nikolajevs/PCB_EU/softwareEU/README.md

# GI — контроллер PCB_EU

Автоматизированная система управления гроубоксом на базе ESP32: климат-контроль, освещение, вентиляция, автополив и обогрев с веб-интерфейсом управления и облачной телеметрией.

Целевая плата: [PCB_EU](../hardware/PCB_EU/README.md), модуль **ESP32-WROOM-32E-N4, 4 МБ flash, без PSRAM**. Распиновка и состояния выходов взяты из разделов «GPIO и обязательные изменения прошивки» и «nDIM, UVLO и состояния при сбросе» в [DESIGN.md](../hardware/PCB_EU/DESIGN.md). Общее описание — в [README репозитория](../README.md).

## Подключения и выходы PCB_EU

| Функция | Было, GPIO | PCB_EU, GPIO |
|---|---:|---:|
| LED, общий nDIM | 4 | 25 |
| PWM fan1 / fan2 | 13 / 33 | 26 / 27 |
| Тахо fan1 / fan2 | не использовались | 34 / 35 |
| Нагреватель PTC 100 Вт | 27 | 32 |
| Помпа | 25 | 33 |
| Поплавок | 32, INPUT_PULLUP | 14, INPUT, внешняя подтяжка 10k |
| SD CS | 5 | 13 |
| SD SCK / MOSI / MISO | 18 / 23 / 19, по умолчанию SPI | 18 / 23 / 19, явно заданы |
| I²C SDA / SCL | 21 / 22 | 21 / 22, явно заданы |
| RTC, адрес I²C | PCF8563 0x51 / DS3231 0x68 | MCP7940N 0x6F |

`Board.h` задаёт единственную распиновку PCB_EU. Первые действия `setup()` — `OUTPUT LOW` для GPIO25, GPIO32 и GPIO33: LED, PTC и помпа выключены до инициализации шин, NVS и сети. GPIO32 всегда остаётся выходом: он управляет нагревателем 100 Вт, вход и `INPUT_PULLUP` на нём запрещены. GPIO hold на силовых выходах не используется.

Fan PWM — **25 кГц**, с инверсией duty из-за AO3422: логические 0 → GPIO HIGH (минимум/останов вентилятора, если он поддерживает останов); логические 255 → GPIO LOW (полный ход). `fan1`/`fan2` в API и CSV сохраняют логическую шкалу 0–255. При старте GPIO26/27 устанавливаются в LOW; при сбросе/Hi-Z вентиляторы также идут на полном ходу при наличии 12 В. Ошибка настройки PWM оставляет LED/PTC/помпу выключенными, вентиляторы — на полном ходу.

LED nDIM — **1 кГц, 8 бит**. Ноль означает выключение; ненулевой duty ограничен снизу тремя отсчётами (**11,71875 мкс**, не менее 10 мкс). Так же ограничен и промежуток LOW: запрос 254 (промежуток 7,8 мкс) округляется до 255, то есть до постоянного HIGH; 253 оставляет промежуток 11,7 мкс. В состоянии/API/CSV отражается фактически выбранный duty LED.

LED использует канал LEDC 0, вентиляторы — каналы 2 и 3 (`ledcAttachChannel()`). В ядре 3.3.x таймер LEDC выбирается не по номеру канала, а по частоте и разрядности: каналы с одинаковыми частотой и разрядностью делят один таймер. LED (1 кГц) и вентиляторы (25 кГц) поэтому всегда на разных таймерах, и настройка 25 кГц не меняет частоту света. Сборка проверяет `LED_PWM_FREQ != FAN_PWM_FREQ`.

Поплавок замыкает GPIO14 на GND: LOW = вода есть, HIGH = воды нет; подтвердите это на установленном датчике. GPIO34/35 используются только как входы тахо с внешними подтяжками. Импульсы считает аппаратный счётчик PCNT (по спаду) с фильтром помех 10 мкс: наводки от ШИМ на кабеле вентилятора не превращаются в ложные обороты, и прерывание на каждый импульс не нужно. `/api/status` отдаёт `fan1_rpm` и `fan2_rpm`, обновляемые раз в секунду, исходя из двух импульсов на оборот. Ноль означает отсутствие импульсов; больше 15 000 об/мин считается помехой, и вместо числа отдаётся `null`. Обороты не влияют на климат, полив или защиту.

## Часы MCP7940N

Регистры читаются и записываются напрямую через `Wire` по адресу **0x6F**. RTClib используется только для `DateTime` и календарной арифметики. При инициализации включается `VBATEN`; корректно работающие часы сохраняют время. Остановленный календарь не запускается автоматически: сначала выставьте полную дату/время через веб-интерфейс.

Запись времени останавливает генератор, ожидает сброса `OSCRUN`, затем записывает отдельно месяц и год (регистры 0x05–0x06) и после них секунды–число (0x00–0x04) в формате **24 часа** с `VBATEN=1`. Так число никогда не загружается при старом месяце, например 31-е при 30-дневном месяце. Последним устанавливается `ST=1`, после чего прошивка ждёт `OSCRUN=1`. Каждый обмен проверяется; ожидания ограничены тремя секундами, потому что кварц на холоде может запускаться дольше секунды. Дедлайн работающей помпы проверяется и во время этих ожиданий. Запись подтверждается повторным чтением даты/времени. Каждый неудачный шаг пишется в консоль: что именно не получилось и что проверить на плате.

Если запись или проверка не удались, прошивка снова останавливает часы (`ST=0`). Раньше неподтверждённое время через минуту могло снова стать доверенным при автовосстановлении. Теперь до успешной повторной установки часы считаются невыставленными. Страница настроек после отправки формы ждёт итог от платы и показывает «записано и проверено» или «не приняли время».

Время считается достоверным только при `ST=1`, `OSCRUN=1`, `VBATEN=1`, корректных BCD, дне недели 1–7 и существующей дате в диапазоне 2024–2099. Один последовательный обмен читает все семь календарных регистров с аппаратной защитой от переноса секунды/даты. `PWRFAIL` после штатной работы от батарейки не делает время недостоверным.

Чтение часов повторяется до трёх раз: одиночный сбой I²C больше не выбивает часы из доверия. Если не помогли и повторы, `clock_trusted=false`: новый полив блокируется. Уже идущий полив доводится до конца по `millis()` — раньше любой сбой чтения выключал помпу, а день уже был отмечен как политый, и растения оставались без воды до завтра. Резервный отсчёт через `millis()` сохраняет время для интерфейса, климата и CSV, но не разрешает полив. Автовосстановление требует трёх успешных проверок с интервалом 30 секунд; ручная установка разрешает полив только после успешного чтения MCP7940N. CR2032 питает часы только при включённом `VBATEN`.

`/api/status` отдаёт `rtc_status`: `ok` (часы читаются), `not_set` (микросхема отвечает, но часы остановлены или дата неверна) или `no_response` (нет ответа по I²C), и `time_set`: итог последней установки часов (`none`, `pending`, `ok`, `failed`). Главная страница по ним показывает «Часы не выставлены», «Часы RTC не отвечают» или «Проверка часов» (часы снова читаются, доверие вернётся примерно через минуту).

## Измерение мощности INA226

INA226 на I²C **0x40** измеряет всё, что плата берёт от блока питания 24 В: свет, обогрев, вентиляторы, насос и саму электронику. Шунт 5 мОм (два 0R01 2512 параллельно) стоит в обратном проводе после Q102, напряжение берётся с +24V_FUSED через R113 1 кОм. Значения взяты из раздела «Измерение мощности (INA226)» в `hardware/PCB_EU/DESIGN.md` (изменение платы — PR #70). Пока INA226 нет на плате, главная просто показывает «нет данных».

- При старте и затем раз в 30 секунд, пока микросхема не найдена, прошивка проверяет ID производителя (0xFE = 0x5449) и записывает конфигурацию 0x4727 (усреднение 64, 1,1 мс) и калибровку 2048.
- Раз в секунду из `loop()` читаются напряжение шунта и шины: ток = код × 2,5 мкВ / 5 мОм, напряжение = код × 1,25 мВ × 1,0012 (поправка на R113), мощность = напряжение × ток.
- Раз в 30 секунд прошивка сверяет регистр конфигурации и при расхождении (микросхема сбросилась при просадке) записывает его заново. Три неудачных чтения подряд — показания пропадают, поиск снова раз в 30 секунд.
- Энергия за сегодня (кВт·ч) считается с полуночи или с последнего включения платы.
- Без калибровки показания точны примерно до ±3–5%. Поправка тока задаётся на вкладке «Общее» (`power_cal_pct`, от −20 до +20%).

Мощность только показывается и пишется в журнал: управление светом, обогревом и поливом от неё не зависит. Если INA226 не отвечает, главная показывает «нет данных», всё остальное работает как обычно. Ниже 21,6 В главная предупреждает о низком напряжении питания.

В `/api/status` добавлены `power_ok`, `bus_v`, `current_a`, `power_w`, `bus_low` (последние четыре — только при `power_ok=true`) и `energy_kwh`. В Ubidots уходит переменная `power` (Вт). В CSV последним столбцом добавлен `power_w`: средняя мощность за 10-минутный интервал, пустая, если в этот интервал данных не было.

## Возможности

На главной странице показатели расположены попарно: температура и влажность; вентиляторы 1 и 2; потребление и лампа; насос и обогреватель в блоке «Силовые цепи». Две колонки сохраняются на телефоне. В режиме сушки лампа и насос скрыты, потребление и обогреватель занимают свои ряды целиком.

- **Климат-контроль** — датчик SHT4x (температура/влажность), поддержание заданной температуры с гистерезисом
- **Освещение** — управление LED по расписанию день/ночь, яркость связана с температурным контролем
- **Вентиляция** — два независимых канала PWM-управления вентиляторами (fan1/fan2) с настраиваемыми мин/макс пределами
- **Автополив** — планировщик по дням недели (битовая маска), защита от повторного срабатывания
- **Обогрев** — PTC 100 Вт с гистерезисом, три режима расписания: день/ночь/всегда, жёсткий предел 60 °C
- **Мощность** — INA226: ватты, вольты, амперы и кВт·ч за сегодня на главной, в CSV и Ubidots
- **Безопасность** — аварийное отключение при потере связи с датчиком SHT4x, защита от деления на ноль в расчётах
- **Веб-интерфейс** — вкладки настроек, интерактивные SVG-графики с тултипами, статика лежит в SPIFFS
- **Хранение данных** — логирование в CSV на SD-карту, настройки — в NVS (Preferences)
- **Облако** — телеметрия в Ubidots по HTTPS через отдельную FreeRTOS-задачу на Core 0

## Структура проекта

```
softwareEU/
├── softwareEU.ino     # основная прошивка ESP32
├── Board.h          # GPIO PCB_EU, PWM, тахометры, константы INA226
├── Safety.h         # календарь, MCP7940N, полив, антидребезг, термостат обогрева
├── UbidotsCA.h      # корневой сертификат ISRG Root X1 для HTTPS Ubidots
├── SafetyTests.h    # проверки, выполняемые при каждой сборке
└── data/            # файлы веб-интерфейса (SPIFFS)
    ├── index.html
    ├── settings.html
    ├── script.js
    ├── settings.js
    └── style.css
```

## Технологический стек

- ESP32 (Arduino framework, ядро esp32 3.x — используются `ledcAttachChannel()`, `entry.path()` и драйвер PCNT `driver/pulse_cnt.h`)
- ESPAsyncWebServer + AsyncTCP
- SPIFFS (веб-интерфейс из `softwareEU/data/`, заливается через Tools → ESP32 Sketch Data Upload)
- MCP7940N (прямые I²C-регистры); RTClib только для `DateTime` и планирования день/ночь
- Adafruit SHT4x
- SD-карта (CSV-логирование)
- Ubidots (облачная телеметрия, HTTPS)

## Как устроены данные

Всё, что задаёт пользователь, лежит в `struct Settings`, всё, что происходит сейчас, — в `struct State`. Обе структуры — простые данные без `String`, и между задачами они передаются только целыми копиями под спинлоком:

- `Settings` меняет только обработчик `/save-settings`: разбирает форму в свою копию и публикует её целиком. `loop()` раз в секунду берёт свежую копию, задача Ubidots — перед каждой отправкой.
- `State` пишет только `loop()`, в свою рабочую копию `state`, и публикует её в конце каждой итерации. Веб и Ubidots читают `stateSnapshot()`.

Каждая настройка описана одной строкой в таблице `SETTING_DEFS`: имя в форме и JSON, ключ NVS, диапазон, значение по умолчанию. Из неё работают загрузка из NVS, разбор формы, сохранение и `/api/settings`. Чтобы добавить настройку, нужно поле в `Settings` и строка в таблице; если тип строки не совпадёт с типом поля, прошивка не соберётся.

Пространство NVS `grow-box`, ключи настроек, `last_water`, пароли и маркеры миграций сохранены. Обновление прошивки не требует очистки NVS; при загрузке выбирайте сохранение flash, без полного стирания. Ключи NVS в таблице менять нельзя: по ним читаются сохранённые значения.

## Веб-API

| Метод | Путь | Назначение |
|---|---|---|
| GET | `/api/status` | Текущее состояние (снимок `State`) и режим `operation_mode`: климат, выходы, обороты, часы (`rtc_status`, `time_set`), поплавок (`water_present`), день последнего полива (`last_water_day`), мощность |
| GET | `/api/settings` | Все настройки. Пароли и токен **не отдаются** — только флаги `wifi_pass_set` / `ap_pass_set` / `ubidots_token_set` |
| GET | `/api/console` | Кольцевой буфер сообщений Serial |
| GET | `/api/log?date=YYYY-MM-DD` | CSV-лог за день. Формат даты проверяется строго |
| GET | `/api/files` | Последние файлы в корне SD |
| POST | `/api/clearlogs` | Удаляет из корня SD файлы `*.csv`. Именно POST: GET-версию можно было вызвать со сторонней страницы |
| POST | `/save-settings` | Сохранение настроек. Пустое поле пароля/токена = «не менять»; стереть пароль — галочкой «сеть без пароля». Пустая дата начала сбрасывает цикл. Ответ — редирект на `/settings?saved=1` или `?error=…` |
| POST | `/set-time` | Установка часов, с секундами или без. Применяется в `loop()`, к I2C обращается только он. Ответ — редирект на `/settings?time=1`; итог страница берёт из `time_set` в `/api/status` |

## Примечание по безопасности

Учётные данные WiFi и Ubidots хранятся в NVS Preferences. В исходниках нет рабочих паролей и токенов. Все страницы и API требуют входа `admin` с индивидуальным паролем устройства (HTTP Digest). Изменяющие запросы дополнительно требуют CSRF-токен; очистка SD доступна только через POST.

Сохранённые пароли и токен не возвращаются через API. Пустое поле пароля/токена означает «оставить прежнее значение». Для открытой сети роутера и отключения облака есть отдельные флажки удаления секрета. Точка доступа самой платы всегда защищена паролем.

Ubidots использует HTTPS с проверкой сертификата через ISRG Root X1. Для проверки срока сертификата плата синхронизирует системное UTC-время через NTP; это не изменяет локальное расписание MCP7940N. При недоступности доверенного TLS-соединения данные не отправляются; небезопасного fallback нет. Корневой сертификат находится в `softwareEU/UbidotsCA.h` и может требовать обновления при смене цепочки сервера.

Локальный веб-интерфейс остаётся HTTP: Digest не шифрует содержимое страниц и форм. Используйте защищённую точку доступа/доверенную LAN, не публикуйте порт 80 в Интернет.

### Обновление существующего устройства

1. Прошейте `softwareEU/softwareEU.ino` и обязательно обновите файлы SPIFFS из `softwareEU/data/`: старый интерфейс не передаёт CSRF-токен.
2. Откройте USB Serial Monitor, 115200 бод, и перезагрузите плату. В USB-консоли появятся `AP password` и `Web login: admin / ...`. Эти строки не попадают в веб-журнал.
3. При первом запуске этой версии пароль точки доступа заменяется случайным. Переподключитесь с паролем из USB-консоли и войдите в браузере. Пароли сохраняются между перезагрузками.
4. Ранее опубликованные пароль роутера и токен Ubidots необходимо заменить у соответствующих провайдеров и в настройках платы. Удаление из текущего файла не отзывает секреты и не удаляет их из истории Git. Существующие значения в NVS сохраняются до явной замены пользователем.
5. Проверьте дату/время и `clock_trusted`. При недостоверном MCP7940N полив блокируется до подтверждённой установки времени или восстановления часов; резервное время само по себе не разрешает полив.

На чистом NVS обогрев выключен. Существующий выбранный пользователем режим сохраняется.

Генерируемые пароли администратора и точки доступа состоят из **8 символов** (цифры и заглавные латинские буквы без похожих `0`, `1`, `I`, `O`). При обновлении длинный пароль администратора заменяется; пароль AP старого формата — ровно 32 строчные шестнадцатеричные цифры — заменяется однократно. Это распознавание по формату: вручную заданный пароль того же формата также будет заменён. Остальные пользовательские пароли AP сохраняются. Новые значения видны в USB-консоли, повторного сброса при перезагрузке нет. CSRF-токен сохраняет прежнюю длину.

Настройки света находятся на отдельной вкладке «Освещение».

Полив измеряет длительность через `millis()`, включая его переполнение; изменение календарного времени или настроек длительности не меняет уже запущенный цикл. День запуска записывается в NVS **до** включения насоса. При ошибке записи насос не включается. После перезапуска прерванный полив не возобновляется и не повторяется в тот же день.

Если плата в назначенное время была без питания или перезагружалась, полив начинается с опозданием, но не позже чем через 4 часа (`WATERING_CATCHUP_SEC`). Догоняется только простой платы: после изменения расписания, режима или часов через веб-интерфейс время, прошедшее сегодня раньше, не догоняется — иначе сохранение настроек днём сразу запускало бы насос.

Если отметка последнего полива оказалась в будущем (часы когда-то стояли неверно, потом их исправили), она сдвигается на сегодня: сегодня повтора нет, с завтрашнего дня полив идёт как обычно. Раньше такая отметка блокировала полив до своей даты.

Датчик уровня воды читается с антидребезгом: «воды нет» засчитывается после 2 секунд непрерывно (`WATER_DEBOUNCE_MS`), чтобы колыхание воды при работающем насосе не обрывало полив.

### Климат: обогрев и вентиляторы

- **Growing.** Обогреватель включается при `цель − дельта` и выключается на цели. Пока он включён, вентиляторы держатся на минимуме, чтобы не выдувать тепло.
- **Жёсткий предел.** При 60 °C (`HEATER_HARD_LIMIT_C`) обогрев выключается при любых настройках. Нечисловое показание или порог тоже выключают обогрев. Раньше значение «nan» в поле температуры проходило проверку, и нагреватель мог остаться включённым до аварийного порога датчика 80 °C. Теперь «nan» и «inf» из формы игнорируются (остаётся прежнее значение), а из NVS заменяются значением по умолчанию.
- **Drying.** Обогреватель включается при `цель − гистерезис` и выключается при `цель + гистерезис`. Вентиляторы управляются влажностью; на максимум по температуре они переходят только при `цель + 2 × гистерезис`, выше порога выключения обогревателя.
- **«Никогда»** в режиме обогревателя запрещает обогрев в обоих режимах. Расписание день/ночь действует только в Growing.

Главная страница показывает режим (в сушке — значок «Сушка» вместо дня/ночи и дня цикла), состояние часов, если им нельзя доверять, и «Нет связи», если плата не отвечает дольше 10 секунд. В сушке блоки лампы и насоса с главной скрываются: свет и полив в этом режиме выключены всегда.

Под процентами вентиляторов показаны обороты. Если вентилятор на 30% и больше (округлённо), а сигнала оборотов нет дольше 30 секунд, появляется подсказка «нет сигнала оборотов»: вентилятор стоит или не подключён провод тахометра. В блоке насоса видны состояние поплавка и день последнего полива по расписанию. Если в этот день насос не включался (бак пуст, ошибка записи в NVS, отметка сдвинута из будущего), рядом стоит «пропущен» (`last_water_skipped` в `/api/status`; после перезагрузки эта пометка сбрасывается). Карточка «Питание платы» показывает ватты, вольты, амперы и кВт·ч за сегодня. Под графиком климата — отдельный график мощности из CSV, а подсказка на графике климата показывает и мощность.

Страница настроек открывается на вкладке «Климат». После сохранения она возвращается на вкладку, с которой отправили форму.

### Сборка и проверки

Целевая конфигурация: двухъядерный **ESP32 Dev Module**, Arduino-ESP32 **3.3.8**, Flash Size **4 MB**, PSRAM **Disabled**, стандартная таблица разделов **Default 4MB with SPIFFS**. FQBN `esp32:esp32:esp32` использует эти параметры по умолчанию. NVS и SPIFFS остаются отдельными разделами; веб-файлы загружаются из `softwareEU/data/`. Arduino core 2.x не поддерживается (используется LEDC API 3.x).

Библиотеки проверяемой сборки:

- ESP Async WebServer 3.11.0, Async TCP 3.4.10;
- RTClib 2.1.4;
- Adafruit SHT4x Library 1.0.5, Adafruit BusIO 1.17.4, Adafruit Unified Sensor 1.1.15.

Команды выполняются из корня репозитория:

```sh
arduino-cli compile --fqbn esp32:esp32:esp32 softwareEU
node --test tests/settings.test.cjs
```

Каждая сборка автоматически выполняет compile-time проверки календаря, MCP7940N (`ST`, `OSCRUN`, `VBATEN`, BCD, запись/чтение 24-часового календаря, нормальный `PWRFAIL`), длительности LED-импульсов и промежутков на всём диапазоне duty, инверсии вентиляторов, раздельных таймеров, резервного отсчёта, переполнения `millis()`, допуска и догона полива, сдвига отметки полива, антидребезга датчика уровня, отбрасывания NaN/inf в настройках, термостата обогрева (гистерезис, расписание, NaN, предел 60 °C), пересчёта регистров INA226 и оборотов из `SafetyTests.h`, без затрат памяти/времени на плате. Тесты интерфейса проверяют скрытие секретов, передачу CSRF во всех формах, POST при очистке, подтверждение смены режима и обновление консоли.

Прошивка занимает около 96% раздела приложения (1,25 МБ в схеме Default 4MB). Если новая функция перестанет помещаться, можно перейти на схему «Minimal SPIFFS (1.9MB APP with OTA)»; после смены схемы файлы SPIFFS нужно залить заново.

### Проверки на стенде

Эти проверки требуют собранной PCB_EU и не выполняются командой сборки:

- Холодный старт, EN/reset и провалы питания: осциллографом подтвердить LOW на GPIO25/32/33, отсутствие импульса PTC/помпы и полный ход вентиляторов до запуска управления. Проверить аппаратную блокировку LED при UVLO/PGOOD.
- LED: 0, минимальная ненулевая яркость, 50%, 100%; измерить 1 кГц, импульсы не короче 10 мкс и выключение в Drying. Подключение второго вентилятора не должно менять частоту LED.
- Оба вентилятора: 0/50/100%, 25 кГц и инверсия; отключение PWM → полный ход. Сверить `fan1_rpm`/`fan2_rpm` с тахометром, подтвердить два импульса на оборот и что фильтр 10 мкс не теряет импульсы на максимальных оборотах; отключение тахо не должно менять управление.
- PTC: режим «Никогда», день/ночь, Growing/Drying, гистерезис и отказ SHT4x. При отказе датчика нагрев выключен; проверить, что GPIO32 нигде не становится входом. Проверить жёсткий предел: цель сушки 50 °C и гистерезис 20 °C (порог выключения 70 °C), нагреть датчик до 60 °C — обогрев должен выключиться именно на 60 °C, в консоли появится «[Heater] Off: temperature reached the 60 C hard limit». При обычных настройках обогрев выключает сам термостат, и проверка предела ничего не показывает.
- INA226: ответ на 0x40 и строка «Найден на 0x40» в консоли; сверить ток с мультиметром в разрыве 24 В при свете 0/50/100% и включённом PTC, подобрать `power_cal_pct`. Отключение INA226 (например, снятие с шины) → «нет данных» без влияния на управление. Ниже 21,6 В — предупреждение на главной.
- MCP7940N: установка времени (в том числе 31-го числа и 29 февраля), регистры `ST=1`, `VBATEN=1`, `OSCRUN=1`, 24 часа; переход через полночь/месяц; отключение основного питания с исправной CR2032 сохраняет время. Остановка/снятие батарейки, неверные BCD/дата, отсутствие RTC и сбой записи блокируют полив; после неудачной установки часы остаются остановленными, страница настроек сообщает об ошибке. Подтвердить восстановление после трёх проверок.
- Полив: поплавок и обрыв его провода, антидребезг 2 с, длительность по `millis()`, отказ RTC при работающей помпе (полив доходит до конца), смена времени во время полива, перезагрузка в минуту полива, догон до 4 часов и отсутствие повторного запуска по `last_water`.
- Веб: вход Digest, отказ без входа и с неверным/отсутствующим CSRF, все вкладки и расписания, SSID с кавычкой, секреты не возвращаются в API. Перезагрузка сохраняет настройки, пароли и `last_water` в прежних ключах NVS.
- SD на CS13: создание/чтение/очистка только CSV, сохранение формата и логического duty; отсутствие карты не мешает вебу/климату. Загрузить SPIFFS и проверить страницы на 4 МБ flash.
- Ubidots: отправка через доверенный HTTPS, отсутствие отправки при ошибке TLS, сохранение работы AP и локального расписания при недоступности WiFi/NTP/облака.
