nikolajevs/PCB_EU/hardware/PCB_EU_LITE/README.md

# EU-LITE — дешёвый аналог EU-0.1 из деталей со склада

**Состояние на 26.10.2026: документация согласована с текущими исходниками; стендовые испытания не выполнены.** Плата 100×100 мм, четыре слоя, 163 посадки. Исправлены силовая медь входа и LED-каскада, переходные в пасте и локальная земля ESP32. Подключение Q102/Q701/Q702/Q703, ST1S14 и ST1S10 сохранено: замечание о перепутанных выводах снято.

**Выпуск изготовления пока не закрыт.** Последний полный прогон KiCad 10.0.7 сохранён в [review/power-copper-2026-10-26/](review/power-copper-2026-10-26/), но предшествует исправлению подписи F103. Сейчас схема содержит `6.3 A fast`, плата — старое поле `6.3 A slow`: электрические соединения совпадают, строгий паритет и `fabricate.py` не проходят из-за этого поля. Gerber r1/r2 устарели относительно текущей меди. Перед изготовлением нужно согласовать поле F103, повторить полный профиль и выпустить новый комплект Gerber/Excellon. Эта редакция документации схему, плату, BOM и отчёты проверок не изменяет.

Проект по образцу [cheap-version](https://github.com/nikolajevs/ai/tree/7fa9410ddb7977c46e313506acb037693ad571e1/hardware/cheap-version) (дешёвая PCB_V1 из того же склада): всё, что есть на складе владельца ([stock/sklad-2026-10-24.csv](stock/sklad-2026-10-24.csv)), берётся оттуда; недостающее — из [снимка каталога цен Salvats / Electrobase от 23.10.2026](procurement_lite.json). Отличия от EU-0.1, расчёты и открытые вопросы — в [DESIGN.md](DESIGN.md).

**F103:** `3413.0224.11` — SCHURTER **USI 1206, 6,3 А, Quick-Acting F (fast)** ([даташит](https://us.schurter.com/pdf/english/typ_usi_1206.pdf)). MPN и BOM сохранены; пуск LED и согласование I²t требуют измерения. F101 `3413.0330.11` и F102 `3413.0327.11` — UST 1206 time-lag; название карточки магазина не заменяет характеристику изготовителя.

## Что сохранено и что убрано

Сохранено: вход 24 В с защитой от переполюсовки и предохранителями, ESP32-WROOM-32E-N4 (те же GPIO), 12 В и 3,3 В, **один** LED-канал LM3429 (около 75 Вт / 1,55 А при 48 В суммарно на J501/J502/J503), **RGB-светодиод статуса** (GPIO4/16/17), PTC 100 Вт, помпа 24 В, два вентилятора 12 В с PWM, измерение мощности (INA238 вместо INA226), RTC MCP7940N с CR2032, microSD, SHT4x и поплавок.

Добавлено по просьбе владельца 24.10.2026: RGB-светодиод для индикации статуса и процессов (лист «Status»).

Убрано по решению владельца 24.10.2026: второй LED-канал (линейки) и тахометры вентиляторов. Дополнительно, для цены: аппаратная блокировка LED по UVLO/PGOOD (LM2903 + BAT54), USBLC6 на входе поплавка, ESD-диоды вентиляторов и радиатор с изоляцией. Последствия — в [DESIGN.md](DESIGN.md#отличия-от-eu-01) и [DESIGN.md, «Открытые вопросы»](DESIGN.md#открытые-вопросы).

## Файлы

| Файл | Назначение |
|---|---|
| [DESIGN.md](DESIGN.md) | Решения, отличия от EU-0.1, расчёты, склад без запаса, открытые вопросы |
| [PCB_EU_LITE.kicad_pro](PCB_EU_LITE.kicad_pro), [PCB_EU_LITE.kicad_sch](PCB_EU_LITE.kicad_sch) и 8 листов | Схема (KiCad 10, генерируется `tools/generate.py`) |
| [PCB_EU_LITE.kicad_pcb](PCB_EU_LITE.kicad_pcb), [placement.json](placement.json) | 163 посадки, четырёхслойная плата; статус паритета и изготовления — в разделе «Проверки» |
| [BOM_allocated.csv](BOM_allocated.csv), [BOM_allocated.json](BOM_allocated.json) | Склад (`stock`, с остатком после сборки) и докупка (`buy`, с URL и датой цены) |
| [procurement_lite.json](procurement_lite.json) | Снимок каталога с резисторами уставки LED 4,7 кОм/620 Ом и карточкой OSTAPA57E2A владельца |
| [stock/sklad-2026-10-24.csv](stock/sklad-2026-10-24.csv) | Склад владельца (копия присланной выгрузки) |
| [design.json](design.json) | Полная спецификация выводов, цепей и компонентов |
| [review/connectivity.txt](review/connectivity.txt) | Сохранённый предыдущий полный прогон; актуальные 58 проверок для 75 Вт описаны в разделе «Проверки» |
| [review/Bench_checklist.md](review/Bench_checklist.md) | Что измерить при первом включении |
| [review/silkscreen.json](review/silkscreen.json) | Аудит воспроизводимой сборочной шелкографии: размещённые, нативные и намеренно пропущенные метки |
| [libraries/](libraries) | Символы проекта; собственные посадки PowerDI5, DTMSS-27, VSSOP-10 и SOIC-8; локальная копия BC-2001 с узким коридором GND только для EU-LITE и локальные копии складских посадок; стандартные 3D-модели используют установленную библиотеку KiCad |
| [tools/route_power.py](tools/route_power.py), [tools/route_complete.py](tools/route_complete.py), [tools/route_progress.py](tools/route_progress.py), [tools/route_bt_ground.py](tools/route_bt_ground.py), [tools/route_rtc.py](tools/route_rtc.py), [tools/route_switch_stage.py](tools/route_switch_stage.py), [tools/route_ground_stitch.py](tools/route_ground_stitch.py), [tools/route_prune_stubs.py](tools/route_prune_stubs.py), [tools/route_led_source.py](tools/route_led_source.py), [tools/route_led_terminals.py](tools/route_led_terminals.py), [tools/silkscreen.py](tools/silkscreen.py) | Полигонная медь, воспроизводимые шаги частичной разводки и финальная сборочная шелкография |

`EU_Mechanical` и `EU_Parts` по-прежнему общие с EU-0.1 (`../PCB_EU/libraries`, см. `fp-lib-table`); исключение — `LITE_Mechanical:Battery_COMF_BC-2001`, локальная копия с коридором GND для батарейного контакта. Исходные библиотеки EU-0.1 не менялись.

## Закупка

**Electrobase** — 20,06 € с НДС (0,85 € — цена из карточки, присланной владельцем 25.10.2026)

| Деталь (артикул) | Шт. к покупке | Цена, € | Сумма, € | Позиции на плате |
|---|---:|---:|---:|---|
| [ABS07-32.768KHZ-7-T](https://electrobase.lv/katalogs/kvarca-generatori-tht/resonator-ceramic-32768khz-20ppm-7pf-smd-32x15x09mm) | 1 | 0.79 | 0.79 | Y301 |
| [AO3422](https://electrobase.lv/katalogs/tranzistori-ar-n-veida-kanalu-smd/transistor-n-mosfet-unipolar-55v-17a-800mw-sot23) | 5 (пачка по 5, нужно 3) | 0.26 | 1.30 | Q411 Q421 Q704 |
| [C1206C100J5GACTU](https://electrobase.lv/katalogs/kondensatori-mlcc-smd-0201/capacitor-ceramic-mlcc-10pf-50vdc-c0g-5-smd-1206) | 2 | 0.25 | 0.50 | C301 C302 |
| [ESP32-WROOM-32E-N4](https://electrobase.lv/katalogs/moduli-iot-wifi-bluetooth-lora/module-iot-bluetooth-low-energywifi-smd-0) | 1 | 7.48 | 7.48 | U202 |
| [JNRH1207-220M-A](https://electrobase.lv/katalogs/induktori-tht/inductor-wire-smd-22uh-ioper-54a-r-525o-30-isat-56a) | 1 | 0.54 | 0.54 | L101 |
| [OSTAPA57E2A](https://electrobase.lv/katalogs/diodes-led-tht-18mm/led-rgb-5mm-140deg-front-convex-231vdc-noof-term-4-round) | 1 | 0.85 | 0.85 | D901 |
| [LM3429MH/NOPB](https://electrobase.lv/katalogs/led-draiveri/ic-driver-boostbuck-boost-led-driver-htssop14-5a-372v-ch-1) | 1 | 4.86 | 4.86 | U501 |
| [MCP7940N-I/SN](https://electrobase.lv/katalogs/rtc-shemas/ic-rtc-circuit-i2c-sram-64bsram-1855vdc-so8-4085degc-tube-0) | 1 | 1.50 | 1.50 | U301 |
| [MEM2061-01-188-00-A](https://electrobase.lv/katalogs/savienojumi-kartem/connector-cards-microsd-push-push-smt-gold-flash-pin-8-0) | 1 | 1.74 | 1.74 | J301 |
| [SMBJ26A-E3/52](https://electrobase.lv/katalogs/diodes-transil-smd-vienvirziena/diode-tvs-600w-289319v-143a-unidirectional-5-smbj) | 1 | 0.50 | 0.50 | D101 |

**Salvats** — 12,56 € с НДС

| Деталь (артикул) | Шт. к покупке | Цена, € | Сумма, € | Позиции на плате |
|---|---:|---:|---:|---|
| [3403.0166.11](https://www.salvats.lv/lv/drosinataji-smd-10x3x3mm-umt-leni/1a-umt-drosinataji-leni-250vac125vdc-101x3x3mm-smd) | 1 | 0.75 | 0.75 | F105 |
| [3403.0169.11](https://www.salvats.lv/lv/drosinataji-smd-10x3x3mm-umt-leni/2a-umt-drosinataji-leni-250vac125vdc-101x3x3mm-smd) | 2 | 0.78 | 1.56 | F104 F401 |
| [3413.0224.11](https://www.salvats.lv/lv/drosinataji-smd-1206-32x16x06mm/drosinatajs-smd-1206-63a-63v-fast) | 1 | 0.86 | 0.86 | F103 |
| [3413.0327.11](https://www.salvats.lv/lv/drosinataji-smd-1206-32x16x06mm/drosinatajs-smd-1206-8a-63v-fast) | 1 | 0.80 | 0.80 | F102 |
| [3413.0330.11](https://www.salvats.lv/lv/drosinataji-smd-1206-32x16x06mm/drosinatajs-smd-1206-15a-63v-fast) | 1 | 0.75 | 0.75 | F101 |
| [BAT-CR2032/P](https://www.salvats.lv/lv/litija-baterijas/cr2032-litija-baterija-30v-o20x32mm-panasonic-442g) | 1 | 0.75 | 0.75 | комплектующее (CR2032 для BT301) |
| [BC-2001](https://www.salvats.lv/lv/baterijas-turetaji-1/bateriju-turetajs-metaliska-cemme-cr2032-1-baterija) | 1 | 0.33 | 0.33 | BT301 |
| [BC847B-DIO](https://www.salvats.lv/lv/npn-tranzistori-smd/bc847b1f-smd-tranzistors-npn-50v-01a-300mhz-sot23) | 4 | 0.06 | 0.24 | Q701 Q901 Q902 Q903 |
| [BC857B](https://www.salvats.lv/lv/pnp-tranzistori-smd/bc857b3f-smd-tranzistors-pnp-50v-01a-hfe220475-035w-200mhz-sot23) | 1 | 0.08 | 0.08 | Q702 |
| [BZV55C12](https://www.salvats.lv/lv/stabilitroni-smd-bzv55/12v-stabilitrons-smd-bzv55-5-05w-minimelf) | 1 | 0.13 | 0.13 | D103 |
| [C1206C102JCGACTU](https://www.salvats.lv/lv/kondensatori-keramiskie-smd-1206-1/1nf-1206-c0g-500v-5-smd-kondensators-1206) | 1 | 0.25 | 0.25 | C506 |
| [CL31C101JBCNNNC](https://www.salvats.lv/lv/kondensatori-keramiskie-smd-1206-1/100pf-1206-npo-50j-smd-kondensators-1206) | 1 | 0.07 | 0.07 | C507 |
| [CRCW1206620RFKTABC](https://www.salvats.lv/lv/rezistori-smd-1206-025w/620r-1206-1-smd-rezistors-1206) | 1 | 0.03 | 0.03 | R506 |
| [CRCW120682K0FKTABC](https://www.salvats.lv/lv/rezistori-smd-1206-025w/82k-1206-1-smd-rezistors-1206) | 1 | 0.03 | 0.03 | R101 |
| [CS2512-0R15-1%-HP](https://www.salvats.lv/lv/rezistori-smd-2512-1w3w/0r15-2512635x32mm-2w-1-smd-55125c-rezistors-thick-film-2512) | 1 | 0.32 | 0.32 | R502 |
| [CSD19531KCS](https://www.salvats.lv/lv/100v-n-fet-tht/csd19531kcs-tranzistors-n-fet-100v-vgs2233v-20v-100a-214w-0r0073-to-220) | 1 | 2.95 | 2.95 | Q703 |
| [LRP2512-R040-1%](https://www.salvats.lv/lv/rezistori-smd-2512-1w3w/0r04-2512635x32mm-3w-1-smd-55170c-rezistors-thick-film-2512) | 1 | 0.38 | 0.38 | R501 |
| [SMD1206 4K7 1%](https://www.salvats.lv/lv/rezistori-smd-1206-025w/4k7-1206-1-smd-rezistors-1206) | 1 | 0.04 | 0.04 | R505 |
| [SMD1206 56K 1%](https://www.salvats.lv/lv/rezistori-smd-1206-025w/56k-1206-1-smd-rezistors-1206) | 1 | 0.03 | 0.03 | R507 |
| [SMD1206-10K-1%](https://www.salvats.lv/lv/rezistori-smd-1206-025w/10k-1206-1-smd-rezistors-1206) | 1 | 0.03 | 0.03 | R108 |
| [SMD1206-33K-1%](https://www.salvats.lv/lv/rezistori-smd-1206-025w/33k-1206-1-smd-rezistors-1206) | 1 | 0.03 | 0.03 | R509 |
| [SMD1206-6K2-1%](https://www.salvats.lv/lv/rezistori-smd-1206-025w/6k2-1206-1-smd-rezistors-1206) | 2 | 0.03 | 0.06 | R102 R508 |
| [UPW1H221MPD](https://www.salvats.lv/lv/kondensatori-elektrolitiskie-zemas-induktivitates-low-esr/22050v-105c-o10x16mm-20-kondensatori-zemas-induktivitates-011r-5000h-nichicon-ar-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) | 2 | 0.63 | 1.26 | C101 C102 |
| [USBLC6-2SC6](https://www.salvats.lv/lv/u/usblc6-2sc6-smd-mikroshema-esd-protection-sot23-6) | 1 | 0.67 | 0.67 | U401 |
| [ZL201-10G](https://www.salvats.lv/lv/listes-un-nuju-ligzdas/254mm-uz-pcb-10pin-stekers-1) | 1 | 0.16 | 0.16 | J201 |

Со склада идёт 115 шт. в 38 позициях. KF301 используются 7 из 31 шт., остаётся 24; два новых клеммника не требуют закупки. Новые резисторы уставки LED добавляют 0,01 € к прежней сумме. Для Q703 выбран каталожный CSD19531KCS в TO-220; один BSC146N10LS5 остаётся в запасе для Q501. Без запаса остаются INA238, IRL2505, дроссель DTMSS-27 и два электролита EEVFK1J471M/EEEFT1E821AP. Полный список с остатками — [BOM_allocated.csv](BOM_allocated.csv).

Для D901 выбран OPTOSUPPLY OSTAPA57E2A. Цена 0,85 € с НДС и остаток 99 шт. взяты из карточки Electrobase, присланной владельцем 25.10.2026; наличие через корзину отдельно не проверялось. CSD19531KCS для Q703 добавлен из `catalog.db`: Salvats, 2,95 € с НДС, остаток 7 шт. в снимке от 23.10.2026; корзина не проверялась. Остальные цены и остатки — снимок каталога от 23.10.2026; C1206C100J5GACTU — из BOM EU-0.1 от 23.10.2026. Доставка 2,99 € (Electrobase) + 2,88 € (Salvats) взята из README EU-0.1 и не перепроверялась. Это не оферта и не заказ. AO3422 продаётся пачками по 5: два лишних.

## Проверки

Результаты относятся к указанным состояниям проекта, а не к новому запуску при редактировании документации.

| Состояние | Результат и ограничение |
|---|---|
| Последний полный прогон меди, KiCad 10.0.7, 26.10.2026 | [Сводка](review/power-copper-2026-10-26/summary.json): ERC пройден; 0 электрических/геометрических ошибок DRC, 0 неподключённых цепей и 0 расхождений на момент прогона; 35 библиотечных предупреждений проверены как отличия только шелкографии; экспорт и независимый CAM-импорт пройдены |
| Размещение в том же прогоне | [18 791 проверка](review/power-copper-2026-10-26/placement.json), 163 посадки, 437 подключённых выводов; стороны: 125 сверху и 38 снизу |
| Силовые пути в том же прогоне | [Проверка геометрии](review/power-copper-2026-10-26/power_paths.json): 10 входных переходных связаны с J101/F101 на обеих сторонах, 0 пересечений пасты, 7 GND-переходных у ESP32, силовые LED_SW/LED_OUT/LED_POS отсутствуют на внутренних слоях |
| После исправления подписи F103 | Свежий экспорт подтвердил неизменность всех 437 подключённых узлов; ERC, 58 проверок `verify.py`, проверка схем и мутационные тесты пройдены. DRC: 0 электрических/геометрических ошибок, 0 неподключённых цепей, 35 прежних предупреждений и 1 текстовое расхождение Value F103 |
| Полный профиль после исправления F103 | **Не пройден:** `check_placement.py` останавливается на `F103: value differs`; новый производственный комплект не выпущен. Правила не ослаблялись |
| Архивы изготовления r1/r2 | Исторические комплекты для прежней меди; **не использовать для текущей платы** |
| Физические испытания | Не выполнены: сборка, корпус, пуск, динамика шин, нагрев и прошивка требуют [стендовой проверки](review/Bench_checklist.md) |

Сохранённые отчёты не перезаписываются частичной проверкой. Для нового выпуска нужен полный `tools/fabricate.py` на KiCad 10.0.7 с Python `pcbnew` той же версии, Shapely 2 и gerbonara; каталог результата должен быть новым:

```sh
python hardware/PCB_EU_LITE/tools/fabricate.py --kicad-cli /path/to/kicad-cli --output /path/to/new-release
```

Это проверка и экспорт существующих исходников; до согласования Value F103 ожидается остановка на проверке размещения.

**Размещение.** Все 163 посадочных места схемы находятся внутри платы 100×100 мм: 125 сверху, 37 SMD и BT301 с CR2032 снизу. Сохранены 4 отверстия и четырёхслойный стек. Сверху оставлены высокие и силовые компоненты; снизу размещены RGB, подтяжки microSD, RTC у батарейки, делитель вспомогательного БП и маломощное управление нагрузками. KiCad DRC и нативные проверки куртяр/коридоров прошли; физический корпус, высота деталей и ручная сборка не проверены.

**LED-выходы и мощность (25.10.2026).** Справа теперь три одинаковых KF301-2P: J501 (94;61), J502 (94;74), J503 (94;87) мм, все сверху под 90°. Вывод 1 — LED_POS после шунта R502, вывод 2 — GND; общий плюс соединён дорожкой 1 мм и локальной заливкой по F.Cu. Все три разъёма делят **один** токовый канал. R505/R506 = **4,7 кОм + 620 Ом, 1%, 1206**: примерно 1,55 А и 75 Вт суммарно при 48 В. Номинальная модель по таблице TI даёт 1,548 А / 74,3 Вт. Путь истоков Q501 к R501 теперь 0,8 мм по F.Cu с отдельной ветвью от каждого вывода; съём U501.12/TP04 сохранён у шунта.

Расчёт при 21,6 В, КПД 90%, L=43,5 мкГн, 400 кГц и допусках уставки: пик до **4,36 А**, минимальный IS-порог **5,32 А**, запас около **22%**. Нагрев не подтверждён. Общий бюджет с PTC/помпой/вентиляторами — до 8,7 А в модели, проектный предел 9 А; БП требуется 24 В / 10 А. Для 75 Вт в прошивке нужно поднять минимум nDIM до **5 отсчётов при 1 кГц/8 бит = 19,53 мкс**; сейчас `softwareEU/Board.h` даёт 3 отсчёта, эта правка и адаптация INA238 остаются открытыми. Подключаемые параллельно LED-ветви должны иметь согласованные Vf; деление тока между ними подтверждается измерением. [Расчёты и источники](DESIGN.md#led-канал).

**Симуляция LED-каскада (25.10.2026).** `tools/led_boost_simulation.py` рассчитывает установившийся режим при Vin 21,6/24/25 В и отдельно угол верхнего тока 1,627 А при 21,6 В. Для номинальной суммарной нагрузки 48 В / 1,548 А пики L501 — 3,895/3,536/3,405 А; в углу — 4,081 А. Duty подбирается к заданной рабочей точке: это условие расчёта, а не подтверждение регулирования реального LM3429. Сходимость проверена уменьшением шага примерно с 25 до 12,5 нс, балансом энергии и независимым тестом идеального boost. [Отчёт и график](review/LED_boost_simulation.md). Прежний расчёт с КПД 90% (пик 4,36 А) сохраняется как более консервативный; пуск, COMP, nDIM, OVP/КЗ, нагрев и деление тока между LED-ветвями требуют отдельной проверки.

**Разводка (26.10.2026).** После штатного `finalize_board.py` применяется `tools/repair_power.py`. Скрипт освобождает верхний путь F103–L501 от трёх малоточных пересечений, проводит питание дросселя и C501 дорожками 2 мм F.Cu, L501–Q501 — 2 мм F.Cu, L501–D501 и перемычку двух анодных площадок D501 — 1,2 мм F.Cu. Внутренний крючок LED_SW удалён. LED_OUT и LED_POS больше не используют In2.Cu: основная подача к J501 — 1,2 мм, остальные силовые ответвления — 0,8 мм по внешней меди; измерительные ответвления и развязка — 0,25 мм. Внутренний слой может использоваться только для малоточных ветвей питания контроллера, а не для подачи к дросселю. Массив у F101 содержит 10 переходных 0,8/0,4 мм; для него локально переложены соседние GPIO и ветвь +24V_FUSED. Проверка `check_power_paths.py` требует, чтобы каждое отверстие массива попадало в непрерывную F.Cu-медь до F101.1 и B.Cu-медь до J101.1, а не просто имело правильное имя цепи. Обратка PSU_RTN усилена внешним коридором шириной 5 мм на свободном участке; внутренняя полоса остаётся параллельной. Kelvin-keepout INA238 сохраняется.

RTC U301, Y301, C301/C302/C303 остаются на B.Cu у батарейки; кварцевые цепи без vias, VBAT/I²C/+3V3 подключены. Общие подтяжки R308/R309 остались у ответвления I²C. Держатель BT301 подключён к GND через коридор нижней стороны и via вне держателя.

**Разъёмы и слот (25.10.2026).** Справа сверху вниз: SHT4x J401, FAN1 J411, FAN2 J421 и три параллельных LED-клеммника J501/J502/J503. Снизу: FLOAT J403, PTC J701 и PUMP J702. Вход 24 В J101 перенесён налево. UART J201 оставлен на координатах (4; 9,75) мм с прежней ориентацией, microSD J301 — у левого края под UART, карта выходит влево. Между их куртярами около 3 мм. В `placement.json` записаны направления подключения и коридоры доступа длиной 20 мм, шириной по корпусу +0,5 мм с каждого края; они проверяются против компонентов и крепежа. Это проектный резерв, не проверка конкретного штекера, радиуса изгиба кабеля или стенки корпуса.

**J411/J421 — угловые 90°, шаг 2,54 мм.** Новая локальная посадка `LITE_Parts:KF2510_1x04_P2.54mm_RightAngle` воспроизводится `tools/generate_connectors.py`. Геометрический ориентир — [чертёж производителя LHE, A2543-WR04 / 2510-4AW, стр. 14](https://www.lhecn.com/wp-content/uploads/2019/01/a25432510.pdf): шаг 2,54 мм, ширина 10,16 мм, габариты 11,5×5,7 мм. Отверстия 1,0 мм вместо указанных в чертеже 0,9 мм, площадки 1,8 мм и запас куртяра 0,5 мм — проектные решения. 3D — условная габаритная модель. Распиновка не менялась: 1 GND, 2 +12V, 3 NC, 4 PWM. Производитель, угловое исполнение и ключ складского «KF2510 / KF2540 4P» не подтверждены физически: перед монтажом сверить с фактической деталью. Учёт склада и сумма BOM не изменены.

**D901.** Для OSTAPA57E2A сделана отдельная THT-посадка с отверстием 1,0 мм и площадкой 1,8 мм; по даташиту выводы имеют ширину 0,5 ±0,1 мм и шаг 1,25 мм. Перед установкой выводы нужно развести до шага 2,54 мм. Это проектная формовка, её нужно примерить на фактическом светодиоде до пайки. Даташит изготовителя указывает плоский торец, карточка Electrobase называет корпус выпуклым. KiCad DRC больше не находит ошибок кольца.

**Воспроизводимость.** `build_board.py` берёт из EU-0.1 только контур и монтажные отверстия; электрические посадки читает из локальных библиотек, все поля и цепи — из свежего netlist, координаты — из `placement.json`. Медь и старые подписи EU-0.1 не переносятся. Сохранение платы изолировано от настоящего `.kicad_pro`: KiCad 10.0.5 больше не затирает его чужими/пустыми настройками. Генератор схем сохраняет регистрацию всех локальных библиотек. Исправлены пути общих 3D-моделей; для U101/U201 стандартная STEP-модель с точным именем отсутствует в установленной KiCad 10.0.5, её визуализация ещё не закрыта.

`tools/silkscreen.py` выполняется после всех шагов разводки. Он управляет отдельной группой сборочной шелкографии, сначала размещает позиции обычных компонентов, затем полезные обозначения контактов разъёмов; крупные подписи разъёмов не занимают место. Размер позиций — 1,0 мм, в плотных местах — не менее 0,8 мм согласно правилу платы; штрих у всех добавленных надписей — 0,15 мм. 125 из 163 позиций разместились без наложения на площадки, переходы, корпуса и штатную шелкографию; не поместившиеся на стороне своей детали перечислены в `review/power-copper-2026-10-26/silkscreen.json`. Метки F-деталей на B.Silk не переносятся: на боте остаются только позиции реально нижних деталей. Генератор предпочитает вертикальную позицию на стороне компонента; получились 29 вертикальных ссылок, включая разъёмы, где это возможно вне их контура. По решению владельца удалены все новые `K` и восемь нативных штрихов `+` у C101/C102/C110/C508; оставлены только нужные `+` BT301 и D901. У 17 деталей с нечётным числом реальных выводов генератор не добавляет полярность/pin-1; прочие нативные метки посадок не удаляются. Дополнительный проход подбирает положения по границам соседних препятствий и надписей: восстановлены 11 позиций сверху без перемещения прежних меток; на нижней стороне по-прежнему 36 позиций своих деталей. Для однозначности подпись не должна быть ближе к чужой детали, чем к своей.

Следующие команды — пересборка исходников и платы, а не проверка сохранённого файла. Выполнять только в отдельной рабочей копии: генераторы перезаписывают результаты. Для обычного выпуска использовать `fabricate.py` выше. Для Python требуется интерпретатор KiCad с Shapely 2:

```text
python hardware/PCB_EU_LITE/tools/generate_connectors.py
python hardware/PCB_EU_LITE/tools/generate.py
python hardware/PCB_EU_LITE/tools/generate_led.py
kicad-cli sch export netlist --format kicadxml -o NETLIST.xml hardware/PCB_EU_LITE/PCB_EU_LITE.kicad_sch
python hardware/PCB_EU_LITE/tools/build_board.py NETLIST.xml
python hardware/PCB_EU_LITE/tools/check_placement.py NETLIST.xml
python hardware/PCB_EU_LITE/tools/test_placement.py NETLIST.xml
python hardware/PCB_EU_LITE/tools/finalize_board.py
python hardware/PCB_EU_LITE/tools/repair_power.py
python hardware/PCB_EU_LITE/tools/check_power_paths.py
python hardware/PCB_EU_LITE/tools/silkscreen.py
python hardware/PCB_EU_LITE/tools/led_boost_simulation.py --check
python -m unittest discover -s hardware/PCB_EU_LITE/tools -p test_led_boost_simulation.py
python hardware/PCB_EU_LITE/tools/silkscreen.py --check
kicad-cli sch erc --format json -o ERC.json hardware/PCB_EU_LITE/PCB_EU_LITE.kicad_sch
kicad-cli pcb drc --schematic-parity --format json -o DRC.json hardware/PCB_EU_LITE/PCB_EU_LITE.kicad_pcb
```

**Оставшиеся ограничения:** последний [полный прогон меди](review/power-copper-2026-10-26/) выполнен до исправления подписи F103; текущий статус паритета указан выше. 32 переходных с кольцом 0,10 мм оставлены в стеснённых местах; 23 увеличены до 0,6/0,3 мм без нарушения зазоров. Новые переходные трассировщик создаёт минимум 0,6/0,3 мм. Точка Q902 (25,984;80,95) в текущем исходнике уже находится вне пасты; её положение сохранено. У Q501 площадка LED_SW не соединяется с землёй; отдельная тепловая доработка Q501/D501 и измерения температуры остаются открытыми. Расчётный предел 9 А не считается подтверждённым по DRC: нужно проверить нагрев входа, предохранителя, шунтов и обратки, Kelvin-съёмы и работу LED-регулятора на эквиваленте нагрузки. Ранние отчёты `review/` и Gerber r2 не являются проверкой текущей меди.

Обновление данных каталога (нужна база `catalog.db` с тем же форматом): `python hardware/PCB_EU_LITE/tools/snapshot_prices.py CATALOG.db`, затем `generate.py` и `verify.py`. Генератор перезаписывает схемы: после ручной правки в KiCad сначала перенести её в `tools/generate.py`.
