nikolajevs/PCB_EU/hardware/enclosure/README.md

# Корпус для PCB_EU

Печатный корпус из двух деталей — **основание** и **крышка** — для платы 100×100 мм. Конструкция та же, что у корпуса PCB_V1: паз–шип, защёлки без винтов, уши для настенного крепежа, вентиляция, параметрическая модель CadQuery по STEP платы. Материал — **PETG**. **Не печатался и не проверялся на плате:** допуски защёлок, посадку на реальную плату и разъёмы нужно проверить на первом отпечатке.

## Что отличается от корпуса PCB_V1

- У PCB_EU четыре отверстия M3 (H1…H4). Плата прикручивается к четырём бобышкам основания (Ø6,4, пилот Ø2,8 под самонарезной M3×8); прижимных рёбер в крышке нет. Под краем лежат ещё 12 опорных блоков 8×2 мм там, где снизу ничего нет.
- Высота. Внутри от пола до потолка 42,2 мм, снаружи 46,8 мм. Размер определяют радиатор HS1 (30 мм над платой на прокладке 0,3 мм, верх на z = 31,9) с зазором 1,1 мм до потолка и выводы Q501/Q601 вместе с тыльными дросселями (до z = −8,2) с зазором 1,0 мм до пола. Радиатор — сборочный размер из `placement.json`, в STEP платы его нет.
- Окна: слева — клеммы J101, два XH J411/J421 (горизонтальные) и карта microSD J301; снизу — XH J401 и четыре клеммы J403, J701, J601, J602; справа — клеммы J501 и J702. UART J201 (штыревая 1×6, вертикальная) — окно в потолке; Dupont надевается сверху, глубина колодца около 26 мм — нужен пинцет или длинные провода. Кнопки RESET (SW201) и BOOT (SW202) — трубки в потолке, нажимать скрепкой или зубочисткой.
- Вентиляция: щели в потолке над радиатором и силовой частью, щели в стенках крышки и основания.

Размеры окон взяты с габаритов STEP платы плюс 0,5 мм на сторону. Ответные вилки и провода шире — проверьте на образцах.

## Файлы

| Файл | Что это |
|---|---|
| `PCB_EU_base.step`, `PCB_EU_lid.step` | Детали в системе координат STEP платы (X = x KiCad, Y = −y KiCad, низ платы Z = 0) |
| `PCB_EU_base_print.stl`, `PCB_EU_lid_print.stl` | Для печати в печатной ориентации: основание полом на стол, крышка потолком на стол. Поддержки не нужны |
| `PCB_EU_*_coupon_print.stl` | Фрагмент стенки 14 мм с защёлкой. Печатать **первым** и проверить посадку |
| `enclosure.py` | Генератор. Все размеры и места вырезов — константы в начале файла |
| `check_enclosure.py` | Проверка по `hardware/PCB_EU/review/PCB_EU_assembly.step` и блоку радиатора HS1 |

## Печать

- PETG, сопло 0,4, слой 0,2, 3 периметра, 4 верхних/нижних слоя, заполнение 20–25 %, без поддержек. Объём основания 39,8 см³, крышки 52,2 см³.
- Мосты: щели в стенках 10 мм и окна защёлок 6 мм. Нужен обдув; при провисании уменьшить `BASE_SLOT_L` и `LID_SLOT_L`.
- Ушки Ø4,5 под головку Ø8,6, межосевое 120×92 мм; винты и дюбели не входят в комплект.

## Проверка

`python check_enclosure.py` (нужен CadQuery 2.8.0): основание и крышка не пересекаются; ни одна из 391 деталей STEP платы и ни блок радиатора HS1 не пересекают корпус. Минимальный зазор 0,50 мм (SMD у бобышки H4), 1,04–1,10 мм у радиатора, ключей и тыльных дросселей. Это геометрия по 3D-моделям, а не проверка на реальной плате. Нагрев и допуск радиатора по высоте (±1 мм) требуют стендовых испытаний.

## Что проверить на первом отпечатке

1. Фрагменты-купоны: посадка шипа и гибкость пальца защёлки (`JOINT_GAP`, `RIDGE_P`, `SNAP_WIN`).
2. Фактическую высоту HS1 вместе с прокладкой и зазор до потолка (`Z_CEIL`), выводы Q501/Q601 над полом.
3. Совпадение окон с ответными клеммами, XH, microSD и проводами.
4. Резьбу M3 в бобышках: при необходимости заменить на латунные вставки (пилот Ø4,0).
5. Температуру стенок и потолка под нагрузкой: PETG держит около 70 °C, PLA не подходит.

## Пересборка

```sh
python -m pip install cadquery==2.8.0
python hardware/enclosure/enclosure.py
python hardware/enclosure/check_enclosure.py
```
