nikolajevs/PCB_EU/hardware/PCB_EU/DESIGN.md

# EU-0.1 — схема, размещение и состояние разработки

Состояние на 24.10.2026. `PCB_EU.kicad_pcb` **разведён полностью** (см. «Разводка 21.10.2026»): 100×100 мм, четыре слоя меди, 196 позиций схемы на двух сторонах. Геометрический DRC и сверка PCB со схемой выполнены целевым KiCad 10.0.7: 0 нарушений, 0 расхождений, 0 неразведённых соединений; Gerber и сверловка версии `b3f286d` выпущены 24.10.2026, Игорь подтвердил заказ PCB (архив и отчёт — в README, «Заказ платы 24.10.2026»). Прошивка PCB_EU подготовлена в [softwareEU/](../../softwareEU/README.md): ESP32-WROOM-32E-N4 (4 МБ), новые GPIO, MCP7940N и INA226; команды сборки, тесты и оставшиеся стендовые проверки описаны в её README. На реальной PCB_EU прошивка пока не проверена. Полные номиналы, выводы и Ref заданы схемой и `design.json`; состав закупки — `BOM_allocated.csv`.

## Требования

Одна плата, внешний БП 24,0 В, не выше 25 В, не менее 240 Вт / 10 А; расчётный вход 21,6–25 В. Расчётный ток от БП ~8,5 А при 24 В и ~9,3 А при 21,6 В (PTC 4,2 + LED1 ~2,4 + LED2 ~1,0 + 12 В ~0,6 + помпа 0,25 А). PTC 24 В/100 Вт включается/выключается; помпа 24 В/~6 Вт; два 12-вольтовых четырёхпроводных вентилятора вместе не больше 10 Вт. LED-панель и две линейки сохраняются: исходные ориентиры 1,111 А и 0,465 А суммарно, Vf 40–48 В. Реальные максимально допустимые токи и I–V нагрузок ещё не подтверждены.

Ручная сборка, пассивные SMD не меньше 0603, PCB не больше 100×100 мм. Старые корпус, разъёмы и число слоёв не являются обязательными. 81,25 € — датированная оценка покупки деталей, НДС и доставки, без PCB и внешнего оборудования. Ориентир около 80 €, потолок 100 €.

## Питание и силовые узлы

| Узел | Соединения и ключевые номиналы |
|---|---|
| Вход | J101(1) +24 В → F101 15 А → +24V_FUSED; J101(2) PSU_RTN → Q102 FDB5800 (D=PSU_RTN, S=RTN_SHUNT) → шунт R111‖R112 5 мОм → GND; D101 SMBJ26A после F101 |
| Измерение мощности | U102 INA226, I²C **0x40**: ток через шунт 5 мОм, напряжение +24V_FUSED через R113 1k (+ стабилитрон D103 33 В). См. «Измерение мощности (INA226)» |
| Переполюсовка | Q102 в минусе входа; затвор от +24V_FUSED через 5,6k+5,6k, 10k gate–GND: Vgs 10,2 В при 21,6 В, 19,8 В при 42 В (клэмп TVS). При обратной полярности Q102 закрыт, тело-диод заперт |
| Ветви | PTC 8 А, LED1 6,3 А, LED2 2 А, AUX 2 А, помпа 1 А; общая ветвь вентиляторов 2 А на 12 В |
| 12 В | L7987, 33 мкГн, 1000 мкФ/25 В с последовательными 0,1 Ом; 13,9k/1k → 11,92 В номинально |
| Управление L7987 | RFSW 68k; RILIM 27k; CSS 1 мкФ; Type II: 3,9k + 1 мкФ последовательно COMP–FB, 330 пФ параллельно всей этой цепи |
| 3,3 В | AP63203 только от 12 В, 6,8 мкГн, вход 2×10 мкФ/25 В, выход 2×22 мкФ/6,3 В |
| LED1 | LM3429, 2×10 мкГн последовательно, TK22E10N1, SS8PH10, IS 0,040 Ом, LED sense 0,15 Ом; RCSH 7,4k → ~1,117 А |
| LED2 | LM3429, 22 мкГн, CSD19534KCS, SS8PH10, IS 0,068 Ом, LED sense 0,47 Ом; RCSH 5,682k → ~0,464 А суммарно |
| Оба LED | VIN контроллера = реальный вход 24 В; RCT 56k+6,2k **от SW**, CT 1 нФ; COMP 22 мкФ; OVP 43k/1k → 54,56 В номинально |
| Gate drive | Без внешнего драйвера: GATE каждого LM3429 (VCC 7 В, 1 А) → 4,7 Ом → свой ключ (Q501 TK22E10N1, Q601 CSD19534KCS), 100k gate–GND. Заряд затвора от VCC при 400 кГц ~8 мА у Q501 и ~5 мА у Q601 (предел VCC 20 мА), потери LDO VCC до ~0,2 Вт на контроллер (у LED2 меньше). Выбор ключа — «Ключи LED» |
| Выход LED | SS8PH10 → выходные 100 мкФ/63 В (3/2 шт.) → верхний токовый шунт → LED+; **LED− = GND** |
| PTC | GPIO32 → 10k → NPN BC847B (4,7k база–GND) → PNP BC857B → 220 Ом → FDB5800; 2,2k gate–GND; только ON/OFF |
| Помпа | AO3422 с 1k gate и 100k gate–GND; SS510: катод к +24V_PUMP, анод к PUMP_DRAIN |

В отличие от старой платы, отрицательные выводы обеих LED-нагрузок соединены с GND. Выходной банк расположен до высокобокового шунта LED; HSP/HSN идут к его сторонам через одинаковые 1k. IS-шунт стоит между истоком силового MOSFET и GND. Kelvin-линии и импульсные возвратные токи должны быть разделены при разводке.

Boost имеет прямой путь VIN → дроссель → диод → нагрузка даже при nDIM=0. Отключение яркости не размыкает этот путь. Избирательность и I²t предохранителей с реальным БП не проверены. Все предохранители 3413/3403 — инерционные (T). При горячем подключении заряд входных 6×220 мкФ и выходных банков через L–D может дать выброс до ~2×Vвх на LED-выходе; пусковой ток и выброс измерить на прототипе. Программатор и USB-масса не должны становиться обратным проводом питания в обход Q102.

## GPIO и обязательные изменения прошивки

| Функция | GPIO EU-0.1 | Вывод модуля ESP32 |
|---|---:|---:|
| I²C SDA / SCL | 21 / 22 | 33 / 36 |
| SD SCK / MOSI / MISO / CS | 18 / 23 / 19 / 13 | 30 / 37 / 31 / 16 |
| Общая яркость LED | 25 | 10 |
| PWM fan1 / fan2 | 26 / 27 | 11 / 12 |
| Tach fan1 / fan2 | 34 / 35 | 6 / 7 |
| PTC / помпа | 32 / 33 | 8 / 9 |
| Поплавок | 14 | 13 |
| UART TX / RX | 1 / 3 | 35 / 34 |
| BOOT / RESET | 0 / EN | 25 / 3 |

**Прежний бинарник несовместим.** В нём LED=GPIO4, fan1=13, fan2=33, помпа=25, PTC=27, поплавок=32 и SD CS=5. Новая таблица должна применяться целиком, с ранней установкой GPIO25/32/33 в LOW и без сохранения RTC GPIO hold на силовых выходах. Старая прошивка включает на GPIO32 INPUT_PULLUP; при R702 4,7k база Q701 остаётся ниже 0,4 В даже при подтяжке 30 кОм и 3,6 В, поэтому PTC не включится, но остальные функции перепутаны (GPIO33 = помпа, GPIO25 = LED). Для LED PWM на nDIM выбрать 0,5–1 кГц: минимальный импульс LM3429 2·I·Vo·L/Vin² ≈ 3,7 мкс. Функции интерфейса, расписаний, климата, CSV, настроек и Ubidots требуется сохранить при переносе.

GPIO34/35 — только входы; нужны внешние подтяжки тахо, которые уже есть. GPIO2/5/12/15 внешне не нагружены. Выводы модуля 17–22 и 32 — NC; не подключать их как пользовательские линии flash. GND модуля: 1, 15, 38 и нижняя площадка 39.

Адреса на шине I²C платы: RTC MCP7940N **0x6F**, датчик мощности INA226 **0x40**; внешний SHT4x — 0x44/0x45. RTC заменён на MCP7940N (I²C **0x6F**): старое автоматическое определение PCF8563/DS3231 его не поддерживает. Нужны поддержка регистров нового RTC, установка ST и VBATEN, проверка достоверности времени до разрешения расписаний. MFP не используется. CR2032 подключена только к VBAT; зарядки нет. Проверить сборку/разделы flash под ESP32-WROOM-32E-N4 4 МБ.

Fan PWM инвертируется AO3422: HIGH GPIO замыкает PWM на GND. Подать 25 кГц с инверсией duty. При Hi-Z/сбросе PWM открыт, вентиляторы работают на полной скорости при наличии 12 В. Таховыходы должны быть открытыми коллекторами/стоками, без внешнего push-pull 5 В.

## nDIM, UVLO и состояния при сбросе

Общий nDIM двух LM3429 подключён к GPIO25 через 5,6k/1% и **одним** 10k/5% к GND. BAT54: анод nDIM, катод BLOCK_OC. BLOCK_OC объединяет открытые коллекторы LM2903 и PGOOD L7987 и имеет 10k к 3,3 В. У UVLO верх 56k+5,6k, низ 5,6k, положительная обратная связь 1M; опора 10k/10k от 3,3 В. Номинально отпускание ~19,90 В, срабатывание ~19,70 В. Неиспользуемые входы второго компаратора имеют определённые уровни, выход NC.

| Режим | Проектное поведение |
|---|---|
| ESP32 Hi-Z, питание исправно | LED выключены через 10k nDIM; помпа и PTC выключены; fan PWM открыт |
| GPIO25=HIGH, питание исправно | Разрешение обоих LED, если программные проверки пройдены |
| Падение входа / PGOOD=LOW | Аппаратная блокировка LED через BAT54 |
| GPIO32=LOW/Hi-Z/внутренняя подтяжка | NPN и PNP закрыты (база ≤0,4 В через 4,7k), PTC gate разряжается через 2,2k |
| GPIO33=LOW/Hi-Z | Gate помпы притянут к GND через 100k |
| Поплавок замкнут | GPIO14=LOW; трактовку «вода есть» задать по реальному монтажу |

Статический расчёт Hi-Z nDIM: 60 мкА × 10,5k = 0,63 В; с обратной утечкой BAT54 2 мкА при 25 °C — ~0,65 В. Минимальный HIGH до включения гистерезиса ~1,60 В. Это расчёт, а не измерение reset/температурных переходов. Холодный Vf и горячая утечка BAT54 и быстрый провал 12 В должны быть проверены на прототипе. Внешнего драйвера затворов больше нет, поэтому LED-каналы не зависят от 12 В, кроме PGOOD-блокировки. Конденсатора на nDIM нет.

## Разъёмы и точные распиновки

| Разъём | Назначение выводов |
|---|---|
| J101 | 1 +24 В вход, 2 GND |
| J701 / J702 | 1 плюс PTC / помпы после своего предохранителя; 2 коммутируемый отрицательный вывод нагрузки |
| J501 / J601 / J602 | 1 LED+, 2 GND; J601 и J602 параллельны на одном канале |
| J401 | Угловой хидер XH2.54-4P-90 для внешнего SHT4x: 1 +3V3, 2 GND, 3 SDA, 4 SCL. Порядок проводов датчика сверить с таблицей |
| J403 | 1 FLOAT, 2 GND |
| J411 / J421 | Хидер 2510-4P (KF2510-4A, шаг 2,54 мм): 1 GND, 2 +12V_FANS, 3 TACH, 4 PWM — стандартный порядок 4-проводного вентилятора ПК |
| J201 | 1 GND, 2 3V3_REF, 3 TX, 4 RX, 5 EN, 6 BOOT; уровни только 3,3 В |

У программатора питание оставить отключённым, когда плата питается от 24 В; J201(2) — опорный уровень, входом питания не является. Вентиляторы подключаются своим штатным разъёмом без переоконцовки; перед первым включением сверить порядок проводов купленного вентилятора с таблицей.

**J201: ZL201-10G с 23.10.2026.** По решению Игоря двусторонняя планка ZL2019-20 (20 контактов, 10,4 мм, Salvats, 0,63 €) заменена на обычную однорядную штыревую планку ZL201-10G (2,54 мм, 10 контактов, Salvats, 0,16 €, на складе 41 шт.): −0,47 €. Отрезается 6 контактов под UART, остаются 4. Посадка `PinHeader_1x06_P2.54mm_Vertical` и её 3D-модель не менялись. Длину выводов и покрытие (суффикс G) по карточке не сверяли: страница Salvats в тот момент отвечала 429, цена и остаток взяты из выгрузки цен от 23.10.2026; сверить при получении.

**AO3422: 1=G, 2=S, 3=D; TK22E10N1, CSD19534KCS и FDB5800: 1=G, 2=D, 3=S.** Для AO3422 выделен отдельный NMOS_GSD, а не символ GDS. USBLC6-2SC6: 1=6 IO1, 3=4 IO2, 2 GND, 5 +3V3. ESDA6V1L: 1/2 катоды защищаемых линий, 3 общий анод GND. BAT54: 1 анод, 2 NC, 3 катод.

GCT MEM2061: P1 DAT2, P2 DAT3/CS, P3 CMD/MOSI, P4 VDD, P5 CLK, P6 VSS, P7 DAT0/MISO, P8 DAT1. Все пять CMD/DAT имеют 10k к 3,3 В, SCK/MOSI — 220 Ом последовательно. Shell на GND. Отдельный контакт normally-closed card detect оставлен неподключённым. Две нижние металлические площадки имеют общий номер SH и GND; верхние площадки CD1/CD2 отдельно оставлены NC. В посадке сохранён запрет верхней меди под контактной зоной 10,37×2,08 мм и графическая зона доступа к карте.

## Посадочные места и проверка библиотек

Все **33 ранее пустых назначения** заполнены через `footprint_assignments.json` и `tools/generate.py`. Для 17 MPN используются 12 посадок в `EU_Mechanical.pretty`: две неизменённые из KiCad и десять построенных по чертежам. Библиотека зарегистрирована в проекте, схема и `design.json` воспроизведены. Во всех 196 позициях PCB (188 покупных элементов + 8 тестовых площадок) есть Footprint; всего 35 уникальных посадок. Из 33 новых назначений по чертежу сверены 27: после правки 22.10.2026 J402, J412 и J422 удалены из схемы, а J401, J411 и J421 переведены на стандартные посадки KiCad (JST XH, Molex KK-254) без собственного чертежа. Физическая примерка и сборка ещё не выполнены. Остальные 169 назначений пока сохраняют статус пакетных и требуют своей сверки с документацией.

| Ref | Геометрия, мм; вид со стороны компонента |
|---|---|
| F101 F102 F103 | SCHURTER UST до 25 А / USI 1206: площадки 1,1×2, внутренний зазор 1,5; не вариант UST свыше 25 А |
| F104 F105 F106 F401 | UMT250: площадки 2×3,75, шаг центров 8,5, внутренний зазор 6,5 |
| U101 | L7987: HTSSOP16, шаг 0,65, EP17 GND 3×3; четыре окна пасты ~65,1% площади EP |
| U501 U601 | LM3429, TI PWP0014A: шаг 0,65, ряды 5,8; EP15 GND — медь 3,4×5, окно маски 3,155×3,255. Паста соответствует примеру TI для трафарета 0,125; тепловые vias назначаются при разводке |
| L101 L501 L502 L601 | JNRH1207: две площадки 4,2×9, зазор 4; отдельно сверены чертежи всех трёх номиналов. Корпус до 12,5×12,5, высота до 8,05 |
| L201 | Bourns SRN6045: площадки 2×6, зазор 2,3; корпус до 6,2×6,2, высота 4,5. Это не SRN6045TA |
| SW201 SW202 | TACTB-64K-F: четыре площадки 1,8×1,1, центры x=±3,1, y=±1,85; верхняя пара — контакт 1, нижняя — контакт 2 |
| Y301 | ABS07: площадки 1,1×1,9, зазор 1,4, шаг центров 2,5 |
| BT301 | BC-2001: два положительных вывода 1 по 5,2×5,2 с центрами x=±12,95; отрицательный контакт 2 — 4×4 без пасты. Нужны стойкое покрытие контактной площадки, примерка держателя и доступ для замены батарейки |
| J301 | MEM2061 A1 без штырей: P8→P1 слева направо, шаг 1,1, площадки 0,8×2 со смещениями P2/P4/P6; два SH и два отдельных неиспользуемых CD. Габарит сокета и зоны доступа нанесены по чертежу |
| J101 | DG301R: шаг 5, отверстия 1,2, корпус относительно ряда −2,65…+7,35 по y. Чертёж DG301R-C02 T1: 15 А UL / 17,5 А IEC; артикул поставляемой детали должен соответствовать чертежу |
| J403 J501 J601 J602 J701 J702 | DG306: шаг 5, отверстия 1,4, корпус −4,5…+3,1 по y; отдельная посадка, учтено боковое соединение корпусов |
| J411 J421 | `Connector_Molex:Molex_KK-254_AE-6410-04A_1x04_P2.54mm_Vertical` из библиотеки KiCad без изменений: шаг 2,54, отверстия 1,19, площадки 1,74×2,19. KF2510 повторяет Molex KK-254; сверить с купленным хидером |
| J401 | `Connector_JST:JST_XH_S4B-XH-A_1x04_P2.50mm_Horizontal` из библиотеки KiCad без изменений: боковой вход, шаг **2,50**, отверстия 0,95, площадки 1,7×1,95, корпус от −2,3 до +9,2 мм по y от ряда выводов, ответная часть входит со стороны +y. «XH2.54» в каталогах — это обычно клон JST XH с настоящим шагом 2,50 мм (LCSC для XUNPU WAFER-XH2.54-4PJK указывает 2,5 мм). Если купленная деталь окажется с шагом 2,54, крайние выводы разойдутся на 0,12 мм: шаг и чертёж сверить до заказа |

У BC-2001 дополнительно запрещена посторонняя верхняя медь под батарейкой, кроме области отрицательного контакта; это проектное ограничение, а не размер из даташита. У MEM2061 запрет касается F.Cu, как в чертеже. При компоновке отдельно нужны доступ к карте, винтам клемм и батарейке, радиаторы, высоты и зона антенны ESP32. Fab-контуры упрощённые; они не заменяют проверку сборки и поставленного корпуса. 21.10 добавлены локальные модели всех 191 устанавливаемой детали; ограничения приведены ниже.

### 3D-представление и обнаруженное расхождение

Все 188 Ref имеют по одной доступной STEP-модели без внешних путей: 35 используемых файлов, 34 типа посадок; C112 использует собственный вариант 10×20 вместо 10×16 мм. Контрольные площадки и NPTH исключены. Дополнительно к board-only HS1 подключён STEP радиатора поставщика. Из 36 файлов 15 созданы скриптом `tools/make_models3d.py`, 19 взяты без изменения CAD-геометрии из KiCad, один — адаптация из предыдущей платы и один — CAD радиатора из архива пользователя; происхождение, ссылки и хеши — `models3d.json`, `libraries/EU.3dshapes` и `libraries/SOURCES.md`. Модели корпусов не заменяют физическую квалификацию.

22.10.2026 проверено переиспользование моделей прежних плат. Для J401 взята локальная модель XH2.54-4P-90 без задних боковых подпорок из `cheap-version` J301: выводы и основной корпус сохранены, внешний вид соответствует использованной там фотографии пользователя. Это визуальная адаптация, не размерная квалификация поставленного разъёма. В PCB и библиотечной посадке изменён только путь STEP; медь, площадки, размещение и шелкография сохранены. Остальные общие корпуса уже имеют модели; собственные модели старых MPN не подменяют отличающиеся детали PCB_EU. Картинки и сборочный STEP в этой правке не обновляются по указанию пользователя.

Собственные модели включают все десять прежде отсутствовавших корпусов: JNRH1207, SRN6045, предохранитель 1206, клеммы DG301R/DG306, MEM2061, ABS07, TACTB, LM3429 и BC-2001 с установленной CR2032. Дополнительно созданы UMT250, L7987 и три электролита разных размеров. Металлические выводы/площадки, ориентация pin 1 и высоты проверены относительно посадок; недокументированные окна, фаски и контактные секции упрощены. Модели электролитов номинальные: сборочный зазор 0,15 мм условный, допуски диаметра/длины и высота монтажа не квалифицированы.

**C508/C509/C510/C608/C609 (`EEUFR1J101LB`), исправлено 21.10.2026.** [Таблица exact-MPN Panasonic](https://industrial.panasonic.com/ww/products/pt/aluminum-cap-lead/models/EEUFR1J101LB) задаёт корпус 8×15 и шаг выводов 5 мм (ленточный вариант B, [FR-A, 01-Sep-25](https://industrial.panasonic.com/cdbs/www-data/pdf/RDF0000/ABA0000C1259.pdf)). Прежняя посадка имела шаг 3,5 мм. Теперь пять позиций используют стандартную `Capacitor_THT:CP_Radial_D8.0mm_P5.00mm` из KiCad (копия в `libraries/Capacitor_THT.pretty`), C508, C608 и C609 переставлены под новый шаг, медь LED1/LED2 проложена заново. Проверка 3D-модели проходит без исключений (`known_fit_issues` пуст).

22.10.2026 к существующей посадке HS1 добавлен неизменённый `RAD-DY-GF_3.stp` из архива пользователя `LIB_RAD-DY-GF_3.zip`. Поворот XYZ (0; 180; 0)°, смещение (0; −37,55; 30) мм относительно начала HS1 (83; 0) совмещают ножки с уже имеющимися отверстиями: расхождение осей по Y около 0,00005 мм из-за округления координат посадки. Корпус занимает x=68…98, y=24,05…39,05 и z=0…30 мм от верхней поверхности платы; ножки выступают на 10 мм снизу. Номинальный зазор до фланца Q501 — 0,3 мм; типовая TO-220 модель даёт 0,29 мм из-за отличия её плоскости фланца от принятого размера на 0,01 мм. Старый сплошной габарит удалён. В CAD поставщика резьба отсутствует. Сохранённые картинки и сборочный STEP по указанию пользователя не обновляются. Проверки ERC/DRC не доказывают механическую готовность, электрическую изоляцию, тепловой режим или отсутствие столкновений во всех сборочных допусках.

Проверка **KiCad 10.0.7**: все 35 используемых посадок загружены и экспортированы в SVG; номера площадок всех 196 компонентов совпадают с символами, включая NC. Скрипт проверяет ключевые размеры, полярность, медь/маску/пасту и отсутствие сближения разных площадок меньше 0,15 мм; минимальный полученный зазор — 0,20 мм. Визуально просмотрены 12 механических посадок, окно маски LM3429 и обновлённый лист периферии. Намеренно повреждённые копии EP LM3429, контактов microSD и полярности BC-2001 отклонены проверкой.

Дополнительный DRC выполнен на временном образце из 32 изолированных посадок: **0 геометрических нарушений**, 13 намеренно неразведённых соединений между одноимёнными площадками. Это **не DRC изделия**; образец не является платой 100×100 мм и не публикуется как PCB. Воспроизведение — `tools/check_footprint_drc.py` интерпретатором с `pcbnew` той же версии, что CLI; результат — `review/footprint_drc.json`.

Основной `tools/run_checks.py` повторяет ERC, 56 проверок соединений, проверку посадок, размещения, полной разводки и native DRC со сверкой схемы. Целевая версия **KiCad 10.0.7** проверена полным прогоном 23.10.2026 после замены ключей и C301/C302; результаты и границы проверки приведены в [README.md, «Проверки»](README.md#проверки). Контрольные суммы включают библиотеки, генераторы, PCB, `placement.json` и `routing.json`. Источники, версии чертежей и SHA-256 скачанных первичных документов — в `footprint_assignments.json` и `libraries/SOURCES.md`. UMT250 и HTSSOP16 побайтово совпадают с указанными Git blob KiCad. Физическая примерка и испытания прототипа остаются открытыми; состав и датированная оценка закупки — в [README.md, «Закупка»](README.md#закупка).

## Размещение и разводка PCB

`placement.json` задаёт координаты в миллиметрах в системе вида сверху: начало в верхнем левом углу платы, позиции соответствуют библиотечным началам. Для B-стороны генератор сначала переворачивает посадку и затем задаёт указанный угол. `tools/build_board.py` строит новую плату из экспортированного KiCad XML, связывает все площадки с netlist, сохраняет MPN и прочие поля схемы. Ручные изменения размещения следует переносить в JSON. Генератор отказывается перезаписывать PCB с дорожками, переходными отверстиями или медными зонами.

| Параметр | Текущий вариант |
|---|---|
| Контур / толщина / медь | 100×100 мм / 1,6 мм (по стеку 1,6062 мм) / 4 слоя; медь **1 oz снаружи (35 мкм) и 0,5 oz внутри (15,2 мкм по стеку JLCPCB)**, выбор Игоря 22.10.2026; завод и стек те же, что у PCB_V1 и cheap-version (Игорь 22.10.2026): JLCPCB, JLC04161H-7628. Расчёт токов под этот стек — «Медь и токи». В PCB записаны числа этого стека; допуски готовой меди и металлизацию подтверждает расчёт заказа JLCPCB |
| Позиции схемы | 196: **113 сверху, 83 снизу**, включая восемь тестовых площадок |
| Крупные детали снизу | BT301; L501/L502/L601 (8,05 мм, самые высокие снизу). Все электролиты с 22.10.2026 сверху (раздел «Электролиты на одной стороне»). Нужна отдельная проверка высоты стоек и свободного пространства под платой |
| Разъёмы | Все у краёв (22.10.2026). Слева сверху вниз: UART J201, вентиляторы J411/J421, вход 24 В J101, microSD. Снизу: SHT J401 (XH), FLOAT J403, PTC J701, LED2 J601/J602. Справа: LED1 J501 и помпа J702 на месте снятого резерва HS2 |
| ESP32 | Корпус внутри контура; RF-зона без деталей на обеих сторонах и без меди продолжается за верхний край. Это зона свободного пространства, не выступ корпуса |
| Радиатор | Один резерв **34×32 мм на F-стороне** для Q501 (LED1): x=65…99, y=8…40 (ширина с 22.10.2026 увеличена с 32 мм, чтобы радиатор 30 мм стоял по центру отверстия Q501). На F.Cu там запрещены дорожки, переходные и заливки; площадки разрешены только у двух отверстий HS1, остальные проверяет `verify_board.py`. Корпус TO-220 допускается у границы. Радиатор стоит торцом 30×15 мм на плате, ножками в два металлизированных отверстия GND (см. «Радиатор Q501»). Q601 (LED2) с 22.10.2026 без радиатора |
| Крепление платы | Четыре предлагаемых NPTH 3,2 мм H1–H4, board-only; резерв крепежа 6,4×6,4 мм. Это не отверстия ножек радиатора (они в посадке HS1). Совместимость с реальными стойками/шайбами не подтверждена |
| Разводка | 1451 участок дорожек, 345 переходных, GND на In1.Cu, заливки GND на F.Cu/B.Cu; **все соединения разведены** (см. «Разводка 21.10.2026») |

**Радиатор Q501.** Источник геометрии: STEP STONECOLD RAD-DY-GF/3 с TME, присланный Игорем 22.10.2026, и фото поставщика с резьбовым отверстием. Из STEP: плоская сторона прижима (подошва 3 мм, рёбра до 15 мм), две цилиндрические ножки Ø1,4 мм на расстоянии 2,2275 мм от плоскости прижима, шаг 22,2 мм (±11,1 мм от оси), выступ 10 мм из торца 30 мм. Резьбового отверстия под винт в STEP нет; по фото оно по центру подошвы (положение принято, не измерено), винт М3 у Игоря, в BOM не включается (решение 22.10.2026). Фланец TO-220 (drain Q501, узел переключения) отделён прокладкой SMICA-TO220-2 (силикон 0,3 мм со втулкой) и втулкой на винте; ножки радиатора идут на GND, поэтому изоляцию радиатора от стока проверить мультиметром после сборки.

Радиатор ставится торцом 30×15 мм на плату, оребрение вертикально (30 мм над платой). Отверстие фланца Q501 лежит на 16,0 мм над платой (модель TO-220), резьба радиатора по фото ~16–17 мм от торца с ножками: торец радиатора ложится на плату. Положение ножек в `placement.json` (`heatsink_legs`): центр 83,0 (ось вывода 2 Q501 и отверстия фланца), x=71,9 и 94,1; y=36,8225 = 42,5 (Q501) − 3,15 (плоскость фланца) − 0,3 (прокладка) − 2,2275. Отверстия металлизированные 1,7 мм (ножка + 0,3), площадки 2,6 мм, цепь GND; на F.Cu в резерве заливки нет, площадки соединяются через In1 и B.Cu. Посадка HS1 — board-only, с контуром 30×15 мм на Fab и Courtyard.

Что пришлось сдвинуть: левая ножка (71,9; 36,82) попадала на площадку 1 R803 и на автотрассу LED1_IS на In2.Cu. R803 сдвинут на 1,5 мм вправо (x=77,2), R804 — на 0,9 мм (x=82,1); LED1_IS, LED1_GATE_RAW и LED1_RT_MID перепроложены сеточной трассировкой (`replace_session_nets` дополнен LED1_GATE и LED1_GATE_RAW). Ножки выступают из платы на 8,4 мм вниз: под ними на B-стороне нет деталей, дроссель L502 начинается на 0,9 мм правее левой ножки.

Не подтверждено: фактическое положение резьбы и ножек на купленной детали (проверить штангенциркулем до заказа плат), зазор до J501 (1,15 мм) и высота 30 мм в корпусе, тепло радиатора 8,8 К/Вт по каталогу, изоляция. Фланец Q601 без радиатора открыт и тоже под напряжением узла переключения.

Внешнего драйвера нет: U501/U601 стоят снизу рядом со своими ключами. По прямой у LED1 GATE → R803 около 8 мм и R803 → затвор около 4 мм, у LED2 GATE → R807 около 3,5 мм и R807 → затвор около 18 мм (`review/placement.json`); это не длины трасс. R807 стоит у правого края, затвор Q601 идёт по In2.Cu над плоскостью GND (см. «Силовой контур LED2 и ключи LED»). Q102 (защита от переполюсовки) стоит снизу у левого края, J101.2 прямо над его фланцем; под его выводом истока — шунты R111/R112 и INA226, R108–R110 справа от затвора (см. «Измерение мощности (INA226)»). До общей трассировки нужно отдельно проработать импульсные петли boost/buck, возвраты затворов, Kelvin-линии и тепловые переходные. Геометрическая укладка не подтверждает возможность качественно развести эти цепи.

Проверка `tools/verify_board.py`: **22 991 проверок**, соответствие всех 525 назначений pin/net (498 подключённых выводов + NC), в том числе 514 физических подключённых площадок с учётом дублирующихся номеров. Проверены контур, стороны, пути схемы, площадки/цепи, сохранность маски THT, зазор courtyards одной стороны ≥0,15 мм, запас 0,5 мм вокруг выводных паек на противоположной стороне, RF-зона, резервы радиаторов и крепежа. Native DRC KiCad 10.0.7 со `--schematic-parity`: **0 геометрических нарушений, 0 расхождений со схемой, 0 неразведённых соединений**; исключений DRC в проекте нет.

Отрисовки `review/PCB_placement_front.png` и `review/PCB_placement_back.png` получены из реального PCB через KiCad, вид снизу зеркальный. Fab-маркировка служит сборочному обзору. Шелкография добавляется отдельным этапом поверх разведённой платы (раздел «Шелкография»). Номера контактов клемм перенесены внутрь их габарита, чтобы не выходить за край платы. Временные повреждённые копии с ошибочной цепью U101.4, потерянной маской THT и батарейкой в RF-зоне отвергнуты; защита генератора от перезаписи дорожек проверена отдельно.

## Силовые соединения LED1

L501/L502 подняты на 4 мм. D501 развёрнут и приближен к ключу; R501 перенесён к source Q501; C508 — на B-сторону рядом с R501 (с 22.10.2026 он сверху рядом с C510, см. «Электролиты на одной стороне»). R803/R804 находятся снизу, C511 перенесён к выходному конденсатору. Обвязка, вытесненная этими деталями, переразмещена с прежними зазорами; MPN, номиналы и закупка не изменены.

`routing.json` задаёт реальную медь: связь двух дросселей, L502–Q501–обе анодные площадки D501, Q501–R501, D501–C511 и D501–R502 (C508 с 22.10.2026 в плане не участвует, его подключает автотрассировщик), выход R502–J501 на In2.Cu, входные C501/C502–F103–L501 и выход R803 до gate Q501. In1.Cu содержит GND с сохранённым заполнением и соблюдением RF-keepout. GND R501 был соединён с C508 короткой верхней дорожкой; с 22.10.2026 C508 стоит у C510, и его GND идёт через заливки и In1. GND C511 связан с плоскостью через нижнюю заливку GND: отдельное переходное убрано, чтобы освободить место выводам U501. Остальной LED1 (входная шина до F103, питание/обвязка U501, Kelvin-отводы, R804–GND, GATE U501 → R803, C509/C510) разведён по «Разводка 21.10.2026».

Выбраны предварительные ширины 1,2–2,0 мм для силовых участков, 0,4–0,5 мм для gate и два параллельных переходных SW, входа и LED+. Они пока не квалифицированы по току, сопротивлению, индуктивности, толщине меди и температуре. В области переходных есть сужения; плоскость GND и её thermal-spokes также требуют проверки. Тепловые переходные EP контроллеров ещё не подготовлены. Размещение и DRC не подтверждают устойчивость, безопасный нагрев или работу устройства.

`tools/route_power.py` добавляет 203 объекта: 173 сегмента, 28 переходных, одну плоскость и одну зону без заливки (планы LED1 и LED2, ручные выводы LM3429 и измерение мощности INA226, см. «Разводка 21.10.2026» и «Силовой контур LED2 и ключи LED»). Повторный запуск сохраняет совпадающие объекты, отвергает изменённый объект с тем же UUID и не удаляет постороннюю ручную медь. `tools/build_board.py --output` позволяет получить новую неразведённую основу в отдельном файле. `tools/verify_routing.py` сверяет геометрию плана и через native KiCad connectivity проверяет 19 физических групп (по восемь на LED1 и LED2 и три для INA226/Q102: RTN_SHUNT, INA_VBUS, REVP_GATE), включая по две отдельные площадки D501.2 и D601.2. Совпадения имён цепей для этого недостаточно. Результат — `review/routing.json`.

Основание компоновки: [TI LM3429, §11.1–11.2, стр. 53–54](https://www.ti.com/lit/ds/symlink/lm3429.pdf) выделяет импульсную петлю выходного конденсатора, диода, MOSFET и токового шунта, а также чувствительные измерительные цепи. Для следующего узла [ST L7987, §5.6, стр. 30–32](https://www.st.com/resource/en/datasheet/l7987.pdf) задаёт требования к входной силовой петле и размещению обратной связи. Текущая частичная разводка — промежуточный вариант для проверки этих соединений.

## Исправления 21.10.2026

По итогам полной проверки EU-0.1. Схема, BOM и PCB пересобраны генераторами; ERC 0/0, DRC 0/0, 51 проверка соединений.

| Что | Было | Стало | Почему |
|---|---|---|---|
| R702 (база Q701 – GND) | 100k 0603 | 4,7k 1206 1% | Внутренняя подтяжка ESP32 (старая прошивка: `INPUT_PULLUP` на GPIO32) открывала Q701 и включала PTC 100 Вт. Теперь база ≤0,4 В; от GPIO HIGH ток базы ~0,13 мА |
| C208 (EN ESP32) | 100 нФ | 1 мкФ 0805 | Рекомендация Espressif 10k/1 мкФ; 3,3 В появляется после двух преобразователей. Из уже оплаченной пачки |
| Драйвер затворов | U801 TC4427A, C801, C802, R801/R802/R805/R806 | Нет; GATE LM3429 → 4,7 Ом → Q501 TK22E10N1 / Q601 CSD19534KCS | U801 был в 20–25 мм от обоих ключей. Встроенный драйвер LM3429 стоит в ~8 мм от своего ключа, LED больше не зависят от 12 В. −2,75 € |
| Переполюсовка | Не защищено | Q102 FDB5800 в минусе входа + R108/R109 5,6k, R110 10k | Ошибка полярности на винтовой клемме больше не подаёт обратное напряжение на электролиты и ИС. +2,07 € (FDB5800 1,98 € и резисторы 0,09 €) |
| Подпись F103 | «6.3 A fast» | «6.3 A slow» | Серия Schurter UST 1206 — инерционная (T) |
| Требования | — | БП ≥240 Вт / 10 А; внешний термовыключатель PTC обязателен | Расчётный ток ~9,3 А при 21,6 В |

BT301 позже сдвинут на 12 мм ниже (см. «Разводка 21.10.2026»). Не менялось: питание +3V3 на J401 к внешнему SHT4x без ограничения (SHT4x может включать нагреватель до ~75 мА).

## Разводка 21.10.2026

**Батарейка.** BT301 перенесён с y=24 на y=36 (x=28,5, снизу). Courtyard держателя теперь начинается примерно в 12,5 мм от RF-зоны ESP32 (раньше ~2 мм). Проверки размещения пройдены без изменений остальных деталей.

**Как получена медь.** Порядок полностью воспроизводим из файлов репозитория:

1. `tools/build_board.py --output TEMP` и `tools/route_power.py` — как раньше: размещение, планы LED1 и LED2 и ручные выводы LM3429 (`routing.json`, 293 объекта).
2. `tools/route_board.py --board TEMP` (рядом нужен `PCB_EU.kicad_pro`; `PCB_EU.kicad_dru` с 22.10.2026 пустой и для результата не обязателен):
   - переходные GND до трассировки: кольца у силовых выводов земли (площадки GND шунтов R111/R112 по 5 шт., Q703 6, R501/R601 по 4, C101/J501/J602 по 3, Q704 и D101 по 2), переходные внутри теплоотводящих площадок U501 (7), U601 (4), U101 (1) и в отрицательном контакте BT301 (4), короткая дорожка с переходным для каждой остальной SMD-площадки GND, где для неё есть место (70);
   - короткие цепи обвязки LM3429 и L7987 трассируются первыми встроенным сеточным трассировщиком (`tools/route_complete.py`, перенесён из PCB_V1); перед выводами микросхем с мелким шагом он оставляет 0,8 мм свободными для их собственных цепей, неудавшиеся цепи повторяет первыми;
   - импорт двух сессий Freerouting 2.4.1 из `routing/pass1.ses` и `routing/pass2.ses` (второй проход — с узкими ширинами для остатка);
   - медь сессии, которая нарушает зазор до уже заданной меди (например, после правки `routing.json`), удаляется вместе с оставшимися тупиковыми отрезками; так же удаляются переходные сессии ближе 0,25 мм по отверстию к уже заданным отверстиям (любой цепи) и вся медь сессии на цепях из `replace_session_nets` (цепи, которые план теперь прокладывает сам), а также медь сессии внутри зон `fill_keepouts`. Медь самого плана не удаляется, даже если после удаления сессии она стала тупиковой. Эти связи вместе с остальными доводит сеточный трассировщик. Тупиковые отрезки GND не удаляются: переходные GND сессии сшивают заливки, которых на этом шаге ещё нет. Поэтому правки плана не требуют нового прогона Freerouting;
   - добивка оставшихся связей сеточным трассировщиком;
   - заливки GND на F.Cu и B.Cu (зазор 0,2 мм; SMD сплошным подключением, THT — термобарьерами) и переходные в островах заливки без связи с In1.
   Повторный запуск на тех же входах даёт тот же файл. Чтобы пересчитать трассировку заново: `--jar freerouting.jar --java <java 25>`; результат автотрассировщика при этом изменится.
3. `PCB_EU.kicad_dru`: правил нет. Сплошные подключения C609 и C510 к заливкам GND, нужные прежней разводке, после переноса электролитов 22.10.2026 убраны: DRC без них чистый.
4. `tools/silkscreen.py` (после разводки, нужен Shapely 2): шелкография поверх готовой меди. Порядок 1–4 даёт файл платы без ручных правок. После слияния #79 (22.10.2026) плата в репозитории от этого порядка отличалась: в ней не было двух переходных GND (1,96; 75,09) и (2,66; 76,327) и отрезка B.Cu 0,3 мм между (1,39; 77,60) и (2,66; 76,33), а в надписи стояло прежнее «HS guide holes…». Плата записана заново из пересборки: 1446 участков, 344 переходных; две пересборки подряд побайтово совпали. Обе версии проходили DRC, связность и расчёт меди; ERC, DRC, шелкография, стек и расчёт меди пройдены и на новой плате.

**Классы цепей** (`PCB_EU.kicad_pro`): HEAVY24 2,0 мм (+24V_RAW, PSU_RTN, RTN_SHUNT, +24V_FUSED, +24V_PTC, PTC_DRAIN); LOAD 1,0 мм (LED-силовые, +24V_AUX, AUX_SW, +12V, помпа, вентиляторы); PWR 0,5 мм (+3V3, LOGIC_SW, VBAT); остальное 0,25 мм. Зазор везде 0,2 мм. Автотрассировщик не умеет сужать дорожку у мелких выводов, поэтому LOAD им проложен шириной 0,6 мм, а остаток — 0,4 мм; несколько коротких ответвлений HEAVY24 (D101, R809, R108/R113) — 0,8 мм; два Kelvin-отвода шунта (RTN_SHUNT и GND) — 0,25 мм, тока в них нет. Силовая медь 24 В после переразводки под 1 oz (22.10.2026, раздел «Медь и токи»): вход +24V_RAW 3,0 мм F.Cu, PSU_RTN 4,5 мм B.Cu, магистраль F101.2 → C101.1 двумя дорожками (F.Cu 2,0 мм + B.Cu 2,5 мм), ветка C101.1 → F104/F106 3,0 мм B.Cu, питание PTC 1,5 мм F.Cu, ножка PTC и питание LED1 2,0 мм по F.Cu/B.Cu (In2.Cu они больше не занимают), PTC_DRAIN 2,0 мм, исток Q102 → шунты R111/R112 (RTN_SHUNT, 3,0 мм по B.Cu, по плану). Фактические ширины по классам — в `review/routing.json`.

**Выводы LM3429 и плотные места.** U501/U601 стояли снизу между двумя резервами радиаторов, где переходные запрещены (резерв HS2 снят 22.10.2026); автотрассировщики запирали там друг друга, и после первого прогона оставалось 13 соединений. Теперь короткие выходы их выводов заданы вручную в `routing.json`: IS и HSP U501; IS, RCT, CSH, OVP и COMP U601 уходят короткими нижними дорожками к переходным за краем резерва и дальше по In2.Cu/F.Cu. Девять деталей над U601 (R605–R611, C606, C607) переставлены в пять столбцов при x=88,0…98,4 мм. На 0,4–6 мм сдвинуты R503, C504, C505, C506, C507, C511, C604, C611, R807 и R104. D101 перенесён из-под батарейки к F103 (x=55,25, y=24). Отдельно проложены BLOCK_OC к U101.12 и GND R706/Q701 через своё переходное (иначе R706.2 оставался на острове нижней заливки). Номиналы, MPN и закупка не менялись.

**Что не сделано.**
- Питание VIN контроллера U601 (+24V_LED2, единицы мА) проведено сеточным трассировщиком дорожкой 0,4 мм по B.Cu под R601; силовой ток по ней не идёт.
- Ток, нагрев, падение напряжения, индуктивность петель и ЭМС не проверены. Медь выбрана стандартная 1 oz снаружи; расчёт нагрева по IPC-2221 и остаточные горячие точки — в разделе «Медь и токи», измерение на собранной плате не сделано.

## Силовой контур LED2 и ключи LED

21.10.2026, после «Разводка 21.10.2026». Номиналы LED2 не менялись; изменены посадка пяти электролитов, размещение у Q601, медь LED2 и MPN обоих ключей. С 23.10.2026 ключ Q601 — CSD19534KCS (см. «Ключи LED»).

**Размещение.** C508–C510, C608, C609 переведены на посадку с шагом 5 мм (см. «3D-представление»): C508 был сдвинут к x=84,7 (до 22.10.2026), J501 к x=96,06; C608 (67,7; 88,3) и C609 (80,7; 95,0) снизу; с 22.10.2026 все четыре нижних электролита стоят сверху (раздел «Электролиты на одной стороне»). По образцу LED1: R601 (IS-шунт) перенесён вплотную под Q601 (82,0; 90,2), D601 развёрнут анодами к ключу, керамический C611 был поставлен сверху между выводами C609 (до 22.10.2026; теперь C611 стоит отдельно у D601). R807 (4,7 Ом) — у правого края (97,7; 88,8), R808 (100k) — снизу под затвором (80,0; 89,0), TP08 — на Kelvin-линии IS (94,5; 91,25), TP05 — на (54,5; 71,5), J602 — на x=69,85.

**Медь LED2 в `routing.json`** (на 21.10.2026: 71 маршрут вместе с LED1, восемь новых групп связности; таблица обновлена 22.10.2026):

| Цепь | Путь |
|---|---|
| LED2_SW | L601.2 → Q601.D снизу 1,8 мм; Q601.D → обе анодные площадки D601 сверху 1,1 мм вдоль корпуса ключа |
| LED2_IS | Q601.S → R601 1,2 мм; Kelvin 0,25 мм от площадки R601 через TP08 к переходному IS U601 |
| GND петли | R601 → C611 сверху 1,2 мм (до 22.10.2026 дальше к C609); два переходных к In1.Cu у R601 и кольцо из четырёх переходных |
| LED2_OUT | D601 → C611 1,5 мм; D601 → C608 → C609 1,5 мм (с 22.10.2026; раньше D601 → C608 и D601 → C609 → C611); C611 → R602 1,2 мм |
| LED2_LED_POS | R602 → два переходных → In2.Cu 1,0 мм к J602 и J601 |
| +24V_LED2 | F104 → C602 и F104 → C601 сверху 1,2 мм; C601 → L601 снизу 1,5 мм |
| GATE | U601.10 → переходное → R807; R807 → переходное → In2.Cu 0,5 мм → Q601.G; R808 снизу у затвора |

ВЧ-петля Q601 → D601 → C611 (100 нФ) → GND → R601 → Q601 занимает примерно 14×10 мм сверху над сплошной плоскостью GND (In1.Cu). Затвор Q601 идёт около 20 мм по In2.Cu над той же плоскостью; 4,7 Ом стоит у драйвера. `replace_session_nets` перечисляет семь цепей LED2, старую автотрассированную медь которых `route_board.py` удаляет при импорте сессий. Повторная сборка из файлов репозитория даёт тот же PCB.

**Ключи LED.** IRF540Z заменён на Toshiba [TK22E10N1](https://docs.rs-online.com/8d7e/0900766b81294f79.pdf) (100 В, 13,8 мОм, TO-220, выводы G-D-S как у IRF540Z; посадка и медь те же). При токах 1–2,3 А и 400 кГц почти все потери ключа — переключение: встроенный драйвер LM3429 слабый (7 В; 2 Ом / 1,3 Ом по даташиту) плюс 4,7 Ом в затворе. Оценка при 24 В и Vf 44 В (с 23.10.2026 Q601 — CSD19534KCS, третий столбец):

| | IRF540Z | TK22E10N1 | CSD19534KCS |
|---|---:|---:|---:|
| Заряд затвора Qg при 10 В, тип. | 42 нКл | 28 нКл | 17,1 нКл |
| Заряд переключения (Qgd + часть Qgs) | ~19 нКл | 12 нКл | ~6 нКл (оценка) |
| Потери ключа LED1 | ~1,9 Вт | ~1,4 Вт | ~0,8 Вт |
| Потери ключа LED2 | ~0,8 Вт | ~0,65 Вт | ~0,37 Вт |
| Ток VCC LM3429 на затвор, 400 кГц | ~12 мА | ~8 мА | ~5 мА |
| Цена | 1,70 € (Salvats) | 1,38 € (Salvats) | 3,09 € (Electrobase) |

Метод: переключение 0,5·Vвых·Iвх·(tвкл+tвыкл)·f, время из заряда переключения и тока драйвера; проводимость Iскз²·Rds при ~100 °C; потери выходной ёмкости (у TK22E10N1 она больше: 310 пФ при 50 В) учтены. Данные IRF540Z взяты из даташита Infineon IRF(R/U)540Z того же кристалла. Это расчёт, а не измерение. Предел тока VCC LM3429 — 20 мА (мин.): у IRF540Z при максимальном Qg запас почти исчезал. Рассмотрены и отклонены FQP13N10 (12 нКл, но 0,18 Ом: у LED1 при 21,6 В потери выше) и CSD19531KCS (большая выходная ёмкость; у CSD19534KCS кристалл меньше, см. ниже). Без радиатора ключ LED1 нагрелся бы на 100 °C и больше, поэтому радиатор Q501 сохранён. Q601 с 22.10.2026 без радиатора (см. «Клеммы по краям»). На прототипе измерить нагрев Q501/Q601 и звон на SW/затворе; уменьшение 4,7 Ом до 2,2 Ом снизило бы потери ещё примерно на четверть ценой более резких фронтов.

**Q601: CSD19534KCS с 23.10.2026.** Ключ слабого канала LED2 работает без радиатора, поэтому его потери важнее всего. TI [CSD19534KCS](https://www.ti.com/lit/ds/symlink/csd19534kcs.pdf): 100 В, TO-220, выводы G-D-S, фланец — сток; посадка, слюда и втулка те же. Qg 17,1 нКл вместо 28, Qgd 3,2 нКл вместо 8,1, Coss 257 пФ вместо 310 при 50 В, Rds(on) 13,7 мОм тип. (16,5 макс.) при 10 В и 16,3 мОм при 6 В, порог 2,4–3,4 В, Vgs ±20 В: от VCC 7 В канал открыт. Та же модель, подогнанная под цифры TK22E10N1 из таблицы, даёт для LED2 ~0,37 Вт вместо ~0,65 Вт и для LED1 ~0,8 Вт вместо ~1,4 Вт. Заряд переключения в даташите не указан; при 5–7 нКл потери LED2 составят 0,33–0,41 Вт. Q501 остаётся TK22E10N1: он стоит на радиаторе с запасом по нагреву; перевод Q501 на CSD19534KCS даёт −0,6 Вт за +1,71 € без изменения посадки и крепления. Это расчёт, а не измерение. На прототипе проверить нагрев Q601 (см. «Q601 без радиатора») и звон/выброс на SW и стоке Q601 при полной яркости: фронты быстрее (Qgd втрое меньше), а 63-вольтовые выходные конденсаторы требуют измеренного выброса ниже 63 В; при слишком резких фронтах увеличить R807 (4,7 Ом) ценой потерь.

**Выходные диоды D501/D601: SS8PH10 с 23.10.2026.** По решению Игоря Vishay SS5P10-M3/86A (Electrobase, 1,09 €) заменён на [SS8PH10-M3/86A](https://www.vishay.com/en/product/88989/) (Electrobase, 0,59 €, у поставщика больше 1000 шт., MOQ 1): −1,00 € за два. Корпус тот же, TO-277A (SMPC), выводы анод–катод–анод; рекомендованный рисунок площадки в даташитах SS5P10 и SS8PH10 одинаков (6,80; 4,72 мин; 1,27 мин; 1,04; 1,40 мин; 4,80 мин мм), поэтому посадка `Vishay_TO-277A_D_K1_A2`, 3D-модель и медь не менялись. По даташитам: 100 В / 8 А вместо 5 А, Tj до 175 °C вместо 150 °C, обратный ток при 125 °C не более 0,3 мА вместо 5 мА. Прямое падение при токах платы (около 1,1 А у LED1 и 0,46 А у LED2) в даташитах есть только на графиках; по табличным точкам у SS8PH10 оно может быть выше примерно на 0,05 В, то есть до 0,05 Вт на диод у LED1 (оценка, не измерение). На прототипе измерить нагрев D501/D601 вместе с ключами.

## Измерение мощности (INA226)

Продажа INA226AIDGSR поштучно подтверждена Игорем 24.10.2026; BOM предусматривает покупку одной микросхемы. Цена 3,94 € остаётся из снимка 21.10.2026, текущий складской остаток не уточнялся.

21.10.2026. Плата сама измеряет напряжение, ток и мощность, которые берёт от БП (вместе со всеми нагрузками), чтобы показывать ватты в веб-интерфейсе.

**Данные для прошивки.**

| Параметр | Значение |
|---|---|
| Микросхема | U102 TI INA226AIDGSR, VSSOP-10, питание VS = +3V3 (C115 100 нФ) |
| Шина | общая I²C с RTC: SDA GPIO21, SCL GPIO22 |
| Адрес | **0x40** (A0 = A1 = GND). 0x44/0x45 не использовать: это адреса внешнего SHT4x |
| Шунт | **5 мОм**: R111 ‖ R112, два 0R01 2512 3 Вт 1 % |
| Предел тока | 81,92 мВ / 5 мОм = **16,4 А** (F101 15 А, БП ≥10 А) |
| Калибровка | Current_LSB = 0,5 мА (16,384 А / 2¹⁵), CAL = 0,00512 / (Current_LSB · R) = **2048** |
| Шаг регистров | шунт 2,5 мкВ (= 0,5 мА), шина 1,25 мВ, ток 0,5 мА, мощность 25 · Current_LSB = 12,5 мВт |
| Конфигурация | предложение 0x4727: усреднение 64, 1,1 мс на шину и шунт, непрерывный режим; новое значение ~каждые 0,14 с |
| Опознание | регистр 0xFE = 0x5449 («TI»); 0xFF = 0x2260 или 0x2261 |
| ALERT | не подключён |

Если INA226 не отвечает, интерфейс показывает прочерк, а управление работает как прежде: датчик не участвует в логике защиты.

**Схема.** Шунт стоит в минусе питания между GND платы и истоком Q102 (новая цепь RTN_SHUNT, класс HEAVY24): весь обратный ток платы и её нагрузок идёт GND → R111‖R112 → Q102 → J101.2. Измерение на нижней стороне выбрано потому, что TVS D101 при выбросе ограничивает +24 В только до ~42 В, а это выше предела 40 В для входов INA226. IN+ (вывод 10) снимает потенциал с площадки GND шунта R111, IN− (вывод 9) — с его площадки RTN_SHUNT; оба отвода Kelvin. VBUS (вывод 8) подключён к +24V_FUSED через R113 1 кОм; погрешность от входного сопротивления VBUS 830 кОм около 0,12 %, её можно учесть в прошивке. D103 BZV55-C33 (33 В) от VBUS к GND держит вывод ниже 40 В, когда D101 ограничивает выброс на 42 В: ток через 1 кОм тогда ~7 мА идёт в стабилитрон. При 25 В стабилитрон не проводит. Измеряемое напряжение — +24V_FUSED относительно GND платы, то есть после F101 и до шунта. Мощность = это напряжение × ток шунта; потери в F101, Q102 и самом шунте (до ~0,5 Вт при 10 А) в неё не входят.

GND платы при 10 А выше минуса БП на ~0,05 В (шунт) плюс падение на Q102 (~0,1 В). Внешний программатор или USB с землёй ПК по-прежнему нельзя делать обратным проводом питания (см. «Питание и силовые узлы»): ток пойдёт мимо шунта и показания будут занижены.

**Точность.** INA226 сам по себе даёт ~0,1 % по усилению и ±10 мкВ смещения (±2 мА). Основная погрешность — шунт: допуск 1 %, толстоплёночный резистор неизвестного TCR, нагрев до ~0,25 Вт на каждом при 10 А, плюс неравное деление тока между R111 и R112 из-за меди. Без калибровки ожидать ±3–5 %. Достаточно один раз сравнить показания тока с мультиметром на постоянной нагрузке и задать в прошивке поправочный коэффициент.

**Размещение и медь.** Всё снизу под Q102. R112 (4,35; 77,6) и R111 (12,15; 77,6) лежат горизонтально по обе стороны от вывода истока Q102, площадками RTN_SHUNT к нему; исток соединён с обеими площадками дорожкой 3 мм. Поэтому путь тока к двум шунтам одинаковый. Площадки GND шунтов (снаружи) имеют по 5 переходных к GND (раньше 10 стояли у истока Q102). U102 (12,0; 83,2) стоит под шунтами, C115 слева от него, D103 и R113 ниже. Делитель затвора Q102 (R110, R109, R108) перенесён вправо в столбик при x=18,92: прежнее место заняли шунты. В `routing.json` новые маршруты: силовой путь, два Kelvin-отвода 0,25 мм, VS, GND вывода 7, VBUS, затвор Q102 и REVP_MID; три новые группы связности (RTN_SHUNT, INA_VBUS, REVP_GATE). Питание +3V3 0,4 мм тоже задано вручную: от C115 по B.Cu к переходному (5,4; 79,4) у R303, оттуда по F.Cu к U402.5 и по In2.Cu к переходному у U401.5, потому что сеточный трассировщик не находил зазора у вывода 6 U102. Вывод GND U402.2 соединён короткой дорожкой с отдельным переходным (14,6; 82,5): вокруг него дорожки FLOAT_EXT и +3V3 оставляли верхнюю заливку GND островом. Отвод IN+ имеет цепь GND, поэтому вокруг него и вывода 10 задана зона без заливки и переходных (`fill_keepouts`, слой B.Cu), а `route_board.py` не ставит к выводу 10 свой переходной (`KELVIN_PADS`). Иначе заливка GND соединила бы отвод с землёй по всей длине, и в измерение попало бы падение напряжения на заливке.

## Медь и токи

Расчётная проверка для первого прототипа завершена 22.10.2026; Gerber и сверловка выпущены 24.10.2026, заказ PCB подтверждён пользователем. Выбранные требования записаны в PCB и проверяются
`tools/stackup.py`: 4 слоя, стек JLCPCB JLC04161H-7628 (как у PCB_V1 и cheap-version,
[FAB.md исходного проекта](https://github.com/nikolajevs/ai/blob/390374ec6d7405bd25f6ed4380bc14fe30cf3cde/hardware/PCB_V1/FAB.md), подтверждено Игорем 22.10.2026): F.Cu/B.Cu 35 мкм,
In1.Cu/In2.Cu 15,2 мкм, препрег 7628 0,2104 мм, сердечник 1,065 мм, препрег 0,2104 мм,
маска по 0,01 мм, всего 1,6062 мм, εr 4,6. До 22.10.2026 в файле стояла предварительная
геометрия 0,2/1,075/0,2 мм и 17,5 мкм; расчёт токов пересчитан на 15,2 мкм (внутренние слои
греются на 2–4 K сильнее, худший результат 17 °C на шинах 12 В и 3,3 В; силовые 24 В идут по внешним слоям,
без изменений). Это числа завода из платы PCB_V1, а не расчёт заказа на эту плату: допуски готовой меди
и металлизацию отверстий подтверждает JLCPCB при заказе; контролируемый импеданс не заявлен.

`tools/ampacity.py` исправлен: широкая дорожка теперь сохраняет все контакты
параллельных переходных, в том числе с одинаковой проекцией; разорванная цепь
не может дать ложный результат через least-squares. Проверяются связность
источника/нагрузок и остаток KCL. Шесть регрессионных тестов проверяют симметричный
банк, перестановку/отражение, разрыв, свободную медь и сохранение тока.

Усиление без перестановки компонентов:

- +24V_RAW: добавлены три переходных 1,0/0,5 мм; +24V_PTC — два;
  +24V_FUSED — два, включая банк у (29,9; 58,4), который проявился в проверке чувствительности.
- Возврат R111.1/R112.1: по два дополнительных переходных 1,0/0,5 мм
  к GND на каждый шунт, в дополнение к прежним пяти 0,6/0,3 мм.
  Наличие связи подтверждается native connectivity; равное распределение тока не предполагается.
- +12V: параллельный путь 0,8 мм от L101.2 до F401.1, четыре переходных
  1,0/0,5 мм; 11 свободных участков прежней In2-ветки расширены до 0,7/0,8 мм.
  Это разгружает длинную внутреннюю дорожку питания вентиляторов.
- Планы дорожек и переходных сохранены в `routing.json`. `route_board.py`
  повторяет расширение вспомогательной ветки после импорта сохранённых сессий.

`tools/power_checks.py` повторяет 24 расчёта восьми цепей 24 В: вход 9,5 А
(PTC 4,5; LED1 2,8; LED2 1,2; питание 12 В 0,7; помпа 0,3 А) при
0,5/1/2 номинального сопротивления гильз. Наибольший ток переходного —
**1,55 А в номинале, 1,90 А во всём диапазоне чувствительности**, вместо
прежних 2,91/3,84 А. Превышений выбранных ориентиров по сверлению нет.
Сравнение с 1/2/3 А для сверловки 0,3/0,5/0,8 мм — скрининг, а не гарантированный рейтинг.

Дополнительно рассчитаны 12 В и 3,3 В. Вентиляторы: по 0,45 А (вместе 0,9 А,
выше прежнего бюджета 10 Вт); логика 12 В — 0,27 А плюс 12 мА драйверу/компаратору.
На 3,3 В: ESP32 0,5 А, SD 0,25 А, остальная обвязка 34 мА.
Падение +12V до F401.1 уменьшено примерно со 123 до **31 мВ**; наибольший
расчётный нагрев его проводников — **13 °C над окружающей средой** вместо 38 °C.
Ветка +12V_FANS: 14 мВ / 8 °C; 3,3 В: около 101 мВ до ESP32 / 14 °C.

Отчёт — `review/power_copper.json`: 27 DC-сценариев, ток каждого переходного,
падения, потери, KCL и SHA платы. Проверку выполняет общий `run_checks.py`.
Фактические температуры не измерены: короткие входные/возвратные шейки всё ещё
дают около 38 °C расчётного подъёма по IPC-2221. Модель одномерная, не решает
теплоотвод, GND-заливки, THT-гильзы, импульсные токи преобразователей, пуск и EMC.
На прототипе нужны измерения полной нагрузки, шунтов, предохранителей, переходных
и преобразователей; расчётная проверка не заменяет эти испытания.

## Клеммы по краям (22.10.2026)

Просьба Игоря: снять радиатор со слабого канала LED2, освободить место и поставить все винтовые клеммы к краям платы; вентиляторы подключать 4-пиновым хидером 2510-4P, потому что они приходят со своим разъёмом; внешний SHT4x подключать угловым разъёмом XH2.54-4P-90 вместо винтовой клеммы.

**Что переставлено.**

| Деталь | Было | Стало |
|---|---|---|
| J101, вход 24 В (DG301R) | внутри платы (14; 56), провода вниз | левый край (8,25; 50,65), провода наружу; J101.2 прямо над фланцем Q102 |
| F101 (15 А) | (9,5; 61,5) вертикально | (14,0; 54,3) горизонтально, между J101.1 и магистралью к C101 |
| J701, PTC | внутри платы (17; 83), DG301R | нижний край (46; 96), DG306 на месте прежнего J702 |
| J702, помпа, и её Q704, R707, R708, D701 | нижний край (46; 96), обвязка снизу | правый край (96,06; 64) на месте резерва HS2, обвязка сверху рядом |
| J411/J421, вентиляторы | четыре DG306 J411, J412, J421, J422 | два хидера KF2510-4A на левом краю, J412/J422 удалены из схемы |
| J201, UART | внутри (12; 34) | левый край (4; 9,75), под RF-зоной ESP32 |
| J401/J402, SHT4x (две DG306) | нижний край (7; 96) и (20; 96) | один угловой XH2.54-4P-90 (JST XH S4B-XH-A) J401 у нижнего края, ряд выводов (17,2; 90,0), вилка выходит за край; J402 удалён из схемы |
| R113 (снизу), R403/R404 | (16,8; 88,2), (26,5; 87,0), (26,5; 83,5) | (16,8; 86,7), (26,5; 84,0), (26,5; 80,5): освободили габарит J401 и 0,5 мм вокруг его выводов с обратной стороны |
| D421 (ESD вентилятора 2) | (13,5; 50,5) | (9,5; 43,5), рядом с J421 |
| Резерв HS2 | 32×32 мм над Q601 | снят |

LED2 (J601, J602) остался внизу: его силовая петля разведена вручную, а путь от R602 к правому краю перекрыт Kelvin-линией IS и затвором Q601. Поэтому на освободившееся место справа ушла помпа: её ток 0,25 А трассируется где угодно.

**J701 на DG306.** Внизу DG301R (корпус 10 мм в глубину) упирается в Q703, F102 и C602. DG306 рассчитана на 15 А и провод до 1,5 мм² при токе PTC 4,5 А и стоит в общем ряду нижних клемм. Покупка с 23.10.2026 по решению Игоря: DG306 — 6 шт. (было 11), DG301R — 1 шт. (было 2), запасных нет.

**SHT4x.** J401: 1 +3V3, 2 GND, 3 SDA, 4 SCL (порядок прежних J401/J402: питание, затем шина). Цепи, ESD U401 и последовательные R401/R402 не менялись. Деталь указана как «XH2.54-4P-90», посадка — официальная JST XH S4B-XH-A с шагом 2,50 мм: клоны «XH2.54» обычно именно такие, но шаг имеющейся дома вилки и порядок проводов кабеля датчика нужно сверить до заказа PCB. Наличие XH2.54-4P-90 дома подтверждено Игорем 24.10.2026; покупать разъём не нужно.

**Вентиляторы.** J411 (FAN1) и J421 (FAN2): 1 GND, 2 +12V_FANS, 3 TACH, 4 PWM, как у 4-проводных вентиляторов ПК. Посадка — Molex KK-254 из библиотеки KiCad; соответствие имеющихся KF2510 проверить примеркой. Наличие KF2510-4A дома подтверждено Игорем 24.10.2026, две штуки выделены на J411/J421; покупать их не нужно. Цепи и защита (ESD, тахо-делители, PWM-ключи) не менялись, только разъём.

**Q601 без радиатора.** Потери ключа LED2 ~0,37 Вт при 24 В (CSD19534KCS, таблица «Ключи LED»; у TK22E10N1 было бы ~0,65 Вт). CSD19534KCS без радиатора: Rth(j-a) 62 К/Вт ([TI](https://www.ti.com/lit/ds/symlink/csd19534kcs.pdf)), перегрев ~23 °C, при 40 °C вокруг кристалл ~63 °C (с TK22E10N1 было бы ~94 °C); при 21,6 В на входе ~65 °C. Предел 150 °C. Это расчёт: на прототипе измерить корпус Q601 при полной яркости. Если будет горячее 100 °C, место над Q601 частично занято J702 и обвязкой помпы, поэтому вернуть радиатор без новой перестановки не выйдет.

**Медь.** Силовые пути, которые шли к старым местам, проложены заново в `routing.json`:
- +24V_RAW, J101.1 → F101.1: F.Cu 3,0 мм и параллельно B.Cu 3,0 мм с тремя переходными 1,0/0,5 мм у F101.1;
- PSU_RTN, J101.2 → фланец Q102: B.Cu 4,5 мм, около 3 мм длины;
- +24V_FUSED, F101.2 → C101.1: F.Cu 3,0 мм и B.Cu 3,0 мм, четыре переходных 1,0/0,5 мм у F101.2, прямо по y≈53,5. От площадки F101.2 идёт шейка F.Cu 2,4 мм длиной 0,65 мм, начало которой лежит внутри площадки (15,75; 54,3): круглое окончание дорожки 3 мм из центра площадки подошло бы к концу дорожки +24V_RAW ближе 0,2 мм, а без шейки KiCad не считает дорожку подключённой к площадке;
- +24V_PTC, F102.2 → J701.1: прежний подвод F.Cu к трём переходным, дальше B.Cu 3,0 мм вниз к клемме, ~12 мм вместо 43 мм;
- PTC_DRAIN, J701.2 → фланец Q703: F.Cu 2,4 мм вдоль нижнего края и 2,0 мм вверх к фланцу; теперь задан планом (`replace_session_nets`).

**Результаты проверок** (KiCad 10.0.7, 22.10.2026; состояние после переноса клемм, до переноса электролитов; актуальные числа после него — в разделе «Электролиты на одной стороне»).
- `tools/run_checks.py --allow-other-version`: ERC 0 ошибок и 0 предупреждений, 56 проверок соединений, 22 991 проверок размещения (196 позиций, 525 назначений pin/net), 2198 проверок посадок, STEP-модель у всех 188 устанавливаемых компонентов.
- DRC со сверкой схемы: **0 нарушений, 0 расхождений со схемой, 0 неразведённых соединений**; 1399 участков дорожек, 323 переходных. Пересборка `build_board.py` → `route_power.py` → `route_board.py` по сохранённым `routing/pass1.ses` и `pass2.ses` дала плату, побайтово совпавшую с `PCB_EU.kicad_pcb` (два независимых прогона). Сессии трассировщика обновлены: прежние не подходили к новой расстановке.
- Все десять разъёмов с кабельным входом (J101, J401, J403, J411, J421, J501, J601, J602, J701, J702) обращены входом наружу, зазор от габарита до края платы 0,25–0,57 мм; UART J201 стоит у левого края.
- Ток по меди, `tools/ampacity.py` на готовой плате (1 oz снаружи / 0,5 oz внутри, IPC-2221, расчётный худший случай, вход 9,5 А):

| Цепь | Ток | Нагрев над окружающей средой, °C |
|---|---:|---|
| +24V_RAW, J101.1 → F101.1 | 9,5 А | B.Cu 3,0 мм (4,5 А): 7; F.Cu 3,0 мм: 16, последние 1,4 мм у F101.1: **38** |
| PSU_RTN, J101.2 → Q102 | 9,5 А | B.Cu 4,5 мм: 19 |
| RTN_SHUNT, Q102 → шунты | 9,5 А | B.Cu 3,0 мм, 4,8 мм длины: **38** (без изменений) |
| +24V_FUSED, F101.2 → C101.1 | 9,5 А | F.Cu 3,0 мм (4,75 А): 8, B.Cu 3,0 мм: 18; начало ветки у C101.1 (B.Cu 3,0 мм, 8,8 А, 5,7 мм): **32** |
| +24V_FUSED → F102.1 (PTC) | 4,5 А | F.Cu 1,5 мм, 24 мм: 22 |
| +24V_PTC, F102.2 → J701.1 | 4,5 А | B.Cu 3,0 мм, 14 мм: 7; F.Cu 2,0 мм, 4,5 мм: 13 |
| PTC_DRAIN, J701.2 → Q703 | 4,5 А | F.Cu 2,0 мм: 13; 2,4 мм: 10 |
| +24V_LED1 / +24V_LED2 | 2,8 / 1,2 А | 5 / 2 |

  Худшее место теперь 38 °C (было 54 °C на шейке F101.1 до переноса); у F101.2 перегрева нет. Падение на +24V_FUSED 68 мВ, потери в меди этой цепи 0,52 Вт; на входе RAW, PSU_RTN и RTN_SHUNT вместе ещё 0,18 Вт. Модель присоединяет площадку к дорожке там, где их медь перекрывается, поэтому ток F101.2 делится между F.Cu и B.Cu сразу у площадки; это же перекрытие реально существует в меди.
- До окончательной проверки силовой части три переходных 1,0/0,5 мм превышали ориентир ~2 А: ближайший к F101.1 в стопке +24V_RAW (11,59; 53,39) — 2,9 А, на ножке PTC (46,6; 84,9) — 2,5 А, на ветке +24V_FUSED (42,6; 71,3) — 2,25 А. После добавления параллельных переходных эти превышения устранены; актуальный расчёт — в разделе «Медь и токи». Тепловые измерения остаются испытанием прототипа. До этой правки магистраль вообще не была присоединена к F101.2 (дорожка начиналась в 0,55 мм от площадки, ток шёл по сеточным дорожкам 0,8 мм): найдено и исправлено до сборки, проверка `ampacity.py` после каждого переноса силовой меди обязательна.

**Для проверки BOM** (количества покупки и сумму не менял, их пересчитает проверка BOM):
- KF2510-4A, 2 шт. из домашних запасов (подтверждение Игоря 24.10.2026), к покупке 0;
- XH2.54-4P-90 (угловая вилка, 1 шт.) из домашних запасов (подтверждение Игоря 24.10.2026), к покупке 0; шаг и посадку JST XH S4B-XH-A сверить;
- DG306: нужно 6, покупка 6; DG301R: нужно 1, покупка 1 (запасные штуки убраны из покупки 23.10.2026 по решению Игоря);
- RAD-DY-GF/3, TO220-SET, SMICA-TO220-2: нужно по 1; 23.10.2026 по решению Игоря второй комплект убран из покупки (к покупке по 1).

## Электролиты на одной стороне (22.10.2026)

Просьба Игоря: перенести все электролиты на одну сторону, чтобы уменьшить толщину платы с деталями. Теперь все двенадцать электролитов стоят сверху; снизу нет деталей выше 8,05 мм.

**Что перенесено** (координаты вывода 1, вид сверху):

| Деталь | Цепь | Было (снизу) | Стало (сверху) |
|---|---|---|---|
| C508, 100 мкФ 63 В, 8×15 | LED1_OUT | (84,7; 50,0), у R501 | (70,0; 56,0), поворот 180°, рядом с C510 |
| C601, 220 мкФ 50 В, 10×16 | +24V_LED2 | (52,5; 77,6) | (68,0; 70,0), 90°, слева от L601 |
| C609, 100 мкФ 63 В, 8×15 | LED2_OUT | (80,7; 95,0), у C611 | (69,0; 80,0), 90° |
| C608, 100 мкФ 63 В, 8×15 | LED2_OUT | (67,7; 88,3) | (68,0; 86,5), 180°, вывод 1 в 5 мм от катода D601 |

Место освободилось после снятия резерва HS2: между C510/C602 и L601 (x≈61–74 мм, y≈52–91 мм) теперь стоит столбик из четырёх конденсаторов. Места подобраны перебором по сетке 0,25 мм по тем же правилам, что в `tools/verify_board.py` (зазор courtyards 0,15 мм, 0,5 мм вокруг паек на обратной стороне, резерв HS1, крепёж, RF-зона), и по длине связи до своего узла (D601, D501/C511, L601/C602). Корпуса не заходят на D601, Q601, D501 и на контур L601.

**Высота** по 3D-моделям. Снизу раньше самым высоким был C601 (16,15 мм), теперь — дроссели L501/L502/L601 JNRH1207 (8,05 мм). Сверху без изменений: C112 (20,15 мм) и TO-220 Q501/Q601 (18,8 мм). Плата с деталями: 20,15 + 1,6 + 8,05 = 29,8 мм вместо 20,15 + 1,6 + 16,15 = 37,9 мм, на 8,1 мм тоньше. Выводы THT снизу при обычной обрезке (2–2,5 мм) ниже дросселей; в 3D-моделях выводы Q501/Q601 не обрезаны и выступают на 8,15 мм (на рендере и в STEP это видно). Радиатор HS1 и крепёж не учтены.

**Медь** (`routing.json`):
- LED2_OUT: D601 → C608 → C609 по F.Cu 1,5 мм (5 и 6,6 мм). D601 → C611 прежним путём, теперь прямо к C611 (раньше через вывод C609). ВЧ-петля Q601 → D601 → C611 (100 нФ) → GND → R601 → Q601 не изменилась. Петля через электролиты изменилась: на стороне D601 она короче (5 мм вместо 11 мм), но возврат C608/C609 к R601 теперь идёт через заливки и In1 (16–18 мм), а не по явной дорожке GND.
- GND петли LED2: R601 → C611 по F.Cu 1,2 мм; минусовые выводы C608/C609 соединены с GND заливками и плоскостью In1 (по четыре луча термобарьера на слой; сплошное подключение не нужно).
- +24V_LED2: F104.2 → C601 по F.Cu 1,2 мм вдоль y=68; F104.2 → C602 прежним путём; C601 → L601 по B.Cu 1,5 мм, около 10 мм вместо 25.
- LED1: короткая GND-дорожка R501 → C508 и B.Cu C511 → C508 убраны. C508 теперь рядом с C510 и, как C509/C510, подключён автотрассировщиком: C508.1 → D501.1 по F.Cu 0,6 мм около 8 мм (раньше B.Cu 1,2 мм, 8,9 мм), C508.1 → C510.1 по F.Cu 0,4 мм около 17 мм, GND — через заливки и In1 (раньше явная дорожка 2 мм до R501, теперь 25 мм до R501). ВЧ-конденсатор C511 у D501 остался на месте, отвод HSP от R503 по-прежнему приходит к концу его дорожки.
- `PCB_EU.kicad_dru` теперь без правил: сплошные подключения C609 и C510 к заливкам больше не нужны.

**Проверки** (KiCad 10.0.7). Новый прогон Freerouting, сессии `routing/pass1.ses` и `pass2.ses` обновлены. ERC 0/0, 56 проверок соединений, 22 639 проверок размещения, DRC со сверкой схемы: 0 нарушений, 0 расхождений, 0 неразведённых; 1425 участков дорожек, 327 переходных, 293 объекта плана, 24 физически связанные группы. Пересборка из репозитория побайтово совпала с `PCB_EU.kicad_pcb` в двух прогонах. Новый прогон автотрассировщика переложил часть сигнальной меди: из 108 цепей изменилась медь у 54 (+3V3, +12V, I2C, SD и другие); DRC, связность, ток по меди и RF-зона проверены, но состав дорожек сигнальных цепей другой. `tools/ampacity.py`: приведённые здесь результаты относятся к состоянию до окончательного усиления; актуальный скрининг — в разделе «Медь и токи»; у +24V_FUSED автотрассировщик чуть изменил участок 0,8 мм (переходных 20 вместо 19); +24V_LED2 до L601 при 1,2 А: 1,5 °C, падение 11,5 мВ.

**Что проверить на прототипе.**
- Нагрев: C608 стоит в 0,5 мм (courtyard) от D601 и в 0,26–0,32 мм от C602, J601 и J602; C601 и C609 — рядом с контуром L601 (дроссель на обратной стороне, зазор 0,26–0,62 мм). Электролиты рядом с горячими деталями стареют быстрее. При полной яркости LED2 измерить температуру корпусов C608, C609, C601 и C602.
- Пульсации и выбросы: выходной банк LED1 теперь в 25 мм от шунта R501 (рядом с D501 остался только C511 100 нФ), а возврат банка LED2 идёт по In1. Измерить выброс на стоке Q501/Q601 и пульсации на выходе обоих каналов при полной яркости.
- Цепь LED_NDIM: после нового прогона автотрассировщика переходное U601.7 (84,42; 84,35) стоит в 0,22 мм от B.Cu-дорожки LED2_SW 1,8 мм (раньше 2,3 мм); DRC чист, но на прототипе проверить помехи на nDIM и при необходимости развести этот отвод вручную.
- Под платой нужно не меньше 8,05 мм свободного места (дроссели) плюс запас стоек; выводы THT обрезать до 2–2,5 мм.

## Шелкография (22.10.2026)

`tools/silkscreen.py` добавляет на F.SilkS/B.SilkS отдельную группу текстов,
сохраняя исходные Fab-обозначения, библиотечные знаки полярности, размещение,
дорожки и заполненные зоны. Генерация проверяет цепи выводов по PCB и
`design.json`, отступает от корпусов, маски площадок, переходных отверстий,
резервов крепежа и радиатора. Размер текста 1,0 мм (минимум JLCPCB; до 22.10.2026
было 0,8–0,9 мм), толщина штриха 0,15 мм. Библиотечный шёлк деталей (контуры
электролитов, корпусов, разъёмов) тем же `silkscreen.py` через `tools/silk_clean.py`
обрезан на 0,15 мм от площадок, отверстий и переходных, штрих и тексты не тоньше 0,15 мм и не ниже 1,0 мм;
файлы библиотек не менялись, меняется только копия в плате. Позиции добавляются на стороне компонента там, где
есть место и сохраняется однозначная привязка к детали; пропуски перечислены
в `review/silkscreen.json`.

Подписи разъёмов включают назначение, питание и сигналы; с обратной стороны
плата читается снизу (текст зеркален в системе координат вида сверху).
У J101 минус — `PSU_RTN`, у J701/J702 — коммутируемые возвраты нагрузок:
на них ставится `-`, а не `GND`. J601 и J602 принадлежат одному каналу LED2,
второй помечен `BAR2`. UART TX/RX указаны со стороны ESP32.

У всех 12 электролитов сохранены библиотечные `+` у вывода 1 и обозначение
отрицательной половины корпуса. Дополнительные `+` добавляются со стороны пайки,
где хватает места; сверху штатные знаки не дублируются. Для BT301 отмечен положительный контакт VBAT.
У D101/D102/D103/D501/D601/D701 катод — вывод 1, у D801 — вывод 3;
маркер `K` ставится на стороне SMD-компонента, где позволяет свободное место.
Шелкография не заменяет сборочные Fab-виды для плотных групп SMD.
Библиотечные посадки большинства микросхем несут метку вывода 1 только на Fab (у одной на
стороне слота карты метки не было совсем), поэтому 22.10.2026 добавлена заливная точка у
вывода 1. Точка 0,6 мм стоит не на площадках, переходных, чужой
шелкографии и чужих корпусах, ближе к выводу 1, чем к любой другой площадке (запас 0,25 мм),
и на 0,3 мм ближе к нему, чем к площадке соседней детали, чтобы не читаться как метка соседа.
Так размещены U101, U102 (снизу), U301 и U802. У SOT-23-6/TSOT-23-6 (U201, U401, U402) места
снаружи нет: точка 0,5 мм стоит между рядами площадок у конца вывода 1; она
задаёт конец с выводом 1, а перевернуть такую микросхему зеркально нельзя. У U202 остался
библиотечный треугольник, у U501 и U601 (LM3429, снизу) — библиотечное кольцо у вывода 1
(диаметр около 0,4 мм), точки у них не добавлялись.
В текущем варианте добавлено 169 элементов: 162 надписи (62 сверху, 100 снизу),
включая 80 отдельных позиционных обозначений, и 7 точек (6 сверху, 1 снизу) со штрихом 0,15 мм.
С текстом 1,0 мм вместо 0,8–0,9 мм 12 позиционных обозначений не нашли места (пропущено 107, было 94):
их деталь читается по Fab-слою и сборочным чертежам.
Минус у вывода 2 J501 сверху (там стоял раньше) не поставлен: место теперь занято резервом и корпусом радиатора; сверху у J501 остался плюс, снизу есть оба знака. Все подписи выводов разъёмов имеются
хотя бы с одной стороны; часть функций и распиновок читается только снизу.
Для полного заголовка `J403 FLOAT` места не найдено, у его выводов есть
`SIG` и `GND`. Отдельный Ref U202 опущен: широкий RF-courtyard нельзя
использовать как габарит корпуса для выноса обозначения.

После изменения размещения/разводки выполнить генерацию, затем проверки и
обновление обзоров; точные команды — в README. Генератор сравнивает все
данные PCB за исключением своей группы текстов; повторный запуск должен
давать тот же файл. `run_checks.py` отклоняет устаревшую шелкографию и
запускает обычный DRC без подавления нарушений.

## Нормы JLCPCB (22.10.2026)

Завод и стек те же, что у PCB_V1 и cheap-version (Игорь, 22.10.2026): JLCPCB, 4 слоя, 100×100 мм,
JLC04161H-7628 (числа в `tools/stackup.py`), медь 1 oz снаружи и 0,5 oz внутри, HASL, маска 1:1,
переходные закрыты маской, переходное по умолчанию 0,3/0,4 мм (наши 0,3/0,6 и 0,5/1,0 проходят).
`hardware/check_fab.py` сверяет плату с нормами JLCPCB и замечаниями JLCDFM по V1; `run_checks.py` запускает
его и пишет `review/fab_check.txt`: 0 FAIL, 3 WARN, те же три, что у V1 (штрих шёлка на минимуме 0,15 мм,
кольцо переходного на минимуме 0,15 мм, узкие щели внутри одной цепи).

Чего добились 22.10.2026 по первому прогону (5 FAIL, 3 WARN):

- 8 дорожек своей цепи проходили мимо площадки ближе 0,09 мм без касания, маска открывала и дорожку, и площадку;
  ещё два переходных стояли в 0,05–0,06 мм от площадки своей цепи. `tools/dfm_tracks.py` вызывается из
  `route_board.py` после сеточной трассировки и сдвигает ближайший излом (или всю дорожку) на минимальный шаг до
  0,1 мм от площадки, не сближаясь с чужой цепью меньше 0,2 мм; вывод `pad_skims_moved` в отчёте `route_board.py`.
  Сдвиги: C206.1, U201.6, R602.2, U101.13 (дорожка 0,6 мм на 0,012 мм), R705.2, R106.1, C507.1. Медь плана
  `routing.json` инструмент не трогает: два переходных плана у площадок сдвинуты в самом плане
  (`cu-raw-3` у F101.1 на 0,05 мм, `led2-comp-pin` у U601.2 на 0,06 мм), а `LED2_COMP` добавлена в
  `replace_session_nets`, чтобы старая копия этой меди из записанных сессий не осталась рядом.
- Библиотечный шёлк корпусов обрезан от площадок (278 замечаний → 0), штрих и подписи не тоньше 0,15 мм,
  подписи не ниже 1,0 мм (`tools/silk_clean.py` внутри `silkscreen.py`, см. «Шелкография»); точки вывода 1 со штрихом 0,15 мм.
- `fab_exceptions.json`: переходные внутри площадки своей цепи сделаны намеренно и пропускаются в проверке:
  тепловые площадки U501.15, U601.15, U101.17; BT301.2, J301.SH; D501.1, R502.2 и J101.1 несут ток; U401.5 — переходное
  в площадке вывода +3V3 от трассировщика. В площадке переходное при пайке в печи уносит припой; прототип паяется вручную.
  Для U401.5 решение за Игорем: можно вынести переходное из площадки.
- Обрезанный шёлк делает копию корпуса в плате отличной от библиотечной (77 корпусов), и родной DRC KiCad
  выдаёт на них `lib_footprint_mismatch`. Глушить категории DRC в проекте нельзя, поэтому
  `tools/verify_library_match.py` сравнивает каждый корпус платы с библиотечным родным сравнением KiCad
  (`FootprintNeedsUpdate`) после удаления шёлка с обеих сторон; `run_checks.py` пропускает предупреждение только для
  корпусов, которые отличаются одним шёлком, любое другое отличие (площадки, слои, модели, поля) остаётся ошибкой
  (`review/library_match.json`: 119 совпадают полностью, 77 отличаются только шёлком, 5 без привязки к библиотеке).

## Что остаётся до прототипа

1. **Посадочные места и механика.** 27 новых Ref сверены с чертежами; остальные 169 пакетных назначений требуют своей сверки, все посадки — физической/сборочной квалификации. Имеющиеся дома разъёмы сверить до заказа PCB: J401 (шаг 2,50 мм у JST XH и клонов «XH2.54», порядок проводов кабеля SHT4x) и J411/J421 (KF2510 против Molex KK-254, нумерация проводов вентиляторов). Для текущего размещения проверить фактические корпуса, высоты сверху/снизу, пайку, инструмент и провода клемм, извлечение карты/батарейки, реальные стойки. PCB заказана 24.10.2026; отдельного подтверждения этих проверок и визуального осмотра нет, они остаются открытыми для сборки прототипа.
2. **Радиатор.** Один RAD-DY-GF/3 стоит торцом на плате, ножками в два отверстия GND (HS1), и привинчивается к Q501 винтом М3 (винт у Игоря, в BOM не добавляется). Прокладка SMICA-TO220-2 остаётся; TO220-SET (винт, гайка, шайба, втулка, слюда) частично избыточен (нужна втулка под головку винта); второй радиатор, TO220-SET и SMICA-TO220-2 убраны из покупки 23.10.2026 по решению Игоря. Фланец TO-220 — сток, изоляцию, положение резьбы и ножек проверить при сборке. Нагрев Q601 без радиатора и звон на SW у Q601 с более быстрым CSD19534KCS измерить на прототипе.
3. **Аналоговые узлы.** L7987 компенсация рассчитана в CCM при объявленных допусках; реальная ёмкость, вентиляторы/пуск и DCM не проверены. Чертежи Jantek для 10 и 22 мкГн указывают ±30%; при расчёте пиков учитывать этот допуск. Для AP63203 6,8 мкГн отличается от типовой рекомендации: проверить устойчивость и ступень нагрузки. LM3429 с COMP 22 мкФ требует проверки старта, PWM и DCM. OVP около 54,6 В не доказывает отсутствие выброса выше 63 В.
4. **Нагрузки и защита.** Подтвердить LED-токи и распределение тока между линейками (J601/J602 параллельно на одном стабилизаторе: до сборки измерить Vf обеих линеек при 0,23 А; при заметной разнице — балластные резисторы или последовательное включение с пересчётом OVP), пуск вентиляторов и помпы, нагрев MOSFET/диодов/дросселей, работу БП и предохранителей. Сохранить отдельную внешнюю термозащиту PTC. Сверить ток INA226 с мультиметром и задать поправку в прошивке; проверить нагрев шунтов R111/R112 при полной нагрузке.
5. **Разводка, прошивка и изготовление.** Плата разведена полностью, ERC и DRC чисты на целевом KiCad 10.0.7. Расчётный скрининг меди и запись выбранного стека завершены (см. «Медь и токи»). Остались визуальный осмотр пользователем и подтверждение допусков готовой меди и металлизации при расчёте заказа JLCPCB (завод и стек выбраны, см. «Нормы JLCPCB»); Gerber и сверловка версии `b3f286d` сохранены в `fabrication/2026-10-24-b3f286d/`, заказ PCB подтверждён 24.10.2026. Сборочные файлы не выпускались; фактические опции заказа и результаты визуального осмотра отдельно не сообщались. Нагрев измеряется после сборки прототипа. Прошивка под PCB_EU лежит в `softwareEU` (GPIO, RTC MCP7940N, инверсия fan PWM, INA226; сборка под 4 МБ и тесты проходят), на железе не запускалась: проверить отказ датчика/RTC, сброс, SD, INA226 и сохранение настроек. Проверенного на плате бинарника пока нет.

## Первичные источники

[LM3429](https://www.ti.com/lit/ds/symlink/lm3429.pdf), [L7987](https://www.st.com/resource/en/datasheet/l7987.pdf), [AP63203](https://www.diodes.com/datasheet/download/AP63200-AP63201-AP63203-AP63205.pdf), [AO3422](https://www.aosmd.com/sites/default/files/res/datasheets/AO3422.pdf), [MCP7940N](https://ww1.microchip.com/downloads/aemDocuments/documents/MPD/ProductDocuments/DataSheets/MCP7940N-Battery-Backed-I2C-RTCC-with-SRAM-20005010J.pdf), [USBLC6](https://www.st.com/resource/en/datasheet/usblc6-2.pdf), [ESDAL](https://www.st.com/resource/en/datasheet/esdal.pdf), [GCT MEM2061](https://gct.co/Files/Drawings/MEM2061.pdf), [ESP32 module](https://www.espressif.com/sites/default/files/documentation/esp32-wroom-32e_esp32-wroom-32ue_datasheet_en.pdf), [подтяжки SD Espressif](https://docs.espressif.com/projects/esp-idf/en/stable/esp32/api-reference/peripherals/sd_pullup_requirements.html). Остальные ссылки хранятся в полях Datasheet и в снимке закупки.
