nikolajevs/PCB_EU/hardware/PCB_EU_LITE/review/Bench_checklist.md

# EU-LITE — первое включение и замеры на макете

Расчёты и проверки в репозитории ничего не говорят об устойчивости контуров обратной связи и о реальном нагреве: у ST1S14 и ST1S10 компенсация внутренняя, модели нет. Список составлен по образцу [чек-листа cheap-version](https://github.com/nikolajevs/ai/blob/7fa9410ddb7977c46e313506acb037693ad571e1/hardware/cheap-version/review/Bench_checklist_cheap1.md) и дополнен узлами, которых там не было (INA238, защита от переполюсовки, один LM3429). Ожидаемые значения — расчёт из `DESIGN.md`; пределы — рабочие критерии первой платы, а не гарантии. Физическая сборка и испытания EU-LITE не подтверждены. Использовать текущую ревизию исходников и новый согласованный производственный комплект; Gerber r1/r2 предшествуют исправлениям меди. Дата актуализации плана: 26.10.2026.

## 0. Перед подачей питания

- Лабораторный блок 24 В с ограничением тока, сначала 0,3 А. Осциллограф с короткой «пружиной» земли (не крокодил), полоса 100–200 МГц.
- Нагрузки не подключены: LED-панель, PTC, помпа, вентиляторы. Питание программатора отключено.
- Мультиметр: нет замыканий +24V_FUSED, +12V, +3V3 на GND; сопротивление +24V_FUSED – GND при измерении растёт, а не падает до нуля.
- Проверить монтаж IRL2505, INA238, DTMSS-27 и обоих электролитов: складского запаса нет. Для Q501 BSC146N10LS5 остаётся один запасной экземпляр.
- Проверить номиналы, полярность электролитов и отсутствие непропая; GND-переход U101 должен быть вне вывода 6, в (26,65;70,05 мм). Массивов тепловых переходных под U101/U201 нет: отдельно контролировать их температуру.
- Уточнить ревизию платы и поля F103: фактическая деталь `3413.0224.11` — 6,3 А USI fast. Проверка паритета должна быть закрыта до выпуска нового комплекта.

## 1. Защита от переполюсовки (Q102 IRL2505)

| Что | Ожидается | Предел |
|---|---|---|
| Вход подключён неверно (при 0,3 А) | тока нет, +12V и +3V3 отсутствуют | напряжение на плате не выше 0,7 В |
| Напряжение затвор–исток Q102 при 24 В | около 11–12 В (стабилитрон D103) | не выше 14 В |
| Падение Q102 + шунта при 7 А | около 0,1 В | до 0,2 В |
| Нагрев Q102 (TO-220 стоймя, без радиатора) при 7 А | около 0,6 Вт | не выше 90 °C на корпусе |

## 2. Питание 24 В → 12 В (ST1S14, U101)

| Что | Ожидается | Предел |
|---|---|---|
| EN2 (3×150 кОм 5 % / 47 кОм 1 %) | 2,04 В номинально и около 1,94 В в худшем резисторном углу при 21,6 В, без тока EN2 | измерить фактический уровень и устойчивое включение при 21,6/24/25 В |
| +12V в установившемся режиме | около 12,0 В; оценка VFB + резисторы 1 %: 11,54–12,45 В | записать фактическую уставку и изменение с нагрузкой |
| Пульсация +12V, 20 МГц | около 20 мВ | до 50 мВ |
| Частота на SW | типично 850 кГц; даташит 600–1000 кГц | сверить с режимом и температурой; не требовать фиксированных 850 кГц при малой нагрузке |
| Выброс на выводе VIN 7 (щуп на C107) | оценка cheap-version 3,5 В над входом | пик до 32 В |
| Узел SW (вывод 8) | измерить положительный выброс и отрицательный звон | absolute maximum ST1S14: −1 В…VIN+0,3 В; это предел, а не целевой запас |
| +12V при пуске, сбросе и скачках нагрузки | без опасного выброса для U201 | рабочий VIN ST1S10 до 18 В; 20 В — абсолютный предел, не допустимый режим |

Сначала измерить пуск с ограничением тока, затем плавно изменять вход в рабочем диапазоне 21,6–25 В при нескольких нагрузках. Отдельно снять пороги включения/отключения EN2 при медленном изменении входа. 15,9 В — результат идеального делителя и уровня 1,5 В, а не гарантированный UVLO; ток EN2 и допуски влияют на порог. Записать напряжение EN2, вход, нагрузку и температуру. Источник параметров: [ST1S14 Rev 3, таблица 6](https://www.st.com/resource/en/datasheet/st1s14.pdf).

Скачки нагрузки +12V: 0,2 ↔ 1,2 А, фронт около 1 мкс. Проверить оба направления, пуск и отключение нагрузки; записать просадку, выброс и время установления. Отсутствие незатухающих колебаний — необходимая проверка, но число затухающих периодов само по себе не измеряет запас по фазе. Контур с C110 820 мкФ и керамикой не рассчитан, ESR конкретного электролита не измерен. К испытаниям полной нагрузки переходить после проверки выбросов на входе U201.

Проверку ограничения/КЗ +12V выполнять отдельно контролируемой нагрузкой, после проверки штатных режимов. Ожидаемый порог ограничения ST1S14 — 3,7–5,2 А; проверить восстановление после снятия перегрузки. F104 2 А time-lag может разорвать цепь раньше — зафиксировать результат, не считать эту проверку подтверждением селективности.

Дроссель L101 (JNRH1207-220M-A): Isat 5,6 А по названию карточки Electrobase (даташит Jantek не перечитывался); сопоставить фактическую зависимость индуктивности от тока и температуру с пределом ограничения ST1S14. Одного номинального Isat недостаточно для подтверждения отсутствия насыщения.

## 3. Питание 12 В → 3,3 В (ST1S10, U201)

| Что | Ожидается | Предел |
|---|---|---|
| +3V3 | номинально 3,30 В; оценка VFB и резисторов: 3,16–3,45 В при −25…+125 °C, без отдельного учёта тока FB/динамики | целевой стендовой диапазон 3,20–3,40 В; выход за него разобрать по бюджету допусков |
| Частота SW | около 900 кГц (SYNC на GND); 700–1100 кГц по таблице при 25 °C | записать частоту и режим нагрузки |
| Пульсация | десятки мВ | до 50 мВ |

Скачки 0,1 ↔ 0,6 А и фактические импульсы ESP32 в Wi-Fi: целевая просадка до 150 мВ, без незатухающих колебаний. Проверить запуск, сброс ESP32 и снятие нагрузки при 21,6/24/25 В на входе платы. L201 2,2 мкГн даёт оценочную пульсацию тока около 1,2 А при 12 → 3,3 В / 900 кГц; проверить нагрев и форму тока, включая минимальную частоту и допуск индуктивности.

Проверить эффективную ёмкость C204–C207 с учётом DC-bias, допуска и размещения. Номинальные 22 мкФ локального конденсатора не гарантируют 22 мкФ в работе; удалённые конденсаторы учитывать вместе с индуктивностью соединений. [ST1S10 Rev 7, разделы 5.3/5.6](https://www.st.com/resource/en/datasheet/st1s10.pdf) рекомендует минимум 22 мкФ и приводит настройку LC 3,3 мкГн / 22 мкФ. Записать температуру U201 и L201 после установления режима; 90 °C корпуса — рабочий стендовой критерий, а не температура кристалла.

## 4. Измерение мощности (INA238, U102)

- Ответ по I²C на адресе 0x40; регистры INA238 отличаются от INA226 (прошивка требует правки). ADCRANGE=1: полная шкала по шунту 3,5 мОм — 11,7 А.
- Сравнить показания тока с мультиметром на постоянной нагрузке 2 А и 6 А; после этого задать поправку `power_cal_pct`. Ожидаемая погрешность без калибровки ±3–5 % (шунты 1 %).
- Напряжение VBUS при 24 В: сравнить с мультиметром, расхождение не более 1 %.

## 5. Нагреватель (Q701/Q702, Q703 CSD19531KCS)

Сначала на лампе или резисторе 24 В, не на PTC. GPIO32 → затвор Q703: размах 0 – около 11,5 В, фронты чистые. При сбросе ESP32 и при Hi-Z затвор остаётся низким. При токе 4,34 А расчёт проводимых потерь — до 0,22 Вт с запасом ×1,5 на горячее RDS(on); проверить температуру корпуса после 30 минут и держать её ниже 90 °C. Металлический фланец Q703 соединён со стоком PTC_DRAIN; на заземлённый радиатор ставить только через изоляционную прокладку. Внешний термовыключатель PTC обязателен.

PTC здесь — нагреватель. F102 `3413.0327.11` — одноразовый UST 1206, 8 А time-lag. После резистивного эквивалента измерить холодный пуск реального нагревателя: амплитуду и длительность тока, интеграл I²t, повторные включения и просадку питания. Сопоставить запись с времятоковой кривой и данными F102; одного условия «ток больше 8 А» недостаточно для вывода о перегорании.

## 6. LED-канал (LM3429, U501), около 75 Вт

Сначала эквивалент LED-нагрузки около 48 В / 1,55 А с достаточной мощностью. J501/J502/J503 параллельны: проверить полярность, соединение плюса после R502 и распределение тока между реальными LED-ветвями. Все три разъёма делят один токовый канал.

| Что | Ожидается | Проверка |
|---|---|---|
| Суммарный ток LED | около 1,55 А, 74–75 Вт при 48 В | R505=4,7 кОм, R506=620 Ом, оба 1%; записать фактический ток и температуру |
| Вход LED при 21,6–25 В | около 3,4–3,9 А среднего тока; модель пика до 4,36 А | Измерить пик и шум IS, проверить F103 6,3 А USI fast (`3413.0224.11`) |
| Ограничение IS | 215/245/275 мВ min/typ/max по TI; минимум около 5,32 А с +1% R501 | Не путать с прежним допущением 200 мВ; записать фактический порог |
| Выброс SW Q501 | зависит от паразитных индуктивностей | Короткая земля щупа, пик ниже 75 В как проектный ориентир |
| OVP без панели | около 54,6 В | Не выше 60 В для 63-вольтового электролита |
| Q501, D501, R501/R502 и L501 | новый режим 75 Вт | 30 минут при полной нагрузке, температура корпусов ниже 90 °C как стендовой критерий |
| nDIM 1 кГц / 8 бит | требуется минимум 5 отсчётов = 19,53 мкс | **Прошивка пока даёт 3 отсчёта/11,72 мкс: исправить до испытания малой яркости** |

Проверить пуск при 21,6/24/25 В, записать ток через F103 и I²t; согласование быстрого предохранителя с пуском не подтверждено. Проверить поведение без LED и при сбросе ESP32, нагрев тороида и корпуса. Подавать реальную LED-нагрузку после проверки эквивалента; токи параллельных ветвей могут различаться даже при одинаковом номинальном напряжении. Под полной нагрузкой всех узлов проверить ток питания около 8,5–8,7 А и температуру Q102/входных шунтов. Это план стендовых измерений, результаты ещё не получены.

## 7. Помпа и вентиляторы

- Помпа: ток старта и остановки ротора (предохранитель F105 1 А), SS56 гасит выброс, затвор AO3422 держит 100 кОм при сбросе.
- Вентиляторы: PWM 25 кГц с инверсией, фронты через 1 кОм; при Hi-Z GPIO вентиляторы идут на полную скорость. Ток двух вентиляторов до 0,85 А. Тахометры не подключены.

## 8. RGB-индикатор (D901, Q901–Q903)

- До включения: прозвонить купленный светодиод и убедиться, что общий вывод — анод, а порядок выводов совпадает со схемой: **1 G, 2 B, 3 общий анод, 4 R**. Если нет — менять цепи листа «Status», а не перепаивать резисторы.
- При подаче 24 В все три канала темны, пока GPIO низкие или в Hi-Z (100 кОм на базах); при сбросе ESP32 свечения нет.
- Ток каждого канала при 100 % PWM: около 4,9 мА красный и 4,4 мА зелёный/синий (падение на 2 кОм ≈ 9,8 В и 8,8 В). Если фактические Vf другие, подобрать R907–R909 (ток до 20 мА на цвет допустим, рассеяние резистора ≤ 0,125 Вт).
- PWM 1–5 кГц: нет заметного мерцания и свиста; цвета «белый» (все три) и «жёлтый» (R+G) читаются, яркости подогнаны гаммой в прошивке.
- Напряжение на анодах = +12V; при отключении шины 12 В индикатор гаснет; входное напряжение отключения измерить.

## 9. Что записать

Пики на VIN и SW обоих преобразователей, пульсацию +12V и +3V3, ток панели, температуры Q102, Q501, Q703, D501, L101, L501, U101, U201 и токи каналов RGB. Если выброс на выводе VIN 7 выше 32 В или SW у Q501 выше 75 В, сначала проверить щуп (длинная земля даёт ложные выбросы) и только потом менять плату.

Для каждого измерения сохранить ревизию платы/схемы, входное напряжение, нагрузку, температуру окружающей среды, ограничение БП, точку и способ подключения щупа. Для EN2 — пороги и гистерезис, для F102/F103 — осциллограммы пуска и расчёт I²t, для шин — пуск и скачки нагрузки в обе стороны. Итог каждого пункта: измерено / не измерено / требуется доработка. Незаполненный пункт не считается пройденным.
