nikolajevs/PCB_EU/hardware/PCB_EU_LITE/BOM_allocated.csv

Source | Shop | MPN_or_shop_SKU | Fitted | Buy_pieces | Price_per_piece_EUR_VAT | Line_EUR_VAT | References | Stock_id | Stock_left | URL | Price_date | Notes
buy | Electrobase | ABS07-32.768KHZ-7-T | 1 | 1 | 0.79 | 0.79 | Y301 |  |  | https://electrobase.lv/katalogs/kvarca-generatori-tht/resonator-ceramic-32768khz-20ppm-7pf-smd-32x15x09mm | 2026-10-23 | минимум 1, кратность 1; наличие в каталоге: Pieejams piegādātāja nol
buy | Electrobase | AO3422 | 3 | 5 | 0.26 | 1.30 | Q411 Q421 Q704 |  |  | https://electrobase.lv/katalogs/tranzistori-ar-n-veida-kanalu-smd/transistor-n-mosfet-unipolar-55v-17a-800mw-sot23 | 2026-10-23 | минимум 5, кратность 5; наличие в каталоге: Pieejams piegādātāja nol
buy | Electrobase | C1206C100J5GACTU | 2 | 2 | 0.25 | 0.50 | C301 C302 |  |  | https://electrobase.lv/katalogs/kondensatori-mlcc-smd-0201/capacitor-ceramic-mlcc-10pf-50vdc-c0g-5-smd-1206 | 2026-10-23 | минимум 1, кратность 1; наличие в каталоге: >1000
buy | Electrobase | ESP32-WROOM-32E-N4 | 1 | 1 | 7.48 | 7.48 | U202 |  |  | https://electrobase.lv/katalogs/moduli-iot-wifi-bluetooth-lora/module-iot-bluetooth-low-energywifi-smd-0 | 2026-10-23 | минимум 1, кратность 1; наличие в каталоге: Pieejams piegādātāja nol
buy | Electrobase | JNRH1207-220M-A | 1 | 1 | 0.54 | 0.54 | L101 |  |  | https://electrobase.lv/katalogs/induktori-tht/inductor-wire-smd-22uh-ioper-54a-r-525o-30-isat-56a | 2026-10-23 | минимум 1, кратность 1; наличие в каталоге: В наличии
buy | Electrobase | LM3429MH/NOPB | 1 | 1 | 4.86 | 4.86 | U501 |  |  | https://electrobase.lv/katalogs/led-draiveri/ic-driver-boostbuck-boost-led-driver-htssop14-5a-372v-ch-1 | 2026-10-23 | минимум 1, кратность 1; наличие в каталоге: Pieejams piegādātāja nol
buy | Electrobase | MCP7940N-I/SN | 1 | 1 | 1.5 | 1.50 | U301 |  |  | https://electrobase.lv/katalogs/rtc-shemas/ic-rtc-circuit-i2c-sram-64bsram-1855vdc-so8-4085degc-tube-0 | 2026-10-23 | минимум 1, кратность 1; наличие в каталоге: Pieejams piegādātāja nol
buy | Electrobase | MEM2061-01-188-00-A | 1 | 1 | 1.74 | 1.74 | J301 |  |  | https://electrobase.lv/katalogs/savienojumi-kartem/connector-cards-microsd-push-push-smt-gold-flash-pin-8-0 | 2026-10-23 | минимум 1, кратность 1; наличие в каталоге: В наличии
buy | Electrobase | OSTAPA57E2A | 1 | 1 | 0.85 | 0.85 | D901 |  |  | https://electrobase.lv/katalogs/diodes-led-tht-18mm/led-rgb-5mm-140deg-front-convex-231vdc-noof-term-4-round | 2026-10-25 | минимум 1, кратность 1; наличие в каталоге: 99 (supplier warehouse,
buy | Electrobase | SMBJ26A-E3/52 | 1 | 1 | 0.5 | 0.50 | D101 |  |  | https://electrobase.lv/katalogs/diodes-transil-smd-vienvirziena/diode-tvs-600w-289319v-143a-unidirectional-5-smbj | 2026-10-23 | минимум 1, кратность 1; наличие в каталоге: В наличии
buy | Salvats | 3403.0166.11 | 1 | 1 | 0.75 | 0.75 | F105 |  |  | https://www.salvats.lv/lv/drosinataji-smd-10x3x3mm-umt-leni/1a-umt-drosinataji-leni-250vac125vdc-101x3x3mm-smd | 2026-10-23 | минимум 1, кратность 1; наличие в каталоге: 30
buy | Salvats | 3403.0169.11 | 2 | 2 | 0.78 | 1.56 | F104 F401 |  |  | https://www.salvats.lv/lv/drosinataji-smd-10x3x3mm-umt-leni/2a-umt-drosinataji-leni-250vac125vdc-101x3x3mm-smd | 2026-10-23 | минимум 1, кратность 1; наличие в каталоге: 28
buy | Salvats | 3413.0224.11 | 1 | 1 | 0.86 | 0.86 | F103 |  |  | https://www.salvats.lv/lv/drosinataji-smd-1206-32x16x06mm/drosinatajs-smd-1206-63a-63v-fast | 2026-10-23 | минимум 1, кратность 1; наличие в каталоге: 31
buy | Salvats | 3413.0327.11 | 1 | 1 | 0.8 | 0.80 | F102 |  |  | https://www.salvats.lv/lv/drosinataji-smd-1206-32x16x06mm/drosinatajs-smd-1206-8a-63v-fast | 2026-10-23 | минимум 1, кратность 1; наличие в каталоге: 35
buy | Salvats | 3413.0330.11 | 1 | 1 | 0.75 | 0.75 | F101 |  |  | https://www.salvats.lv/lv/drosinataji-smd-1206-32x16x06mm/drosinatajs-smd-1206-15a-63v-fast | 2026-10-23 | минимум 1, кратность 1; наличие в каталоге: 31
buy | Salvats | BAT-CR2032/P | 1 | 1 | 0.75 | 0.75 |  |  |  | https://www.salvats.lv/lv/litija-baterijas/cr2032-litija-baterija-30v-o20x32mm-panasonic-442g | 2026-10-23 | минимум 1, кратность 1; наличие в каталоге: 17
buy | Salvats | BC-2001 | 1 | 1 | 0.33 | 0.33 | BT301 |  |  | https://www.salvats.lv/lv/baterijas-turetaji-1/bateriju-turetajs-metaliska-cemme-cr2032-1-baterija | 2026-10-23 | минимум 1, кратность 1; наличие в каталоге: 6
buy | Salvats | BC847B-DIO | 4 | 4 | 0.06 | 0.24 | Q701 Q901 Q902 Q903 |  |  | https://www.salvats.lv/lv/npn-tranzistori-smd/bc847b1f-smd-tranzistors-npn-50v-01a-300mhz-sot23 | 2026-10-23 | минимум 1, кратность 1; наличие в каталоге: 336
buy | Salvats | BC857B | 1 | 1 | 0.08 | 0.08 | Q702 |  |  | https://www.salvats.lv/lv/pnp-tranzistori-smd/bc857b3f-smd-tranzistors-pnp-50v-01a-hfe220475-035w-200mhz-sot23 | 2026-10-23 | минимум 1, кратность 1; наличие в каталоге: 18
buy | Salvats | BZV55C12 | 1 | 1 | 0.13 | 0.13 | D103 |  |  | https://www.salvats.lv/lv/stabilitroni-smd-bzv55/12v-stabilitrons-smd-bzv55-5-05w-minimelf | 2026-10-23 | минимум 1, кратность 1; наличие в каталоге: 18
buy | Salvats | C1206C102JCGACTU | 1 | 1 | 0.25 | 0.25 | C506 |  |  | https://www.salvats.lv/lv/kondensatori-keramiskie-smd-1206-1/1nf-1206-c0g-500v-5-smd-kondensators-1206 | 2026-10-23 | минимум 1, кратность 1; наличие в каталоге: 174
buy | Salvats | CL31C101JBCNNNC | 1 | 1 | 0.07 | 0.07 | C507 |  |  | https://www.salvats.lv/lv/kondensatori-keramiskie-smd-1206-1/100pf-1206-npo-50j-smd-kondensators-1206 | 2026-10-23 | минимум 1, кратность 1; наличие в каталоге: 857
buy | Salvats | CRCW1206620RFKTABC | 1 | 1 | 0.03 | 0.03 | R506 |  |  | https://www.salvats.lv/lv/rezistori-smd-1206-025w/620r-1206-1-smd-rezistors-1206 | 2026-10-23 | минимум 1, кратность 1; наличие в каталоге: 99
buy | Salvats | CRCW120682K0FKTABC | 1 | 1 | 0.03 | 0.03 | R101 |  |  | https://www.salvats.lv/lv/rezistori-smd-1206-025w/82k-1206-1-smd-rezistors-1206 | 2026-10-23 | минимум 1, кратность 1; наличие в каталоге: 284
buy | Salvats | CS2512-0R15-1%-HP | 1 | 1 | 0.32 | 0.32 | R502 |  |  | https://www.salvats.lv/lv/rezistori-smd-2512-1w3w/0r15-2512635x32mm-2w-1-smd-55125c-rezistors-thick-film-2512 | 2026-10-23 | минимум 1, кратность 1; наличие в каталоге: 90
buy | Salvats | CSD19531KCS | 1 | 1 | 2.95 | 2.95 | Q703 |  |  | https://www.salvats.lv/lv/100v-n-fet-tht/csd19531kcs-tranzistors-n-fet-100v-vgs2233v-20v-100a-214w-0r0073-to-220 | 2026-10-23 | минимум 1, кратность 1; наличие в каталоге: В наличии 7 шт. (снимок
buy | Salvats | LRP2512-R040-1% | 1 | 1 | 0.38 | 0.38 | R501 |  |  | https://www.salvats.lv/lv/rezistori-smd-2512-1w3w/0r04-2512635x32mm-3w-1-smd-55170c-rezistors-thick-film-2512 | 2026-10-23 | минимум 1, кратность 1; наличие в каталоге: 73
buy | Salvats | SMD1206 4K7 1% | 1 | 1 | 0.04 | 0.04 | R505 |  |  | https://www.salvats.lv/lv/rezistori-smd-1206-025w/4k7-1206-1-smd-rezistors-1206 | 2026-10-23 | минимум 1, кратность 1; наличие в каталоге: 347
buy | Salvats | SMD1206 56K 1% | 1 | 1 | 0.03 | 0.03 | R507 |  |  | https://www.salvats.lv/lv/rezistori-smd-1206-025w/56k-1206-1-smd-rezistors-1206 | 2026-10-23 | минимум 1, кратность 1; наличие в каталоге: 906
buy | Salvats | SMD1206-10K-1% | 1 | 1 | 0.03 | 0.03 | R108 |  |  | https://www.salvats.lv/lv/rezistori-smd-1206-025w/10k-1206-1-smd-rezistors-1206 | 2026-10-23 | минимум 1, кратность 1; наличие в каталоге: 486
buy | Salvats | SMD1206-33K-1% | 1 | 1 | 0.03 | 0.03 | R509 |  |  | https://www.salvats.lv/lv/rezistori-smd-1206-025w/33k-1206-1-smd-rezistors-1206 | 2026-10-23 | минимум 1, кратность 1; наличие в каталоге: 665
buy | Salvats | SMD1206-6K2-1% | 2 | 2 | 0.03 | 0.06 | R102 R508 |  |  | https://www.salvats.lv/lv/rezistori-smd-1206-025w/6k2-1206-1-smd-rezistors-1206 | 2026-10-23 | минимум 1, кратность 1; наличие в каталоге: 830
buy | Salvats | UPW1H221MPD | 2 | 2 | 0.63 | 1.26 | C101 C102 |  |  | https://www.salvats.lv/lv/kondensatori-elektrolitiskie-zemas-induktivitates-low-esr/22050v-105c-o10x16mm-20-kondensatori-zemas-induktivitates-011r-5000h-nichi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 | 2026-10-23 | минимум 1, кратность 1; наличие в каталоге: 66
buy | Salvats | USBLC6-2SC6 | 1 | 1 | 0.67 | 0.67 | U401 |  |  | https://www.salvats.lv/lv/u/usblc6-2sc6-smd-mikroshema-esd-protection-sot23-6 | 2026-10-23 | минимум 1, кратность 1; наличие в каталоге: В наличии
buy | Salvats | ZL201-10G | 1 | 1 | 0.16 | 0.16 | J201 |  |  | https://www.salvats.lv/lv/listes-un-nuju-ligzdas/254mm-uz-pcb-10pin-stekers-1 | 2026-10-23 | минимум 1, кратность 1; наличие в каталоге: 41
stock | Склад | BSC146N10LS5 | 1 | 0 | 0 | 0.00 | Q501 | 112 | 1 |  | 2026-10-24 | MOSFET N-канальный силовой; 100 В, 44 А; PG-TDSON-8 / SuperSO8
stock | Склад | INA238AIDGSR | 1 | 0 | 0 | 0.00 | U102 | 114 | 0 |  | 2026-10-24 | Монитор тока/напряжения/мощности; 85V, 16-bit, I²C; VSSOP-10 (DGS), 0.5 mm
stock | Склад | Дроссель силовой 47 мкГн, 15 А | 1 | 0 | 0 | 0.00 | L501 | 12 | 0 |  | 2026-10-24 | Дроссель силовой; 47 мкГн, 15 А; THT
stock | Склад | EEVFK1J471M | 1 | 0 | 0 | 0.00 | C508 | 13 | 0 |  | 2026-10-24 | Конденсатор электролитический SMD; 470 мкФ, 63 В; SMD Aluminum Can
stock | Склад | EEEFT1E821AP | 1 | 0 | 0 | 0.00 | C110 | 14 | 0 |  | 2026-10-24 | Конденсатор электролитический SMD; 820 мкФ, 25 В; SMD Aluminum Can, Ø10 × 10,2 мм
stock | Склад | CL32B475KCI6PJE | 6 | 0 | 0 | 0.00 | C509 C510 C511 C512 C513 C514 | 2 | 6 |  | 2026-10-24 | Конденсатор керамический SMD MLCC; 4,7 мкФ, 100 В, ±10%, X7R; 1210 (3225)
stock | Склад | SS56 | 2 | 0 | 0 | 0.00 | D102 D701 | 20 | 43 |  | 2026-10-24 | Диод Шоттки SMD; 60 В, 5 А; SMC (DO-214AB)
stock | Склад | CL21A475KAQNNNG | 1 | 0 | 0 | 0.00 | C504 | 21 | 16 |  | 2026-10-24 | Конденсатор керамический SMD MLCC; 4,7 мкФ, 25 В, ±10%, X5R; 0805 (2012)
stock | Склад | RC0603J10K | 1 | 0 | 0 | 0.00 | R516 | 25 | 12 |  | 2026-10-24 | Резистор SMD; 10 кОм, ±5%, 0,1 Вт; 0603 (1608)
stock | Склад | ST1S14PHR | 1 | 0 | 0 | 0.00 | U101 | 26 | 2 |  | 2026-10-24 | DC/DC преобразователь понижающий (Buck); 5,5–48 В, 3 А, 850 кГц; PowerSO-8 / HSOP8, exposed pad
stock | Склад | ST1S10PHR | 1 | 0 | 0 | 0.00 | U201 | 27 | 3 |  | 2026-10-24 | Step-Down; регулируемый выход от 1,22 В; встроенный N-MOSFET; Power Good; Soft Start; защита по току; 2,5–18 В, 3 А, 900 кГц; PowerSO-8 / SOIC-8-EP
stock | Склад | 12065C225KATM-HW | 1 | 0 | 0 | 0.00 | C105 | 3 | 8 |  | 2026-10-24 | Конденсатор керамический SMD MLCC; 2,2 мкФ, 50 В, ±10%, X7R; 1206 (3216)
stock | Склад | SRN2512-2R2M | 1 | 0 | 0 | 0.00 | L201 | 31 | 1 |  | 2026-10-24 | Дроссель силовой SMD; 2,2 мкГн, ±20%, 2,3 А; 1008 (2520), 2,5 × 2,0 × 1,2 мм
stock | Склад | Резистор SMD 5,1 кОм, ±5% | 1 | 0 | 0 | 0.00 | R515 | 39 | 4 |  | 2026-10-24 | Резистор SMD; 5,1 кОм, ±5%; 1206 (3216)
stock | Склад | Резистор SMD 10 Ом, ±5% | 2 | 0 | 0 | 0.00 | R512 R513 | 41 | 3 |  | 2026-10-24 | Резистор SMD; 10 Ом, ±5%; 1206 (3216)
stock | Склад | CL32B106KBJNNNE | 4 | 0 | 0 | 0.00 | C103 C104 C501 C502 | 47 | 2 |  | 2026-10-24 | Конденсатор керамический SMD MLCC; 10 мкФ, 50 В, ±10%, X7R; 1210 (3225)
stock | Склад | KAF21KR72A104KL | 1 | 0 | 0 | 0.00 | C515 | 5 | 24 |  | 2026-10-24 | Конденсатор керамический SMD MLCC; 100 нФ, 100 В, ±10%, X7R; 0805 (2012)
stock | Склад | Резистор SMD 2 кОм, ±5% | 5 | 0 | 0 | 0.00 | R703 R706 R907 R908 R909 | 51 | 1 |  | 2026-10-24 | Резистор SMD; 2 кОм, ±5%; 1206 (3216)
stock | Склад | MSMA1206R0070FCM | 2 | 0 | 0 | 0.00 | R111 R112 | 52 | 2 |  | 2026-10-24 | Резистор-шунт SMD; 0,007 Ом (7 мОм), ±1%, 1 Вт; 1206 (3216)
stock | Склад | CL10B104KB8NNNC | 11 | 0 | 0 | 0.00 | C115 C107 C106 C112 C202 C208 C303 C305 C401 C403 C503 | 54 | 12 |  | 2026-10-24 | Конденсатор керамический SMD MLCC; 100 нФ, 50 В, ±10%, X7R; 0603 (1608)
stock | Склад | RC0603FR-07100KL | 6 | 0 | 0 | 0.00 | R201 R203 R412 R422 R514 R708 | 55 | 8 |  | 2026-10-24 | Резистор SMD; 100 кОм, ±1%, 0,1 Вт; 0603 (1608)
stock | Склад | CL21A225KOFNNNE | 2 | 0 | 0 | 0.00 | C203 C209 | 57 | 16 |  | 2026-10-24 | Конденсатор керамический SMD MLCC; 2,2 мкФ, 16 В, ±10%, X5R; 0805 (2012)
stock | Склад | Резистор SMD 10 кОм, ±1% | 2 | 0 | 0 | 0.00 | R103 R510 | 59 | 17 |  | 2026-10-24 | Резистор SMD; 10 кОм, ±1%; 0805 (2012)
stock | Склад | CL32A106KLULNNE | 2 | 0 | 0 | 0.00 | C111 C201 | 6 | 6 |  | 2026-10-24 | Конденсатор керамический SMD MLCC; 10 мкФ, 35 В, ±10%, X5R; 1210 (3225)
stock | Склад | Резистор SMD 47 кОм, ±1% | 2 | 0 | 0 | 0.00 | R107 R202 | 61 | 4 |  | 2026-10-24 | Резистор SMD; 47 кОм, ±1%; 1206 (3216)
stock | Склад | RC0603FR-071KL | 7 | 0 | 0 | 0.00 | R403 R411 R421 R503 R504 R511 R707 | 62 | 7 |  | 2026-10-24 | Резистор SMD; 1 кОм, ±1%, 0,1 Вт; 0603 (1608)
stock | Склад | CL21A226KPCLRNC | 6 | 0 | 0 | 0.00 | C204 C205 C206 C207 C304 C505 | 7 | 3 |  | 2026-10-24 | Конденсатор керамический SMD MLCC; 22 мкФ, 10 В, ±10%, X5R; 0805 (2012)
stock | Склад | Резистор SMD 10 кОм, ±5% | 12 | 0 | 0 | 0.00 | R204 R205 R206 R207 R303 R304 R305 R306 R307 R404 R701 R704 | 70 | 73 |  | 2026-10-24 | Резистор SMD; 10 кОм, ±5%; 0805 (2012)
stock | Склад | Резистор SMD 100 Ом, ±5% | 5 | 0 | 0 | 0.00 | R301 R302 R401 R402 R705 | 71 | 80 |  | 2026-10-24 | Резистор SMD; 100 Ом, ±5%; 0805 (2012)
stock | Склад | Резистор SMD 4,7 кОм, ±5% | 6 | 0 | 0 | 0.00 | R308 R309 R702 R901 R902 R903 | 72 | 79 |  | 2026-10-24 | Резистор SMD; 4,7 кОм, ±5%; 0805 (2012)
stock | Склад | Резистор SMD 100 кОм, ±5% | 3 | 0 | 0 | 0.00 | R904 R905 R906 | 73 | 82 |  | 2026-10-24 | Резистор SMD; 100 кОм, ±5%; 0805 (2012)
stock | Склад | Резистор SMD 150 кОм, ±5% | 3 | 0 | 0 | 0.00 | R104 R105 R106 | 74 | 82 |  | 2026-10-24 | Резистор SMD; 150 кОм, ±5%; 0805 (2012)
stock | Склад | IRL2505 | 1 | 0 | 0 | 0.00 | Q102 | 78 | 0 |  | 2026-10-24 | MOSFET N-канальный THT; 55 В, 104 А; TO-220AB (THT)
stock | Склад | SBRT15U100SP5 | 1 | 0 | 0 | 0.00 | D501 | 8 | 4 |  | 2026-10-24 | Диод SBR выпрямительный; 100 В, 15 А; PowerDI-5
stock | Склад | KF2510 / KF2540 4P | 2 | 0 | 0 | 0.00 | J411 J421 | 87 | 7 |  | 2026-10-24 | Разъём KF2510 4-контактный Male/Female; 4 контакта, шаг 2,54 мм; Wire-to-Board / 4P
stock | Склад | XH2.54-4P Right Angle | 1 | 0 | 0 | 0.00 | J401 | 90 | 59 |  | 2026-10-24 | Разъём XH2.54 угловой 4-контактный; 4 контакта, шаг 2,54 мм; THT, угловой 90°, 4P
stock | Склад | KF301-5.0-2P | 7 | 0 | 0 | 0.00 | J101 J403 J501 J502 J503 J701 J702 | 93 | 24 |  | 2026-10-24 | Клеммник винтовой PCB 2-контактный; 2 контакта, шаг 5,0 мм; THT, 2P
stock | Склад | 6X6X10MM Tact Switch | 2 | 0 | 0 | 0.00 | SW201 SW202 | 95 | 13 |  | 2026-10-24 | Тактовая кнопка Tact Switch 6×6×10 мм; SPST-NO, моментальная; THT / DIP, 4 Pin, 6×6×10 мм
