nikolajevs/PCB_EU/hardware/PCB_EU/BOM_allocated.csv

Shop | MPN_or_shop_SKU | Fitted_or_accessory | Buy_pieces | Sale_unit | Price_per_sale_unit_EUR_VAT | Line_EUR_VAT | References | Accessory_count | URL | Price_date | On_hand_allocated_pieces | Confirmation_date | Notes
Electrobase | ESP32-WROOM-32E-N4 | 1 | 1 | шт. | 7.48 | 7.48 | U202 | 0 | https://electrobase.lv/katalogs/moduli-iot-wifi-bluetooth-lora/module-iot-bluetooth-low-energywifi-smd-0 | 2026-10-20 | 0 |  | Wi-Fi, UART, MCU; flash 4 МБ проверить сборкой
Electrobase | LM3429MH/NOPB | 2 | 2 | шт. | 4.86 | 9.72 | U501 U601 | 0 | https://electrobase.lv/katalogs/led-draiveri/ic-driver-boostbuck-boost-led-driver-htssop14-5a-372v-ch-1 | 2026-10-20 | 0 |  | Boost-контроллеры, HTSSOP-14 с тепловой площадкой
Salvats | TK22E10N1 | 1 | 1 | шт. | 1.38 | 1.38 | Q501 | 0 | https://www.salvats.lv/lv/100v-n-fet-tht/22e10n-tranzistors-n-fet-100v-20v-22a-72w-0r0115-to-220 | 2026-10-23 | 0 |  | Toshiba, 100 В, 13,8 мОм, Qg 28 нКл, TO-220 G-D-S; Q501 от GATE LM3429 через 4,7 Ом (Q601 с 23.10.2026 на CSD19534KCS)
Electrobase | CSD19534KCS | 1 | 1 | шт. | 3.09 | 3.09 | Q601 | 0 | https://electrobase.lv/katalogs/tranzistori-ar-n-veida-kanalu-tht/transistor-n-mosfet-unipolar-100v-100a-118w-to220-3 | 2026-10-23 | 0 |  | TI NexFET, 100 В, 13,7 мОм тип. (16,5 макс.) при 10 В, Qg 17,1 нКл, TO-220 G-D-S; Q601 от GATE LM3429 через 4,7 Ом, расчётные потери ~0,37 Вт вместо ~0,65 Вт; у поставщика Electrobase 91 шт. на 23.10.2026
Electrobase | JNRH1207-100N-A | 2 | 2 | шт. | 0.54 | 1.08 | L501 L502 | 0 | https://electrobase.lv/katalogs/induktori-tht/inductor-wire-smd-10uh-ioper-66a-r-355mo-30-isat-8a | 2026-10-20 | 0 |  | Только CH1: два по 10 мкГн последовательно, 20 мкГн; холодный DCR пары ≤71 мОм
Electrobase | SS8PH10-M3/86A | 2 | 2 | шт. | 0.59 | 1.18 | D501 D601 | 0 | https://electrobase.lv/katalogs/diodes-schottky-smd/diode-schottky-rectifying-smpcto277a-smd-100v-8a | 2026-10-23 | 0 |  | Vishay eSMP, 100 В / 8 А, TO-277A (SMPC), Tj до 175 °C: только выпрямители двух LED-boost (D501, D601). Посадка и выводы анод–катод–анод те же, что у SS5P10: рекомендованные площадки в обоих даташитах совпадают; у поставщика больше 1000 шт. на 23.10.2026
Salvats | CS2512-0R15-1%-HP | 1 | 1 | шт. | 0.32 | 0.32 | R502 | 0 | https://www.salvats.lv/lv/rezistori-smd-2512-1w3w/0r15-2512635x32mm-2w-1-smd-55125c-rezistors-thick-film-2512 | 2026-10-20 | 0 |  | LED sense CH1 0,15 Ом, 2 Вт, 1%
Salvats | CS2512-0R47-1%-HP | 1 | 1 | шт. | 0.52 | 0.52 | R602 | 0 | https://www.salvats.lv/lv/rezistori-smd-2512-1w3w/0r47-2512635x32mm-2w-1-smd-55125c-rezistors-thick-film-2512 | 2026-10-20 | 0 |  | LED sense CH2 0,47 Ом, 2 Вт, 1%
Salvats | LRP2512-R040-1% | 1 | 1 | шт. | 0.38 | 0.38 | R501 | 0 | https://www.salvats.lv/lv/rezistori-smd-2512-1w3w/0r04-2512635x32mm-3w-1-smd-55170c-rezistors-thick-film-2512 | 2026-10-20 | 0 |  | IS только CH1: 0,04 Ом / 3 Вт / 1%
Salvats | EEUFR1J101LB | 5 | 5 | шт. | 0.6 | 3.00 | C508 C509 C510 C608 C609 | 0 | https://www.salvats.lv/lv/kondensatori-elektrolitiskie-zemas-induktivitates-low-esr/10063v-105c-o8x16mm-20-kondensatori-zemas-induktivitates-8000h-panasonic-a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 | 2026-10-20 | 0 |  | 100 мкФ / 63 В: 3 на CH1, 2 на CH2; только при новом OVP около 54,6 В
Salvats | CL31B335KOHNNNE | 2 | 2 | шт. | 0.08 | 0.16 | C504 C604 | 0 | https://www.salvats.lv/lv/kondensatori-keramiskie-smd-1206-1/33mkf-1206-x7r-16v-z-smd-kondensators-1206 | 2026-10-20 | 0 |  | 3,3 мкФ X7R, VCC LM3429; проверить ёмкость под смещением
Salvats | C1206C102JCGACTU | 2 | 2 | шт. | 0.25 | 0.50 | C506 C606 | 0 | https://www.salvats.lv/lv/kondensatori-keramiskie-smd-1206-1/1nf-1206-c0g-500v-5-smd-kondensators-1206 | 2026-10-20 | 0 |  | 1 нФ C0G ±5%, таймеры LM3429
Salvats | CL31C101JBCNNNC | 2 | 2 | шт. | 0.07 | 0.14 | C507 C607 | 0 | https://www.salvats.lv/lv/kondensatori-keramiskie-smd-1206-1/100pf-1206-npo-50j-smd-kondensators-1206 | 2026-10-20 | 0 |  | 100 пФ C0G: фильтр каждого OVP; в этой версии не COMP
Salvats | EEUFR1E102 | 1 | 1 | шт. | 0.84 | 0.84 | C112 | 0 | https://www.salvats.lv/lv/kondensatori-elektrolitiskie-zemas-induktivitates-low-esr/100025v-105c-o10x20mm-20-kondensatori-zemas-induktivitates-10000h-panasoni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 | 2026-10-20 | 0 |  | Cout 12 В: 1000 мкФ / 25 В; ESR задаётся также последовательными 0,1 Ом для Type II
Salvats | SMD1206-0R1 | 1 | 1 | шт. | 0.07 | 0.07 | R101 | 0 | https://www.salvats.lv/lv/rezistori-smd-1206-025w/0r1-1206-5-smd-rezistors-1206 | 2026-10-20 | 0 |  | 0,1 Ом последовательно с Cout 12 В; демпфирование и ESR-zero для Type II L7987
Salvats | UPW1H221MPD | 6 | 6 | шт. | 0.63 | 3.78 | C101 C102 C501 C502 C601 C602 | 0 | https://www.salvats.lv/lv/kondensatori-elektrolitiskie-zemas-induktivitates-low-esr/22050v-105c-o10x16mm-20-kondensatori-zemas-induktivitates-011r-5000h-nichi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 | 2026-10-20 | 0 |  | 220 мкФ / 50 В: по 2 у LED, 1 у buck, 1 входной
Electrobase | AP63203WU-7 | 1 | 1 | шт. | 1.24 | 1.24 | U201 | 0 | https://electrobase.lv/katalogs/sprieguma-reguletaji-dcdc-shemas/pmic-dcdc-converter-uin-3832vdc-uout-33vdc-2a-tsot26-smd | 2026-10-20 | 0 |  | Питание только от 12 В, TSOT26
Electrobase | SRN6045-6R8Y | 1 | 1 | шт. | 0.28 | 0.28 | L201 | 0 | https://electrobase.lv/katalogs/induktori-tht/inductor-wire-smd-68uh-ioper-28a-r-473mo-30-6x6x45mm | 2026-10-20 | 0 |  | 6,8 мкГн; оценка под нагрузку логики до 1 А, петлю проверить
Salvats | CL31A106KAHNNNE | 2 | 2 | шт. | 0.22 | 0.44 | C201 C202 | 0 | https://www.salvats.lv/lv/kondensatori-keramiskie-smd-1206-1/10mkf-1206-x5r-25v-k-10-smd-kondensators-1206 | 2026-10-20 | 0 |  | 10 мкФ / 25 В: 2 на входе AP63203
Salvats | CL31A226KQHNNNE | 6 | 6 | шт. | 0.18 | 1.08 | C204 C205 C206 C304 C505 C605 | 0 | https://www.salvats.lv/lv/kondensatori-keramiskie-smd-1206-1/22mkf-1206-x5r-63v-k-smd-kondensators-1206 | 2026-10-20 | 0 |  | 22 мкФ / 6,3 В: 2 у AP63203, по 1 у ESP32/SD, по 1 COMP обоих LM3429
Salvats | CL21B104KBCNNNC | 13 | 20 | уп. 10 шт. | 0.51 | 1.02 | C107 C108 C115 C203 C207 C303 C305 C401 C402 C403 C503 C603 C803 | 0 | https://www.salvats.lv/lv/kondensatori-keramiskie-smd-0805/100nf-50v-0805-10gab-mlcc-x7r-5-smd-kondensators-0805 | 2026-10-20 | 0 |  | 13 байпасных/фильтрующих конденсаторов в схеме (вкл. VS INA226), покупка 20, остаток 7
Salvats | FDB5800 | 2 | 2 | шт. | 1.98 | 3.96 | Q102 Q703 | 0 | https://www.salvats.lv/lv/n-kanalu-lauku-tranzistori-smd/fdb5800-smd-tranzistors-n-fet-loglev125v-60v-20v-80a-242w-0r006-to-263 | 2026-10-23 | 0 |  | onsemi, 60 В, 6 мОм при 10 В, Vgs ±20 В, D2PAK: Q703 ключ PTC (затвор от 12 В) и Q102 защита от переполюсовки в минусе входа; на складе Salvats 4 шт. на 23.10.2026
Electrobase | INA226AIDGSR | 1 | 1 | шт. | 3.94 | 3.94 | U102 | 0 | https://electrobase.lv/katalogs/operacijas-pastiprinataji-smd/ic-instrumentation-amplifier-2755vdc-vssop10-reeltape-0 | 2026-10-21 | 0 | 2026-10-24 | TI INA226, VSSOP-10: ток, напряжение и мощность всей платы по I2C (0x40). Продажа поштучно подтверждена Игорем 24.10.2026, купить 1 шт. Цена от 21.10.2026; текущий остаток не уточнялся
Salvats | SMD2512-0R01-1%-3W | 2 | 2 | шт. | 0.24 | 0.48 | R111 R112 | 0 | https://www.salvats.lv/lv/rezistori-smd-2512-1w3w/0r01-2512635x32mm-3w-1-smd-55170c-rezistors-thick-film-2512 | 2026-10-21 | 0 |  | 0R01 2512 3 Вт 1%: R111||R112 = 5 мОм, шунт INA226 в обратном проводе
Salvats | BZV55-C33 | 1 | 1 | шт. | 0.13 | 0.13 | D103 | 0 | https://www.salvats.lv/lv/stabilitroni-smd-bzv55/33v-stabilitrons-smd-bzv55-5-05w-minimelf-1 | 2026-10-21 | 0 |  | Стабилитрон 33 В 0,5 Вт MiniMELF: D103 защищает вход VBUS INA226 (предел 40 В) при срабатывании D101
Salvats | BC847B-DIO | 1 | 1 | шт. | 0.06 | 0.06 | Q701 | 0 | https://www.salvats.lv/lv/npn-tranzistori-smd/bc847b1f-smd-tranzistors-npn-50v-01a-300mhz-sot23 | 2026-10-20 | 0 |  | NPN в драйвере затвора PTC
Salvats | BC857B | 1 | 1 | шт. | 0.08 | 0.08 | Q702 | 0 | https://www.salvats.lv/lv/pnp-tranzistori-smd/bc857b3f-smd-tranzistors-pnp-50v-01a-hfe220475-035w-200mhz-sot23 | 2026-10-20 | 0 |  | PNP в драйвере затвора PTC
Electrobase | AO3422 | 3 | 5 | шт. | 0.26 | 1.30 | Q411 Q421 Q704 | 0 | https://electrobase.lv/katalogs/tranzistori-ar-n-veida-kanalu-smd/transistor-n-mosfet-unipolar-55v-17a-800mw-sot23 | 2026-10-20 | 0 |  | 1 ключ помпы + 2 выхода open-drain PWM; покупка 5 шт.
Electrobase | MCP7940N-I/SN | 1 | 1 | шт. | 1.5 | 1.50 | U301 | 0 | https://electrobase.lv/katalogs/rtc-shemas/ic-rtc-circuit-i2c-sram-64bsram-1855vdc-so8-4085degc-tube-0 | 2026-10-20 | 0 |  | SO-8, отдельный VBAT, I²C
Electrobase | ABS07-32.768KHZ-7-T | 1 | 1 | шт. | 0.79 | 0.79 | Y301 | 0 | https://electrobase.lv/katalogs/kvarca-generatori-tht/resonator-ceramic-32768khz-20ppm-7pf-smd-32x15x09mm | 2026-10-20 | 0 |  | Кварц 32,768 кГц, CL 7 пФ
Electrobase | C1206C100J5GACTU | 2 | 2 | шт. | 0.25 | 0.50 | C301 C302 | 0 | https://electrobase.lv/katalogs/kondensatori-mlcc-smd-0201/capacitor-ceramic-mlcc-10pf-50vdc-c0g-5-smd-1206 | 2026-10-23 | 0 |  | KEMET, 10 пФ / 50 В / C0G / ±5%, 1206: нагрузка кварца Y301 (RTC_X1, RTC_X2), подобрать на плате. Карточка Salvats для C1206C100J5GAC называет Y5V, поэтому покупка у Electrobase; TU — суффикс упаковки (лента); у поставщика >1000 шт. на 23.10.2026
Salvats | BC-2001 | 1 | 1 | шт. | 0.33 | 0.33 | BT301 | 0 | https://www.salvats.lv/lv/baterijas-turetaji-1/bateriju-turetajs-metaliska-cemme-cr2032-1-baterija | 2026-10-20 | 0 |  | Держатель CR2032; посадка сверена с чертежом COMF. Остались физическая примерка, контакт батарейки и доступ для её замены
Salvats | BAT-CR2032/P | 1 | 1 | шт. | 0.75 | 0.75 |  | 1 | https://www.salvats.lv/lv/litija-baterijas/cr2032-litija-baterija-30v-o20x32mm-panasonic-442g | 2026-10-20 | 0 |  | Panasonic CR2032, зарядка отсутствует
Electrobase | MEM2061-01-188-00-A | 1 | 1 | шт. | 1.74 | 1.74 | J301 | 0 | https://electrobase.lv/katalogs/savienojumi-kartem/connector-cards-microsd-push-push-smt-gold-flash-pin-8-0 | 2026-10-20 | 0 |  | GCT microSD push-push; посадка сверена с чертежом GCT. Остались физическая примерка, доступность пайки и извлечения карты
Electrobase | SMBJ26A-E3/52 | 1 | 1 | шт. | 0.5 | 0.50 | D101 | 0 | https://electrobase.lv/katalogs/diodes-transil-smd-vienvirziena/diode-tvs-600w-289319v-143a-unidirectional-5-smbj | 2026-10-20 | 0 |  | Входной TVS 26 В, после главного предохранителя
Salvats | 3413.0330.11 | 1 | 1 | шт. | 0.75 | 0.75 | F101 | 0 | https://www.salvats.lv/lv/drosinataji-smd-1206-32x16x06mm/drosinatajs-smd-1206-15a-63v-fast | 2026-10-20 | 0 |  | SCHURTER UST 1206, 15 А / 63 В DC, медленный, главный
Salvats | 3413.0327.11 | 1 | 1 | шт. | 0.8 | 0.80 | F102 | 0 | https://www.salvats.lv/lv/drosinataji-smd-1206-32x16x06mm/drosinatajs-smd-1206-8a-63v-fast | 2026-10-20 | 0 |  | SCHURTER UST 1206, 8 А / 63 В DC, медленный, PTC
Salvats | 3413.0224.11 | 1 | 1 | шт. | 0.86 | 0.86 | F103 | 0 | https://www.salvats.lv/lv/drosinataji-smd-1206-32x16x06mm/drosinatajs-smd-1206-63a-63v-fast | 2026-10-20 | 0 |  | SCHURTER USI 1206, 6,3 А / 63 В DC, быстрый, вход LED CH1
Salvats | 3403.0169.11 | 3 | 3 | шт. | 0.78 | 2.34 | F104 F105 F401 | 0 | https://www.salvats.lv/lv/drosinataji-smd-10x3x3mm-umt-leni/2a-umt-drosinataji-leni-250vac125vdc-101x3x3mm-smd | 2026-10-20 | 0 |  | SCHURTER UMT 250, 2 А / 125 В DC, медленный: вход LED CH2, buck и вентиляторы
Salvats | 3403.0166.11 | 1 | 1 | шт. | 0.75 | 0.75 | F106 | 0 | https://www.salvats.lv/lv/drosinataji-smd-10x3x3mm-umt-leni/1a-umt-drosinataji-leni-250vac125vdc-101x3x3mm-smd | 2026-10-20 | 0 |  | SCHURTER UMT 250, 1 А / 125 В DC, медленный: помпа
Salvats | USBLC6-2SC6 | 2 | 2 | шт. | 0.67 | 1.34 | U401 U402 | 0 | https://www.salvats.lv/lv/u/usblc6-2sc6-smd-mikroshema-esd-protection-sot23-6 | 2026-10-20 | 0 |  | ESD I²C и float, правильное питание защитной сборки от 3,3 В
Salvats | ESDA6V1L | 2 | 2 | шт. | 0.26 | 0.52 | D411 D421 | 0 | https://www.salvats.lv/lv/supresori-smd-p6/esda6v1lel61-smd-diode-transil-61v-300w-double-common-anode-sot23 | 2026-10-20 | 0 |  | Fan PWM/тахо, в дополнение к последовательным резисторам
Salvats | DG301R-5.0-2P12 | 1 | 1 | шт. | 0.35 | 0.35 | J101 | 0 | https://www.salvats.lv/lv/solis-508mm-1/terminal-blocks-pcb-ar-skruvem-2pin-5mm-25mm2-300v16a-10x76x10mm-taisns | 2026-10-20 | 0 |  | Вход 24 В J101 (1 шт., 2,5 мм², 16 А). С 22.10.2026 клемма PTC J701 на DG306; вторая штука убрана из покупки 23.10.2026 по решению Игоря (к покупке 1, запаса нет)
Salvats | DG306-5.0-2P12 | 6 | 6 | шт. | 0.32 | 1.92 | J403 J501 J601 J602 J701 J702 | 0 | https://www.salvats.lv/lv/solis-508mm-1/terminal-blocks-pcb-ar-skruvem-2pin-5mm-15mm2-250v15a-10x8x10mm | 2026-10-20 | 0 |  | PTC, помпа, LED×3, float (6 шт.). С 22.10.2026 вентиляторы на хидерах KF2510, SHT4x на разъёме XH, PTC на DG306 у нижнего края; 5 лишних штук убраны из покупки 23.10.2026 по решению Игоря (к покупке 6, запаса нет)
Есть дома | KF2510-4A | 2 | 0 | шт. | 0.0 | 0.00 | J411 J421 | 0 |  |  | 2 | 2026-10-24 | Прямой хидер 4 контакта 2,54 мм для J411/J421. Есть дома, подтверждено Игорем 24.10.2026; 2 шт. выделены на плату, покупать не нужно. Сверить фактическую деталь с посадкой Molex KK-254 и порядок проводов вентиляторов
Есть дома | XH2.54-4P-90 | 1 | 0 | шт. | 0.0 | 0.00 | J401 | 0 |  |  | 1 | 2026-10-24 | Угловой хидер XH 4 контакта для SHT4x, J401. Есть дома, подтверждено Игорем 24.10.2026; 1 шт. выделена на плату, покупать не нужно. Сверить шаг с посадкой JST XH S4B-XH-A 2,50 мм и порядок проводов
Salvats | TACTB-64K-F | 2 | 2 | шт. | 0.35 | 0.70 | SW201 SW202 | 0 | https://www.salvats.lv/lv/taktumembranas-sledzi/mikrosledzejs-horizontals-spst-no-off-on-005a12vdc-smd-5x5x2mm-25n-l05mm | 2026-10-20 | 0 |  | BOOT и RESET
Salvats | LM2903D-ST | 1 | 1 | шт. | 0.37 | 0.37 | U802 | 0 | https://www.salvats.lv/lv/l/lm2903d-smd-mikroshema-comparator-low-power-comp-2-500ns-236v-so8 | 2026-10-20 | 0 |  | SO-8, от 12 В; VIN сравнивается с 3,3 В / 2, -40…125 °C; блокирует общий nDIM
Salvats | BAT54-DIO | 1 | 1 | шт. | 0.06 | 0.06 | D801 | 0 | https://www.salvats.lv/lv/diodes-sotki-smd-1/bat54l4-smd-diode-schottky-30v-02a-5ns-sot23 | 2026-10-20 | 0 |  | Schottky SOT23: анод к nDIM, катод к выходу компаратора
Salvats | ZL201-10G | 1 | 1 | шт. | 0.16 | 0.16 | J201 | 0 | https://www.salvats.lv/lv/listes-un-nuju-ligzdas/254mm-uz-pcb-10pin-stekers-1 | 2026-10-23 | 0 |  | Однорядная штыревая планка 2,54 мм, 10 контактов, отрезать 6 для UART J201; остаток 4 контакта; цена и остаток (41 шт.) Salvats из файла цен от 23.10.2026, карточку не открывали
Salvats | SMD1206-1K-1% | 7 | 7 | шт. | 0.03 | 0.21 | R104 R503 R504 R511 R603 R604 R611 | 0 | https://www.salvats.lv/lv/rezistori-smd-1206-025w/1k-1206-1-smd-rezistors-1206 | 2026-10-20 | 0 |  | 1%: HSP/HSN ×4, низ OVP ×2, низ FB L7987 ×1
Salvats | SMD1206-10K-1% | 6 | 6 | шт. | 0.03 | 0.18 | R110 R102 R510 R610 R813 R814 | 0 | https://www.salvats.lv/lv/rezistori-smd-1206-025w/10k-1206-1-smd-rezistors-1206 | 2026-10-20 | 0 |  | 1%: верх OVP ×2, верх FB L7987 ×1, опорный делитель UVLO ×2, gate–source Q102 ×1
Salvats | SMD1206-220R-1% | 3 | 3 | шт. | 0.03 | 0.09 | R301 R302 R705 | 0 | https://www.salvats.lv/lv/rezistori-smd-1206-025w/220r-1206-1-smd-rezistors-1206 | 2026-10-20 | 0 |  | 1206: gate PTC, SPI SCK и MOSI; на SD CS отдельного series-R нет
Salvats | SMD1206 4K7 1% | 3 | 3 | шт. | 0.04 | 0.12 | R308 R309 R702 | 0 | https://www.salvats.lv/lv/rezistori-smd-1206-025w/4k7-1206-1-smd-rezistors-1206 | 2026-10-20 | 0 |  | 1%: I2C pull-ups ×2, R702 база Q701 (держит PTC выключенным при внутренней подтяжке ESP32)
Salvats | SMD1206-100R-1% | 2 | 2 | шт. | 0.03 | 0.06 | R401 R402 | 0 | https://www.salvats.lv/lv/rezistori-smd-1206-025w/100r-1206-1-smd-rezistors-1206 | 2026-10-20 | 0 |  | Два последовательных резистора I2C к внешнему SHT4x
Salvats | SMD1206-2K2-1% | 2 | 2 | шт. | 0.03 | 0.06 | R703 R706 | 0 | https://www.salvats.lv/lv/rezistori-smd-1206-025w/2k2-1206-1-smd-rezistors-1206 | 2026-10-20 | 0 |  | База PNP и gate pull-down PTC; 1206 0,25 Вт
Salvats | SMD1206-6K2-1% | 3 | 3 | шт. | 0.03 | 0.09 | R505 R508 R608 | 0 | https://www.salvats.lv/lv/rezistori-smd-1206-025w/6k2-1206-1-smd-rezistors-1206 | 2026-10-20 | 0 |  | 1 в RCSH CH1, 2 в RCT LED
Salvats | CRCW12061K20FKTABC | 1 | 1 | шт. | 0.03 | 0.03 | R506 | 0 | https://www.salvats.lv/lv/rezistori-smd-1206-025w/1k2-1206-1-smd-rezistors-1206 | 2026-10-20 | 0 |  | RCSH CH1: 6,2 кОм + 1,2 кОм
Salvats | SMD1206 5K6 1% | 6 | 6 | шт. | 0.03 | 0.18 | R108 R109 R605 R810 R811 R816 | 0 | https://www.salvats.lv/lv/rezistori-smd-1206-025w/5k6-1206-1-smd-rezistors-1206 | 2026-10-20 | 0 |  | 1%: RCSH CH2, два плеча UVLO, series-R GPIO25 → nDIM, делитель затвора Q102 ×2
Salvats | SMD1206-82R | 1 | 1 | шт. | 0.03 | 0.03 | R606 | 0 | https://www.salvats.lv/lv/rezistori-smd-1206-025w/82r-1206-5-smd-rezistors-1206 | 2026-10-20 | 0 |  | 82 Ом, 5%, малая доля составного RCSH CH2
Salvats | SMD1206 56K 1% | 3 | 3 | шт. | 0.03 | 0.09 | R507 R607 R809 | 0 | https://www.salvats.lv/lv/rezistori-smd-1206-025w/56k-1206-1-smd-rezistors-1206 | 2026-10-20 | 0 |  | RCT: 56 кОм + 6,2 кОм, около 402 кГц при 1 нФ
Salvats | SMD1206-1M-1% | 1 | 1 | шт. | 0.03 | 0.03 | R812 | 0 | https://www.salvats.lv/lv/rezistori-smd-1206-025w/1m-1206-1-smd-rezistors-1206 | 2026-10-20 | 0 |  | Гистерезис UVLO около 0,20 В
Electrobase | L7987 | 1 | 1 | шт. | 4.09 | 4.09 | U101 | 0 | https://electrobase.lv/katalogs/sprieguma-reguletaji-dcdc-shemas/driver-dcdc-converter-uin-4561vdc-uout-0861vdc-3a-smd | 2026-10-20 | 0 |  | ST L7987, 3 А, HTSSOP-16 EP; около 434 кГц; регулируемый лимит и запуск
Electrobase | JNRH1207-330M-A | 1 | 1 | шт. | 0.54 | 0.54 | L101 | 0 | https://electrobase.lv/katalogs/induktori-tht/inductor-wire-smd-33uh-ioper-52a-r-645mo-20-isat-45a | 2026-10-20 | 0 |  | 33 мкГн ±20%, DCR ≤64,5 мОм; Isat 4,5 А тип., Irms 5,2 А
Salvats | SS510-YAN | 2 | 2 | шт. | 0.35 | 0.70 | D102 D701 | 0 | https://www.salvats.lv/lv/diodes-sotki-smd-1/ss510-smd-diode-schottky-100v-5a-686x584x213mm-smc | 2026-10-20 | 0 |  | Yangjie SS510, SMC, 100 В; buck 12 В и flyback помпы
Salvats | SMD2512-4R7 | 2 | 2 | шт. | 0.11 | 0.22 | R803 R807 | 0 | https://www.salvats.lv/lv/rezistori-smd-2512-1w3w/4r7-2512635x32mm-1w-5-smd-55125c-rezistors-thick-film-2512 | 2026-10-20 | 0 |  | 4,7 Ом / 1 Вт, 2512, 5%; R803 — затвор Q501 TK22E10N1, R807 — затвор Q601 CSD19534KCS; проверить звон и нагрев на прототипе
Salvats | CS2512-0R068-1%-HP | 1 | 1 | шт. | 0.5 | 0.50 | R601 | 0 | https://www.salvats.lv/lv/rezistori-smd-2512-1w3w/0r068-2512635x32mm-2w-1-smd-55170c-rezistors-thick-film-2512 | 2026-10-20 | 0 |  | IS CH2: 0,068 Ом / 2 Вт / 1%; статический порог около 3,13–4,08 А
Salvats | CL21B105KBFNNNG | 9 | 10 | уп. 10 шт. | 0.54 | 0.54 | C103 C104 C105 C106 C109 C110 C111 C113 C208 | 0 | https://www.salvats.lv/lv/kondensatori-keramiskie-smd-0805/1mkf-50v-0805-10gab-mlcc-x7r-10-smd-kondensators-0805 | 2026-10-20 | 0 |  | 1 мкФ / 50 В X7R 0805: 4 VCC/VIN, 2 VBIAS, 1 CF, 1 SS, 1 EN ESP32; купить пачку 10
Salvats | CC1206JRNPO9331 | 1 | 1 | шт. | 0.08 | 0.08 | C114 | 0 | https://www.salvats.lv/lv/kondensatori-keramiskie-smd-1206-1/330pf-1206-npo-50-j-smd-kondensators-1206 | 2026-10-20 | 0 |  | 330 пФ C0G / 50 В, CP цепи Type II
Salvats | SMD1206-3K9-1% | 2 | 2 | шт. | 0.03 | 0.06 | R103 R105 | 0 | https://www.salvats.lv/lv/rezistori-smd-1206-025w/3k9-1206-1-smd-rezistors-1206-1 | 2026-10-20 | 0 |  | 3,9 кОм / 1%: один верх FB (10+3,9 кОм), один RF компенсации
Salvats | SMD1206-33K-1% | 2 | 2 | шт. | 0.03 | 0.06 | R509 R609 | 0 | https://www.salvats.lv/lv/rezistori-smd-1206-025w/33k-1206-1-smd-rezistors-1206 | 2026-10-20 | 0 |  | Верх OVP каждого канала: 33+10 кОм
Salvats | SMD1206-27K-1% | 1 | 1 | шт. | 0.03 | 0.03 | R106 | 0 | https://www.salvats.lv/lv/rezistori-smd-1206-025w/27k-1206-1-smd-rezistors-1206 | 2026-10-20 | 0 |  | RILIM L7987, около 2,96 А статического пикового лимита
Salvats | SMD1206-68K | 1 | 1 | шт. | 0.03 | 0.03 | R107 | 0 | https://www.salvats.lv/lv/rezistori-smd-1206-025w/68k-1206-5-smd-rezistors-1206 | 2026-10-20 | 0 |  | RFSW 68 кОм, 5%, около 434 кГц
Electrobase | JNRH1207-220M-A | 1 | 1 | шт. | 0.54 | 0.54 | L601 | 0 | https://electrobase.lv/katalogs/induktori-tht/inductor-wire-smd-22uh-ioper-54a-r-525o-30-isat-56a | 2026-10-20 | 0 |  | Один 22 мкГн; в approval PDF допуск ±30%, DCR ≤52,5 мОм, Isat 5,6 А тип.; проверить L(I,T)
Electrobase | CL21B104KCFSFNE | 2 | 2 | шт. | 0.12 | 0.24 | C511 C611 | 0 | https://electrobase.lv/katalogs/kondensatori-mlcc-smd-0201/capacitor-ceramic-mlcc-100nf-100v-x7r-10-smd-0805-3 | 2026-10-24 | 0 |  | Samsung, 100 нФ / 100 В / X7R / ±10%, 0805: локальный HF-байпас выходов LED (C511, C611), не ёмкость COMP. Аналог KEMET C0805C104K1RACTU (его карточка стоит 0,23 EUR; прежняя ссылка -0 не открывалась); у поставщика больше 1000 шт. на 24.10.2026
Salvats | SMD0603-1K | 7 | 10 | уп. 10 шт. | 0.11 | 0.11 | R113 R403 R411 R413 R421 R423 R707 | 0 | https://www.salvats.lv/lv/rezistori-smd-0603-01w/1k-0603-18x08mm-10gab-50v-01w-5-smd-rezistors-0603-1 | 2026-10-20 | 0 |  | 1k: tach x2, float x1, pump/fan gates x3, INA226 VBUS x1; 7 of 10 purchased
Salvats | SMD0603-10K | 14 | 20 | уп. 10 шт. | 0.11 | 0.22 | R201 R202 R303 R304 R305 R306 R307 R404 R414 R424 R701 R704 R815 R817 | 0 | https://www.salvats.lv/lv/rezistori-smd-0603-01w/10k-0603-18x08mm-10gab-50v-01w-5-smd-rezistors-0603-1 | 2026-10-20 | 0 |  | EN/BOOT x2, SD CMD/DAT x5, float x1, tach x2, PTC x2, BLOCK_OC x1, nDIM x1
Salvats | SMD0603-100K | 5 | 10 | уп. 10 шт. | 0.11 | 0.11 | R412 R422 R708 R804 R808 | 0 | https://www.salvats.lv/lv/rezistori-smd-0603-01w/100k-0603-18x08mm-10gab-50v-01w-5-smd-rezistors-0603 | 2026-10-20 | 0 |  | 0603 / 5%: gate Q501/Q601 ×2, gate помпы ×1, gate fan PWM ×2
Salvats | RAD-DY-GF/3 | 1 | 1 | шт. | 0.77 | 0.77 |  | 1 | https://www.salvats.lv/lv/radiatori/radiators-30x30x15mm-88kw-to220-to247-aluminijs-melna-krasa | 2026-10-20 | 0 |  | STONECOLD RAD-DY-GF/3, 30×30×15 мм, 8,8 К/Вт по каталогу; радиатор Q501 (LED1). У Q601 (LED2) радиатора нет с 22.10.2026; второй радиатор убран из покупки 23.10.2026
Salvats | TO220-SET | 1 | 1 | шт. | 0.43 | 0.43 |  | 1 | https://www.salvats.lv/lv/izolacijas-materiali/izolacija-mica-to220-kit-mitrikis-izolejosas-tapas-kontaktu-ziedlapina-montazu-skruve-pakrute-vizla | 2026-10-20 | 0 |  | TO220-SET: нужна изолирующая втулка под головку винта Q501 (остальное из набора не используется); второй комплект убран из покупки 23.10.2026
Salvats | SMICA-TO220-2 | 1 | 1 | шт. | 0.18 | 0.18 |  | 1 | https://www.salvats.lv/lv/izolacijas-materiali/izolacija-smica-to-220-15x20x03mm-gumija-ar-izulatoru | 2026-10-20 | 0 |  | NINIGI, силиконовая прокладка со втулкой, 15×20×0,3 мм, для Q501; вторая убрана из покупки 23.10.2026
