nikolajevs/PCB_EU/hardware/PCB_EU/review/PCB_EU_assembly.step

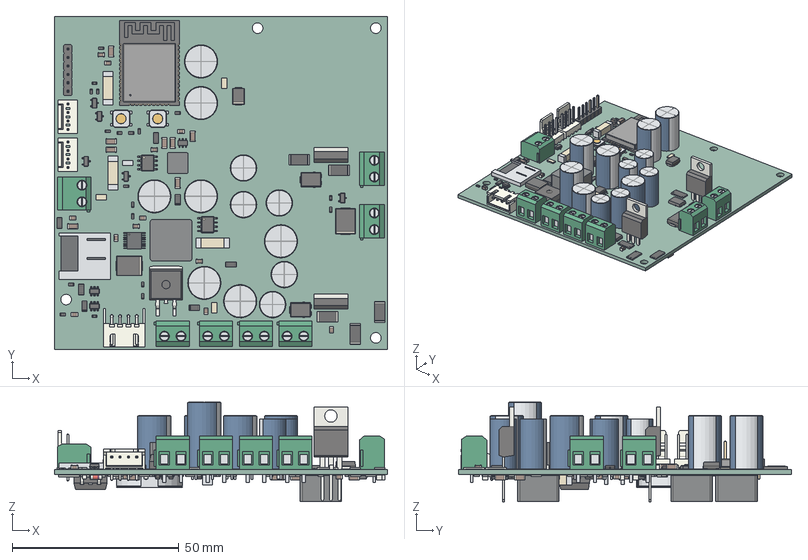
[picture p11: CAD file, 2026-10-23]
hardware/PCB_EU/review/PCB_EU_assembly.step
100.0 x 100.0 x 29.9 mm
R_0603_1608Metric x 26
coated_ferrite x 5
terminal_1 x 13
terminal_2 x 13
ceramic x 8
sleeve x 12
negative_stripe x 12
top_cap_pressure_vent x 12
lead_1 x 15
lead_2 x 15
R_2512_6332Metric x 8
slotted_screw_1 x 7
cage_1 x 7
tail_1 x 7
slotted_screw_2 x 7
cage_2 x 7
tail_2 x 7
housing x 9
C_0805_2012Metric x 24
C_1206_3216Metric x 17
R_1206_3216Metric x 45
SOIC_8_39x49mm_P127mm x 2
D_SMB
TSOT_23_6
plastic_base
stainless_shell
signal_1
contact_1
signal_2
contact_2
signal_3
contact_3
signal_4
contact_4
signal_5
contact_5
signal_6
contact_6
signal_7
contact_7
signal_8
contact_8
toe_CD1_2.05
toe_CD2_7.75
toe_SH_0.45
toe_SH_13.6
TO-220-3_Vertical x 2
seam_sealed_lid
TO_263_2 x 2
SOT_23_6 x 2
cover x 2
actuator x 2
tail_1_0 x 2
tail_1_1 x 2
tail_2_0 x 2
tail_2_1 x 2
SOT_23 x 8
JST_S4B_XH_A
D_SMC x 2
Molex_AE_6410_04A x 2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
