nikolajevs/PCB_EU/hardware/enclosure/PCB_EU_lid_print.stl

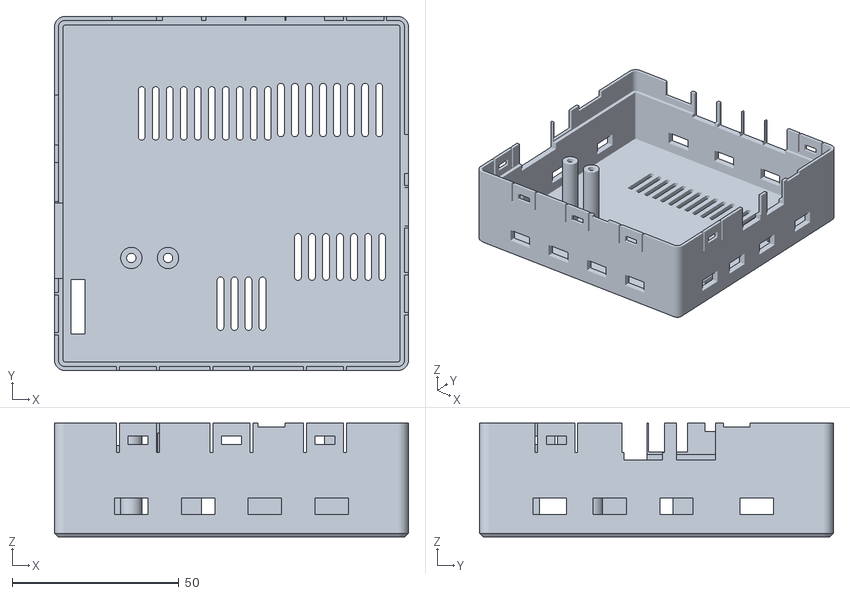
[picture p12: CAD file, 2026-10-24]
hardware/enclosure/PCB_EU_lid_print.stl
106.0 x 106.0 x 34.0
