nikolajevs/PCB_EU/hardware/stencil/PCB_EU_stencil_top_print.stl

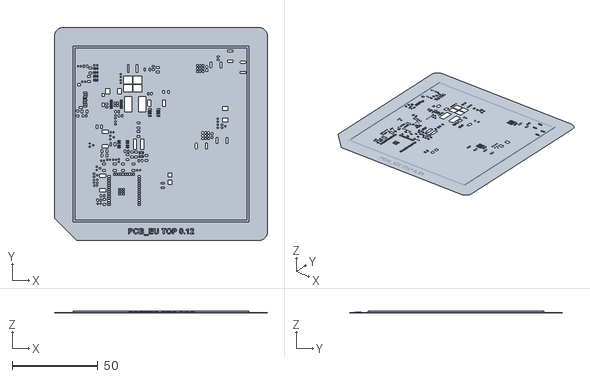
[picture p13: CAD file, 2026-10-24]
hardware/stencil/PCB_EU_stencil_top_print.stl
124.0 x 124.0 x 1.08
