nikolajevs/PCB_EU/hardware/enclosure/PCB_EU_base_coupon_print.stl

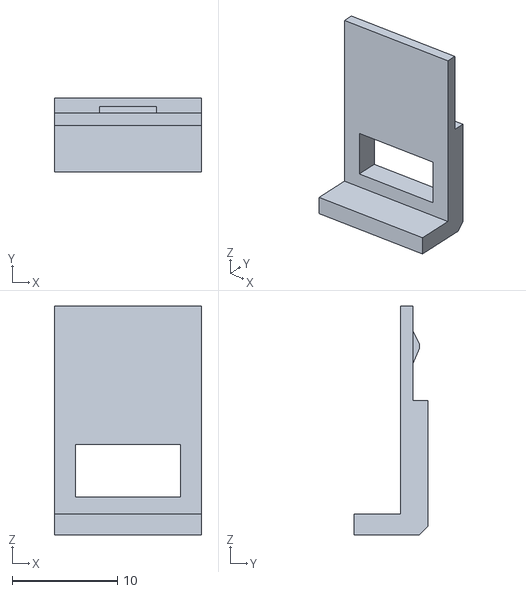
[picture p14: CAD file, 2026-10-24]
hardware/enclosure/PCB_EU_base_coupon_print.stl
14.0 x 7.00 x 21.8
