nikolajevs/PCB_EU/hardware/stencil/PCB_EU_stencil_coupon_print.stl

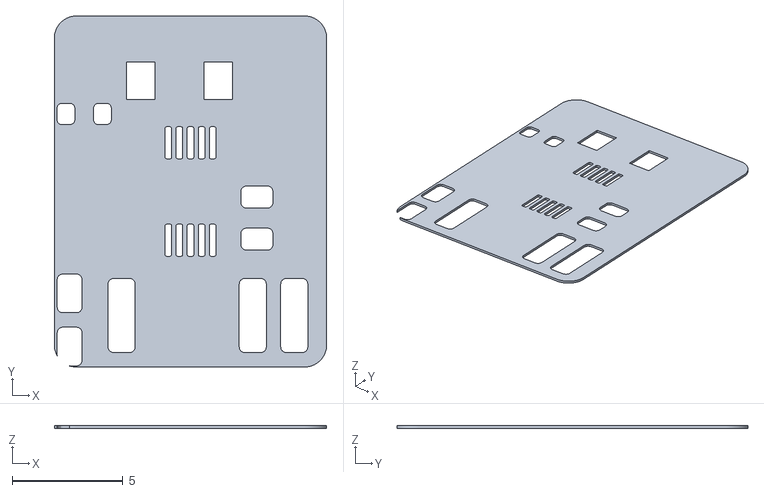
[picture p15: CAD file, 2026-10-24]
hardware/stencil/PCB_EU_stencil_coupon_print.stl
12.3 x 15.9 x 0.12
