nikolajevs/PCB_EU/hardware/enclosure/PCB_EU_base.step

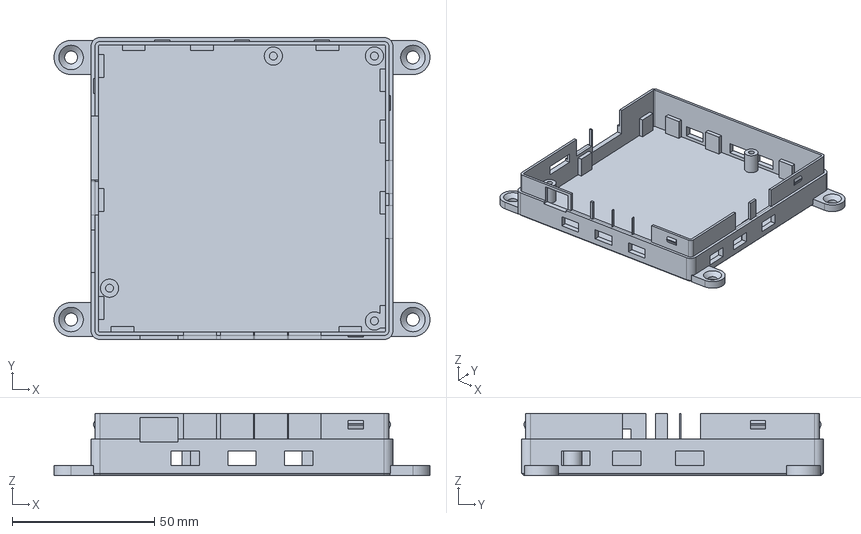
[picture p16: CAD file, 2026-10-24]
hardware/enclosure/PCB_EU_base.step
132.0 x 106.0 x 21.8 mm
