nikolajevs/PCB_EU/hardware/enclosure/PCB_EU_lid_coupon_print.stl

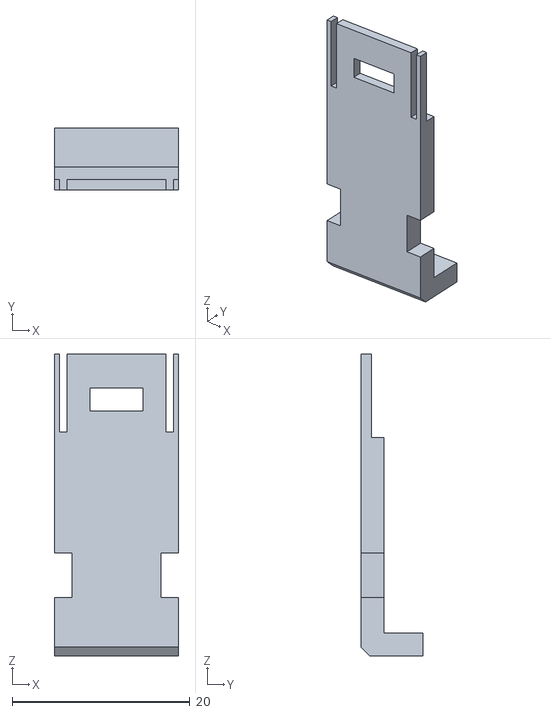
[picture p17: CAD file, 2026-10-24]
hardware/enclosure/PCB_EU_lid_coupon_print.stl
14.0 x 7.00 x 34.0
