nikolajevs/PCB_EU/(list of files, cad)

Other CAD files:
hardware/enclosure/PCB_EU_lid.step
hardware/stencil/PCB_EU_stencil_bottom_print.stl
hardware/enclosure/PCB_EU_base_print.stl
