nikolajevs/PCB_EU/hardware/PCB_EU_LITE/fabrication/2026-10-25-r1/README.md

# EU-LITE — Gerber для изготовления прототипа

**Исторический комплект — не использовать для текущей ревизии платы.** После этого выпуска исправлены входная и LED-медь, переходные и локальная земля ESP32. Проверки ниже относятся только к исходнику этого архива. Текущий статус и условия нового выпуска — в [основном README](../../README.md#проверки).

Этот архив заменён [ревизией r2 от 26.10.2026](../2026-10-26-r2/README.md):
добавлены 11 позиций шелкографии сверху. Для нового заказа использовать r2.

Архив: [PCB_EU_LITE_Gerber_37e323ee.zip](PCB_EU_LITE_Gerber_37e323ee.zip). SHA-256: `28ad4040f45c879dc50890a704a667f48f8ff3579352689da11aa59ece895439`.
Исходная плата: `37e323ee18c067d343bf57cc808ef0943046e72f90aef23b57fe0c6a87853379`; исходная ревизия: `c5e66ab1dfda293ba9aa05ab097ce98327ba95c8`.

100 × 100 мм, четыре медных слоя: F.Cu → In1.Cu → In2.Cu → B.Cu.
FR-4, номинально 1,6 мм; внешняя медь 1 oz, внутренняя 0,5 oz;
зелёная маска, белая шелкография. Сквозные переходы, маска на обеих сторонах.
В архиве отдельные PTH/NPTH Excellon в мм и абсолютные координаты;
платы не панелизированы, контролируемый импеданс не заявлен.

Проверки: свежие ERC, DRC с паритетом схемы, netlist, размещение,
съёмы INA238 Kelvin и производственная геометрия. Электрических и
геометрических DRC-проблем, неподключённых цепей и расхождений со схемой: 0.
Сохранено 35 предупреждений о библиотеке: независимо проверено,
что они относятся исключительно к печатным контурам, обрезанным возле площадок.
Правила DRC не отключались. Полные исходные отчёты находятся в `checks/`.

Gerber и Excellon повторно прочитаны независимым CAM-парсером: 4 слоя,
контур 100.10 × 100.10 мм. Обзоры CAM_top.svg/CAM_bottom.svg получены
из производственных файлов. Контрольные суммы всех файлов — в manifest.json.

Контур по осевой линии — 100 × 100 мм; размер 100,10 мм выше учитывает
штрих Edge.Cuts шириной 0,10 мм. Независимо сверены координаты и диаметры
270 металлизированных и 4 неметаллизированных отверстий с исходной платой:
максимальное округление координат — 0,000707 мм.

Визуально просмотрены оба внешних и оба внутренних слоя:
[верх](preview_top.png), [низ](preview_bottom.png),
[In1.Cu](preview_inner_1.png), [In2.Cu](preview_inner_2.png).
Повторное применение финализатора и шелкографии даёт байт-в-байт ту же плату.
Дополнительно пройдены 13 тестов с намеренными дефектами размещения и
3 проверки Kelvin, включая отбраковку прежнего замыкания на A1/GND.

Выпуск создан KiCad 10.0.5 с явным разрешением этой версии;
повторный прогон на целевой 10.0.7 не выполнялся.

Часть позиционных надписей имеет высоту 0,8 мм при штрихе 0,15 мм — абсолютный
минимум из рекомендаций JLCPCB; рекомендуемая высота 1 мм. При заказе сверить
предпросмотр шелкографии. [Источник](https://jlcpcb.com/blog/character-design-specifications).

Это первый прототип. Корпус, формовка выводов RGB, фактические разъёмы,
нагрев, минимальный PWM и прошивка INA238 требуют стендовых проверок.
Плату подключать сначала к лабораторному БП с ограничением тока;
см. ../../review/Bench_checklist.md. Это не заказ и не оплата производства.
