nikolajevs/PCB_EU/hardware/PCB_EU_LITE/fabrication/2026-10-26-r2/README.md

# EU-LITE — Gerber для изготовления прототипа

**Исторический комплект — не использовать для текущей ревизии платы.** После этого выпуска исправлены входная и LED-медь, переходные и локальная земля ESP32. Проверки ниже относятся только к исходнику этого архива. Текущий статус и условия нового выпуска — в [основном README](../../README.md#проверки).

Архив: [PCB_EU_LITE_Gerber_e93b5102.zip](PCB_EU_LITE_Gerber_e93b5102.zip). SHA-256: `699ede84605f82fde8a0b6362c9944816a6091783c6556ac265e59ab52c74b2c`.
Исходная плата: `e93b5102dc673816e15cca2e5316efc4bddce4ea7879c0f39e8fa67774bfb9fe`; исходная ревизия: `d38619325aad2aa1d2da1d00bad4c6e2e762b25e`.

Ревизия r2 от 26.10.2026 заменяет [предыдущий комплект r1](../2026-10-25-r1/README.md).
В ней добавлены ещё 11 позиционных надписей сверху: всего 125 из 163,
29 вертикальных. Нижняя сторона и все прежние надписи сохранены.
В сравнении с r1 производственная геометрия изменилась только на F.Silkscreen;
сверловка совпадает, время генерации в CAM-файлах обновлено.

100 × 100 мм, четыре медных слоя: F.Cu → In1.Cu → In2.Cu → B.Cu.
FR-4, номинально 1,6 мм; внешняя медь 1 oz, внутренняя 0,5 oz;
зелёная маска, белая шелкография. Сквозные переходы, маска на обеих сторонах.
В архиве отдельные PTH/NPTH Excellon в мм и абсолютные координаты;
платы не панелизированы, контролируемый импеданс не заявлен.

Проверки: свежие ERC, DRC с паритетом схемы, netlist, размещение,
съёмы INA238 Kelvin и производственная геометрия. Электрических и
геометрических DRC-проблем, неподключённых цепей и расхождений со схемой: 0.
Сохранено 35 предупреждений о библиотеке: независимо проверено,
что они относятся исключительно к печатным контурам, обрезанным возле площадок.
Правила DRC не отключались. Полные исходные отчёты находятся в `checks/`.

Gerber и Excellon повторно прочитаны независимым CAM-парсером: 4 слоя,
контур 100.10 × 100.10 мм. Обзоры CAM_top.svg/CAM_bottom.svg получены
из производственных файлов. Контрольные суммы всех файлов — в manifest.json.

Часть позиционных надписей имеет высоту 0,8 мм при штрихе 0,15 мм — абсолютный
минимум из рекомендаций JLCPCB; рекомендуемая высота 1 мм. При заказе сверить
предпросмотр шелкографии. [Источник](https://jlcpcb.com/blog/character-design-specifications).

Это первый прототип. Корпус, формовка выводов RGB, фактические разъёмы,
нагрев, минимальный PWM и прошивка INA238 требуют стендовых проверок.
Плату подключать сначала к лабораторному БП с ограничением тока;
см. ../../review/Bench_checklist.md. Это не заказ и не оплата производства.
