nikolajevs/PCB_EU/hardware/PCB_EU/fabrication/2026-10-24-b3f286d/PCB_EU_Gerber_copper.png

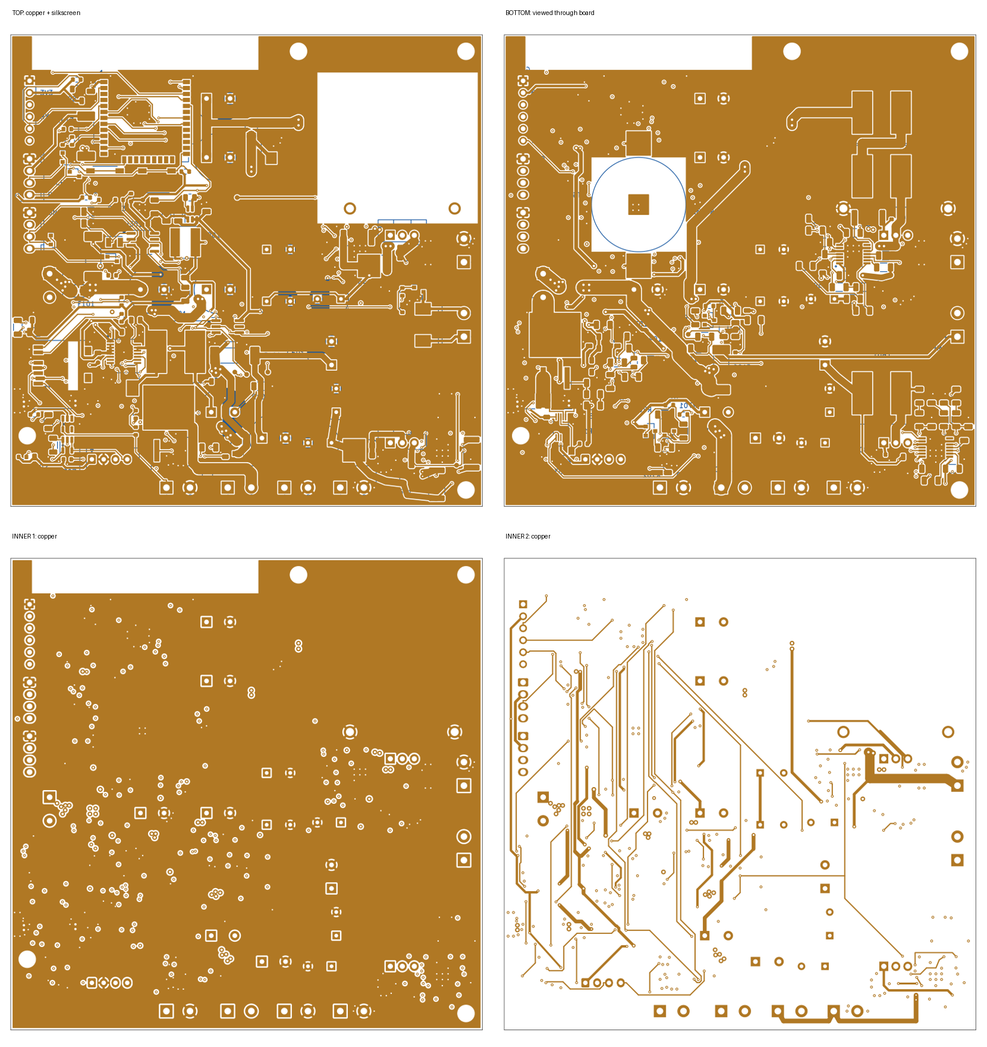
hardware/PCB_EU/fabrication/2026-10-24-b3f286d/PCB_EU_Gerber_copper.png
