nikolajevs/PCB_EU/hardware/PCB_EU/fabrication/2026-10-24-b3f286d/PCB_EU_Gerber_mask_silk.png

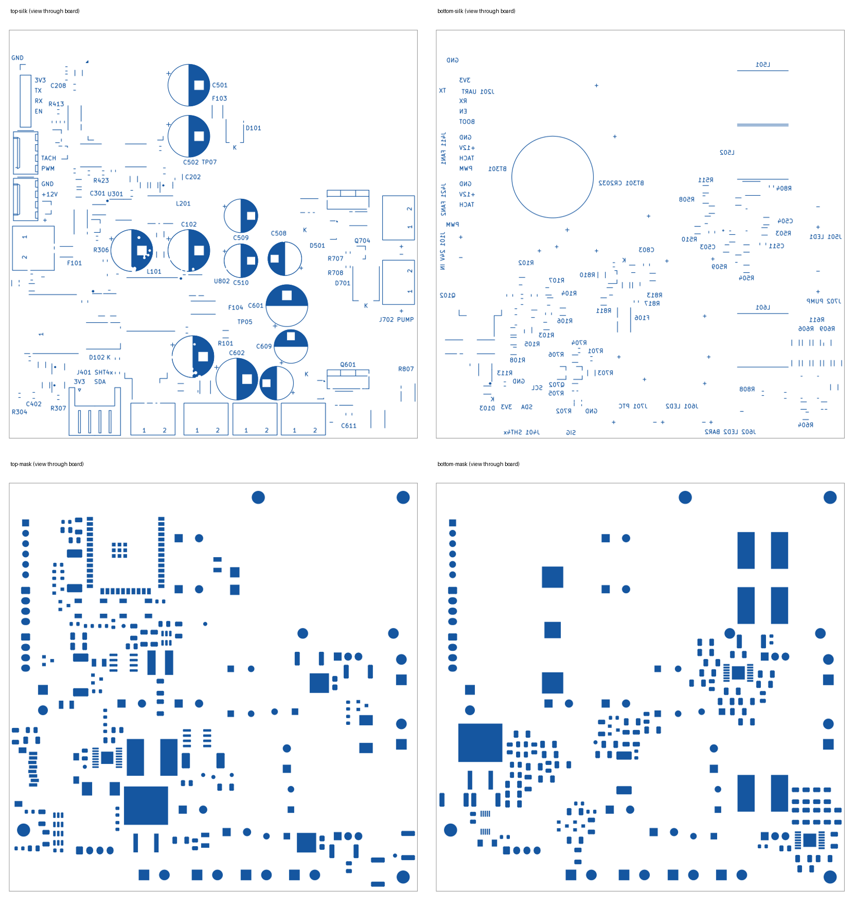
hardware/PCB_EU/fabrication/2026-10-24-b3f286d/PCB_EU_Gerber_mask_silk.png
