nikolajevs/PCB_EU/hardware/PCB_EU_LITE/fabrication/2026-10-25-r1/preview_top.png

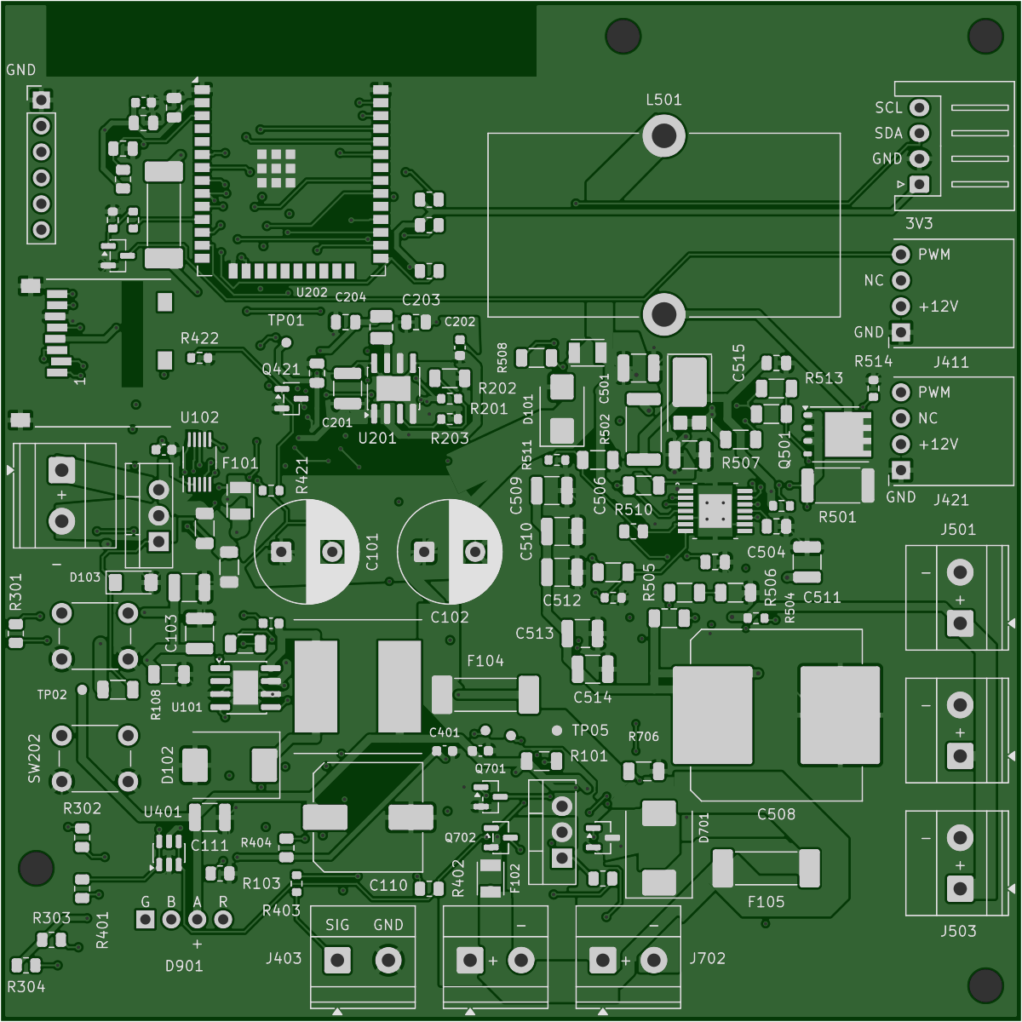
hardware/PCB_EU_LITE/fabrication/2026-10-25-r1/preview_top.png
