nikolajevs/PCB_EU/hardware/PCB_EU_LITE/fabrication/2026-10-26-r2/preview_bottom.png

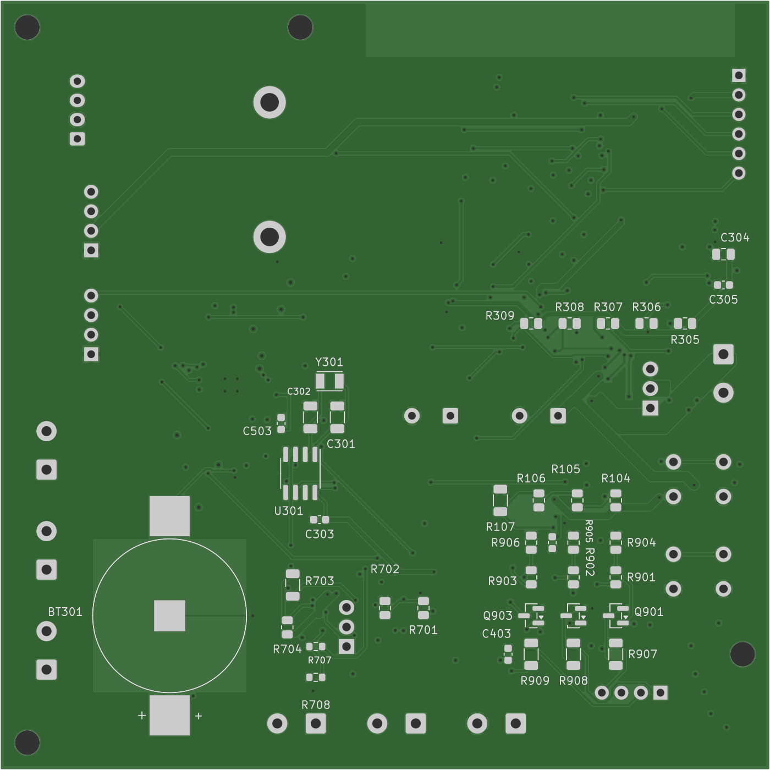
hardware/PCB_EU_LITE/fabrication/2026-10-26-r2/preview_bottom.png
