nikolajevs/PCB_EU/(list of files, drawings)

Other design files:
hardware/PCB_EU/fabrication/2026-10-24-b3f286d/PCB_EU_Gerber_manifest.json
hardware/PCB_EU/review/pcb_drc.json
