nikolajevs/PCB_EU/(commit log)

2026-10-23 Initial import of PCB_EU hardware and firmware
    [BOM_allocated.csv, Control.kicad_sch, InputPower.kicad_sch, Interfaces.kicad_sch, LED1.kicad_sch, LED2.kicad_sch, Loads.kicad_sch, MCU.kicad_sch]
2026-10-23 Simplify dashboard labels and move sensor badge
2026-10-24 Port SS8PH10, ZL201-10G and terminal block changes from nikolajevs/ai PR #94
    Apply the 20-file diff of nikolajevs/ai PR #94 (commit 63c79ad, merged as
    7fa9410) on top of the 390374e import. Igors approved all three steps from
    the 2026-10-23 shop price review (BOM 84.67 -> 81.25 EUR):
    - D501/D601: SS5P10-M3/86A -> SS8PH10-M3/86A at Electrobase (same TO-277A
    land pattern, footprint and 3D model unchanged).
    - J201: ZL2019-20 -> ZL201-10G at Salvats, cut 6 of 10 positions.
    - DG306 bought 6 instead of 11, DG301R 1 instead of 2 (no spares).
    hardware/PCB_EU now equals nikolajevs/ai at 7fa9410 except the two links
    to PCB_V1 files in DESIGN.md and libraries/SOURCES.md that the import
    rewrote. Rep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
    [BOM_allocated.csv, LED1.kicad_sch, LED2.kicad_sch, MCU.kicad_sch, PCB_EU.kicad_pcb, pcb_drc.json]
2026-10-24 Reconcile BOM procurement confirmations and home stock
    [BOM_allocated.csv]
2026-10-24 Add printable PETG enclosure for PCB_EU
    [PCB_EU_base.step, PCB_EU_base_coupon_print.stl, PCB_EU_base_print.stl, PCB_EU_lid.step, PCB_EU_lid_coupon_print.stl, PCB_EU_lid_print.stl]
2026-10-24 Archive ordered PCB fabrication files and record order
    [PCB_EU_Gerber_manifest.json]
2026-10-24 Replace dead-link KEMET 100n/100V with Samsung CL21B104KCFSFNE
    The Electrobase card for C0805C104K1RACTU no longer opens. Use the
    equivalent Samsung 100 nF / 100 V / X7R 0805 (0.12 EUR, live card) for
    C511 and C611; BOM total is now 81.17 EUR.
    [BOM_allocated.csv, LED1.kicad_sch, LED2.kicad_sch, PCB_EU.kicad_pcb]
2026-10-24 Add printable top and bottom solder-paste stencils for a 0.2 mm nozzle
    Two FDM stencils (F.Paste 290 apertures, B.Paste 205) for the 100x100 mm
    board: 0.12 mm film with a 0.96 mm skirt that locates it on the board edge.
    Apertures are taken from the pad paste polygons of PCB_EU.kicad_pcb
    (export_apertures.py -> apertures.json), the geometry is built with CadQuery
    (stencil.py). check_stencil.py checks the aperture rules, the STL meshes and
    the registration against review/PCB_EU_assembly.step. A small coupon with
    the finest apertures (U102) is included for the first print.
    [PCB_EU_stencil_bottom_print.stl, PCB_EU_stencil_coupon_print.stl, PCB_EU_stencil_top_print.stl]
2026-10-24 Add EU-LITE: cheaper analogue of EU-0.1 from owner stock
    New project hardware/PCB_EU_LITE with schematic, design.json, stock+purchase
    BOM and script checks (no KiCad available, no PCB). One LM3429 LED channel,
    no fan tachometers, ST1S14/ST1S10 buck converters, INA238 and IRL2505 reverse
    protection from stock; purchases from the Salvats/Electrobase catalogue
    snapshot, 34.50 EUR with delivery against 81.17 EUR for EU-0.1. EU-0.1 files
    are unchanged. ERC, footprints, PCB, firmware and bench tests are not done.
    Claude-Session: https://claude.ai/code/session_013vgne5bRQcg5JyL7FL8xv5
    [Aux12V.kicad_sch, BOM_allocated.csv, InputPower.kicad_sch, Interfaces.kicad_sch, LED.kicad_sch, Loads.kicad_sch, MCU.kicad_sch, PCB_EU_LITE.kicad_sch]
2026-10-24 Add RGB status LED to EU-LITE
    Common-anode 5 mm RGB LED on +12V, three BC847B low-side switches driven from
    GPIO4/16/17 (about 4.9/4.4/4.4 mA per channel, dark during reset). New
    Status sheet, 56 script checks (5 more), 5 more mutation cases. The LED is in
    neither the stock nor the catalogue snapshot: its BOM line has no price (the
    estimate is stated separately). Docs carry a proposed status colour table; the
    firmware is not changed.
    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
    [BOM_allocated.csv, MCU.kicad_sch, PCB_EU_LITE.kicad_sch, Status.kicad_sch]
2026-10-24 Verify EU-LITE datasheet pinouts against primary PDFs
    Checked ST1S14, ST1S10, INA238, BSC146N10LS5 and SBRT15U100SP5
    pin tables and key electrical parameters against the manufacturers'
    primary datasheets; no discrepancies found. Updates open question #1
    in DESIGN.md and the corresponding caveat in README.md.
2026-10-24 Fix EU-LITE footprint library resolution, verify ERC clean
    fp-lib-table did not register a "Package_SO" library, so INA238's
    custom VSSOP-10 footprint failed to resolve. Aliasing Package_SO to
    PCB_EU's copy would have shadowed the stock exposed-pad SOIC-8
    footprint that ST1S14/ST1S10 need from KiCad's bundled library.
    Instead, move the two project-custom footprints (VSSOP-10 for INA238,
    plain SOIC-8 for the MCP7940N RTC) into EU-LITE's own LITE_Parts
    library with their 3D models, update generate.py accordingly, and
    regenerate. Schematic and BOM are unchanged.
    ERC (KiCad CLI 10.0.5): 0 violations. verify.py, check_schematics.py
    and test_verify.py re-run clean.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
    [InputPower.kicad_sch, Peripherals.kicad_sch]
2026-10-24 Build an unrouted EU-LITE PCB skeleton from EU-0.1's board
    Adds tools/build_board.py, modeled on cheap-version's make_board.py:
    loads ../PCB_EU/PCB_EU.kicad_pcb, strips all copper, drops the 63
    EU-0.1-only footprints, replaces 73 common refs' footprints in place
    (position and side kept) to match the EU-LITE netlist, keeps EU-0.1's
    4 mounting holes, drops its heatsink legs (EU-LITE has no heatsink),
    and parks the 28 refs with no EU-0.1 counterpart (RGB status
    indicator and its passives) in a staging area outside the 100x100 mm
    outline. Output: 161 netlisted footprints + 4 holes, no copper.
    Also copies the 27 stock KiCad footprints the schematic references
    into the project's own libraries/ an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
    [PCB_EU_LITE.kicad_pcb]
2026-10-24 Place EU-LITE components on top with the battery underneath
    [PCB_EU_LITE.kicad_pcb, PCB_EU_LITE.kicad_sch]
2026-10-25 Move EU-LITE connectors to edges and add right-angle fan headers
    [Interfaces.kicad_sch, PCB_EU_LITE.kicad_pcb]
2026-10-25 Refine EU-LITE placement and select RGB LED
    [BOM_allocated.csv, PCB_EU_LITE.kicad_pcb, Status.kicad_sch]
2026-10-25 Replace EU-LITE PTC MOSFET with TO-220 part
    [BOM_allocated.csv, InputPower.kicad_sch, Interfaces.kicad_sch, Loads.kicad_sch, PCB_EU_LITE.kicad_pcb]
2026-10-25 WIP: route EU-LITE power and signal nets
    [PCB_EU_LITE.kicad_pcb]
2026-10-25 Route LED CSH and relocate LED bypass cap
    [PCB_EU_LITE.kicad_pcb]
2026-10-25 Route EU-LITE logic switch node
    [PCB_EU_LITE.kicad_pcb]
2026-10-25 Move and route LITE RTC cluster near battery
    [PCB_EU_LITE.kicad_pcb, Peripherals.kicad_sch]
2026-10-25 Shorten LITE switch loop and connect ground islands
    [PCB_EU_LITE.kicad_pcb]
2026-10-25 Finish EU-LITE LED routing and parallel outputs
    [BOM_allocated.csv, InputPower.kicad_sch, LED.kicad_sch, PCB_EU_LITE.kicad_pcb, PCB_EU_LITE.kicad_sch]
2026-10-25 Strengthen high-current copper pours
    [PCB_EU_LITE.kicad_pcb]
2026-10-25 Reinforce PTC supply copper
    [PCB_EU_LITE.kicad_pcb]
2026-10-25 Extend fused 24V distribution pour
    [PCB_EU_LITE.kicad_pcb]
2026-10-25 Add local copper around return switch
    [PCB_EU_LITE.kicad_pcb]
2026-10-25 Strengthen INA238 return path
    [PCB_EU_LITE.kicad_pcb]
2026-10-25 Expand Q102 return copper pour
    [PCB_EU_LITE.kicad_pcb]
2026-10-25 Widen fused 24V distribution copper
    [PCB_EU_LITE.kicad_pcb]
2026-10-25 Widen F102 fused feeder copper
    [PCB_EU_LITE.kicad_pcb]
2026-10-25 Widen source side of fused 24V bus
    [PCB_EU_LITE.kicad_pcb]
2026-10-25 Strengthen PTC and LED input copper
    [PCB_EU_LITE.kicad_pcb]
2026-10-25 Widen PTC supply and return tracks
    [PCB_EU_LITE.kicad_pcb]
2026-10-25 Reinforce EU-LITE input power path
    [PCB_EU_LITE.kicad_pcb]
2026-10-25 Reinforce raw input copper
    [PCB_EU_LITE.kicad_pcb]
2026-10-25 Reinforce LED input copper
    [PCB_EU_LITE.kicad_pcb]
2026-10-25 Reinforce return and LED terminal copper
    [PCB_EU_LITE.kicad_pcb]
2026-10-25 Add Q102 thermal copper
    [PCB_EU_LITE.kicad_pcb]
2026-10-25 Add EU-LITE assembly silkscreen
    [PCB_EU_LITE.kicad_pcb]
2026-10-25 Refine EU-LITE assembly silkscreen
    [PCB_EU_LITE.kicad_pcb]
2026-10-25 Add verified periodic LED boost power-stage simulation
2026-10-25 Correct EU-LITE Kelvin routing and prepare prototype fabrication checks
    [PCB_EU_LITE.kicad_pcb]
2026-10-25 Publish reviewed EU-LITE prototype Gerber package
    [PCB_EU_LITE-B_Cu.gbl, PCB_EU_LITE-B_Mask.gbs, PCB_EU_LITE-B_Silkscreen.gbo, PCB_EU_LITE-Edge_Cuts.gm1, PCB_EU_LITE-F_Cu.gtl, PCB_EU_LITE-F_Mask.gts, PCB_EU_LITE-F_Silkscreen.gto, PCB_EU_LITE-NPTH.drl]
2026-10-25 Fit eleven additional EU-LITE reference designators into clear gaps
    [PCB_EU_LITE.kicad_pcb]
2026-10-25 Release EU-LITE silkscreen revision with added references
    [PCB_EU_LITE-B_Cu.gbl, PCB_EU_LITE-B_Mask.gbs, PCB_EU_LITE-B_Silkscreen.gbo, PCB_EU_LITE-Edge_Cuts.gm1, PCB_EU_LITE-F_Cu.gtl, PCB_EU_LITE-F_Mask.gts, PCB_EU_LITE-F_Silkscreen.gto, PCB_EU_LITE-NPTH.drl]
2026-10-26 Fix EU-LITE power copper paths and via placement
    [PCB_EU_LITE.kicad_pcb]
2026-10-26 Correct F103 USI fast fuse annotation without changing connectivity
    [InputPower.kicad_sch]
